mfkiwl/ADC_Test-icd40hx/doc/vm_mini-master/images/UoFq0qp.jpg

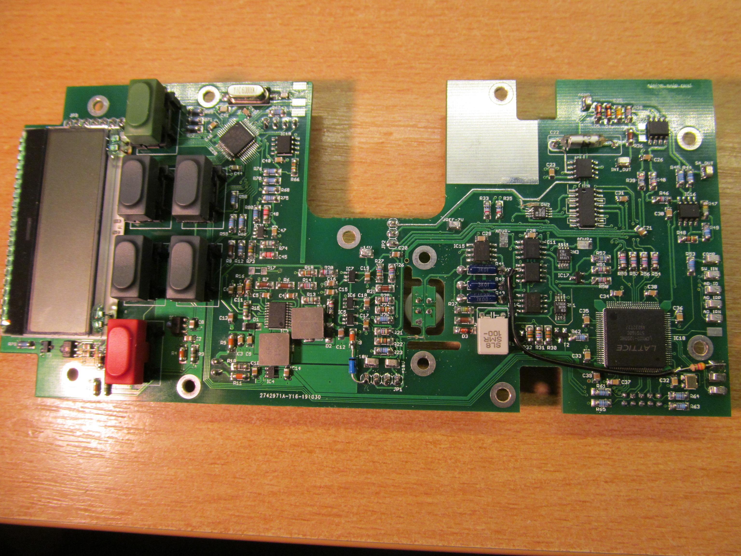
doc/vm_mini-master/images/UoFq0qp.jpg
