mfkiwl/ADC_Test-icd40hx/doc/vm_mini-master/images/A4J0f3j.jpg

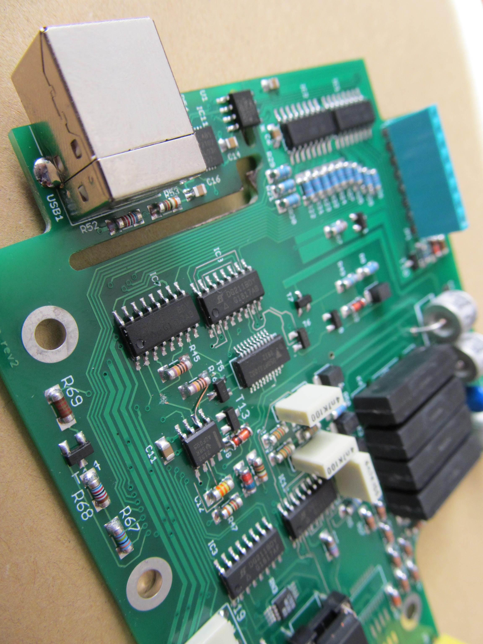
doc/vm_mini-master/images/A4J0f3j.jpg
