mfkiwl/ADC_Test-icd40hx/doc/vm_mini-master/images/3wzWLv2.jpg

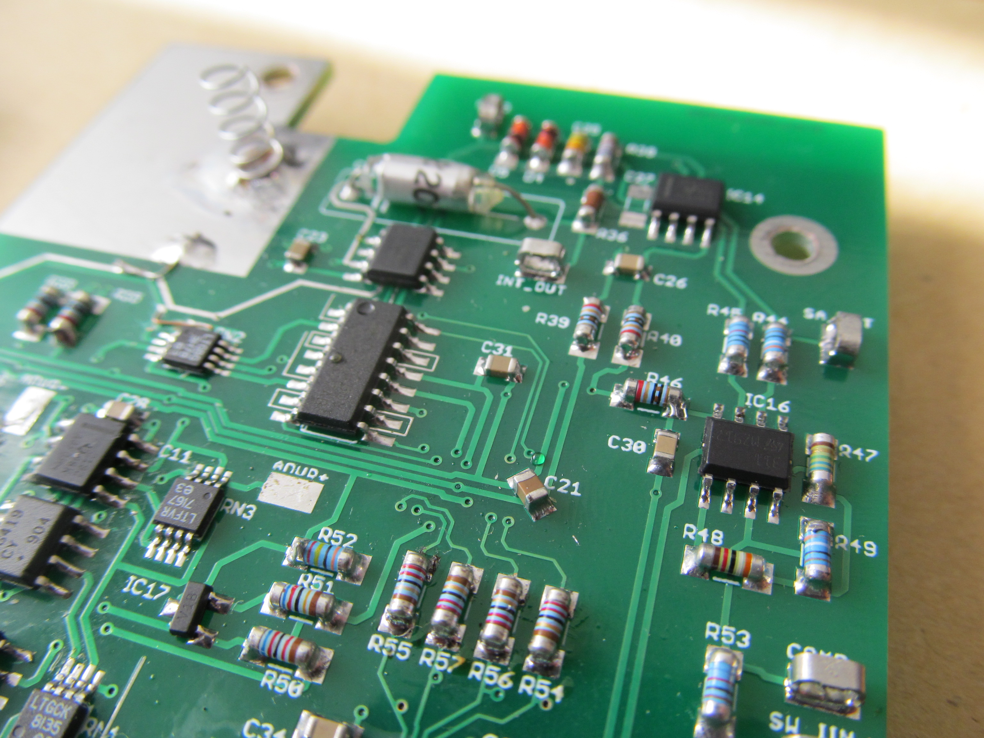
doc/vm_mini-master/images/3wzWLv2.jpg
