mfkiwl/ADC_Test-icd40hx/doc/vm_mini-master/images/9xUZhGH.jpg

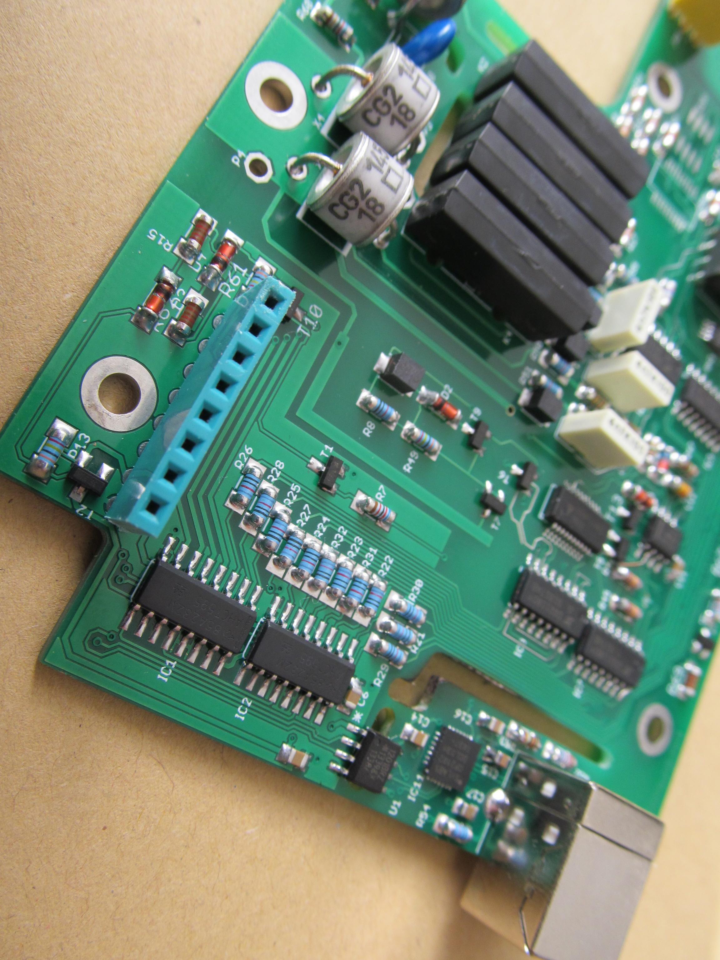
doc/vm_mini-master/images/9xUZhGH.jpg
