mfkiwl/ADC_Test-icd40hx/doc/vm_mini-master/images/bQ4KAHR.jpg

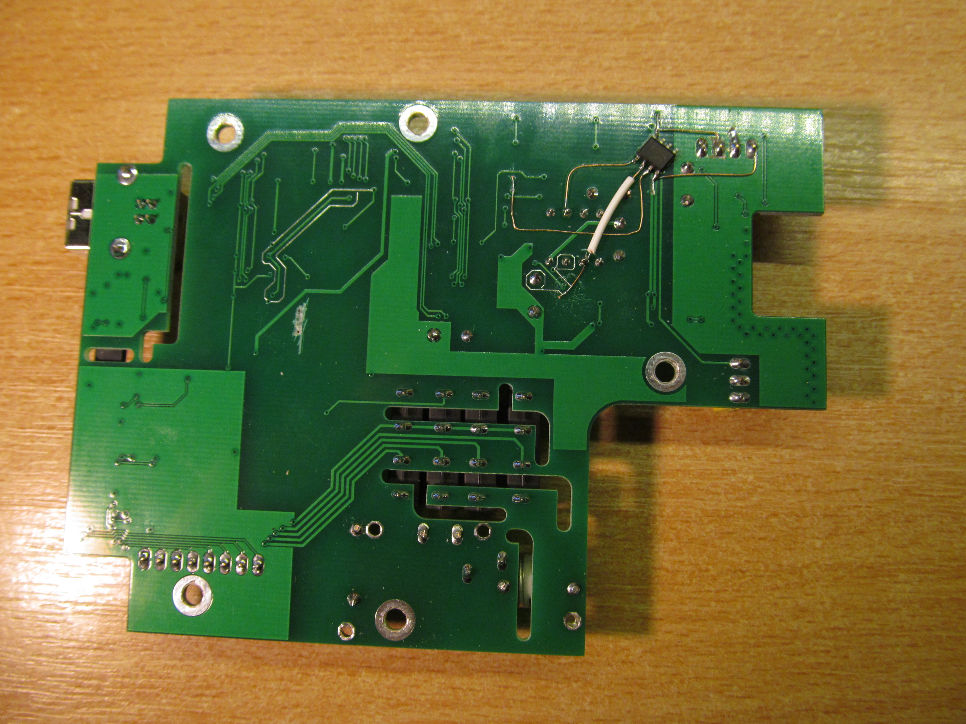
doc/vm_mini-master/images/bQ4KAHR.jpg
