mfkiwl/ADC_Test-icd40hx/doc/vm_mini-master/images/dow7Ubh.jpg

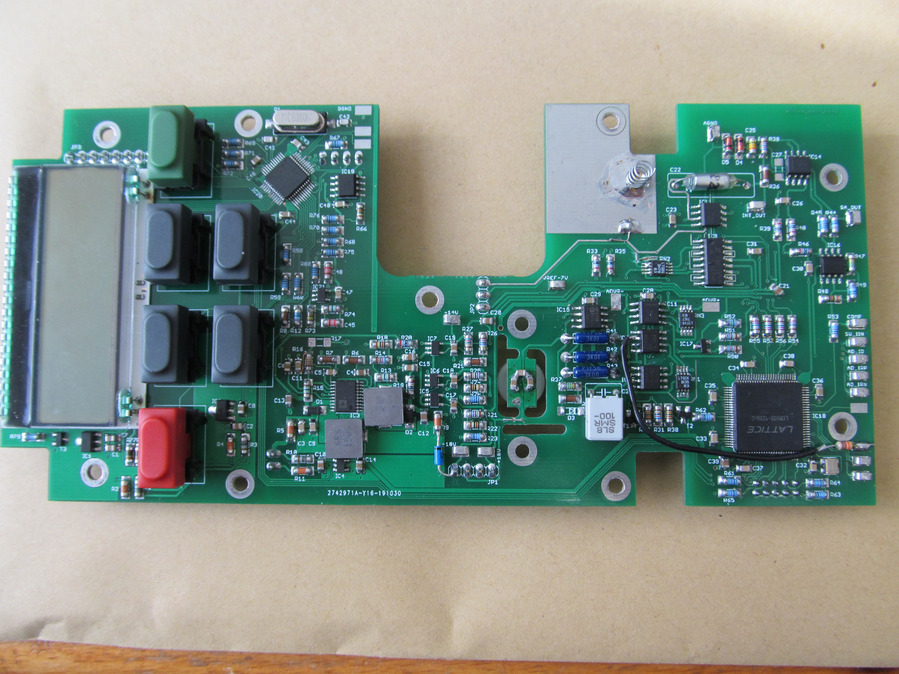
doc/vm_mini-master/images/dow7Ubh.jpg
