mfkiwl/ADC_Test-icd40hx/doc/vm_mini-master/images/f6qNfNS.jpg

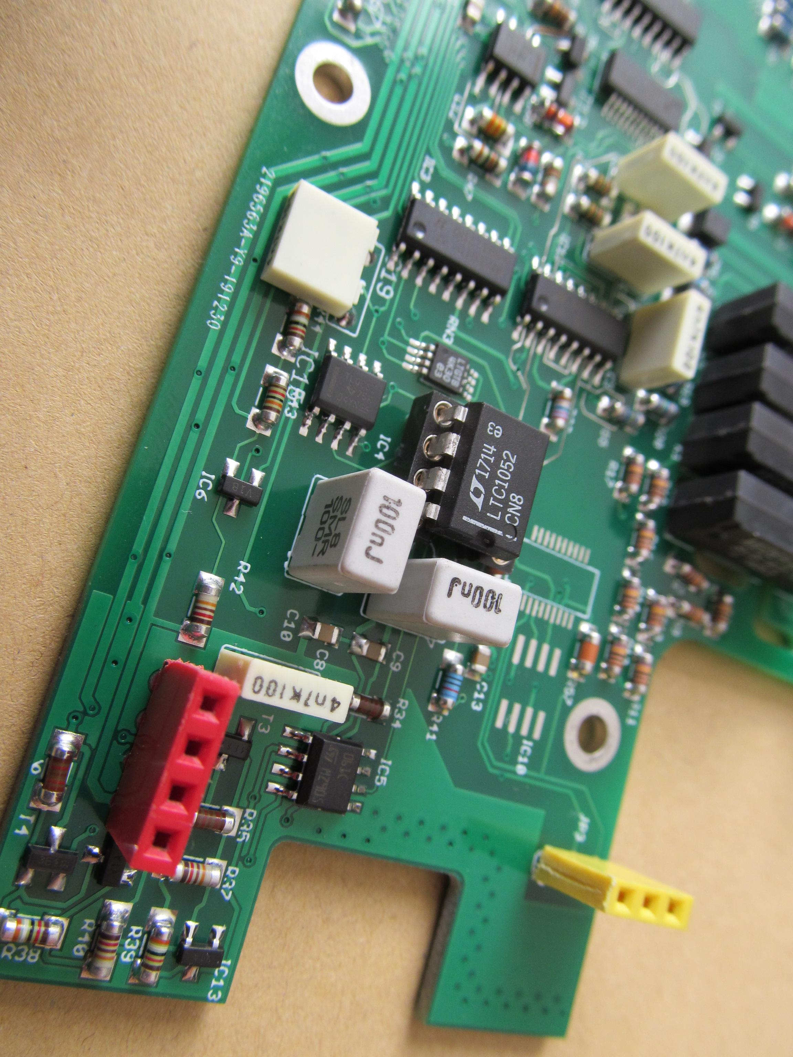
doc/vm_mini-master/images/f6qNfNS.jpg
