mfkiwl/ADC_Test-icd40hx/doc/vm_mini-master/images/KRb7c2h.jpg

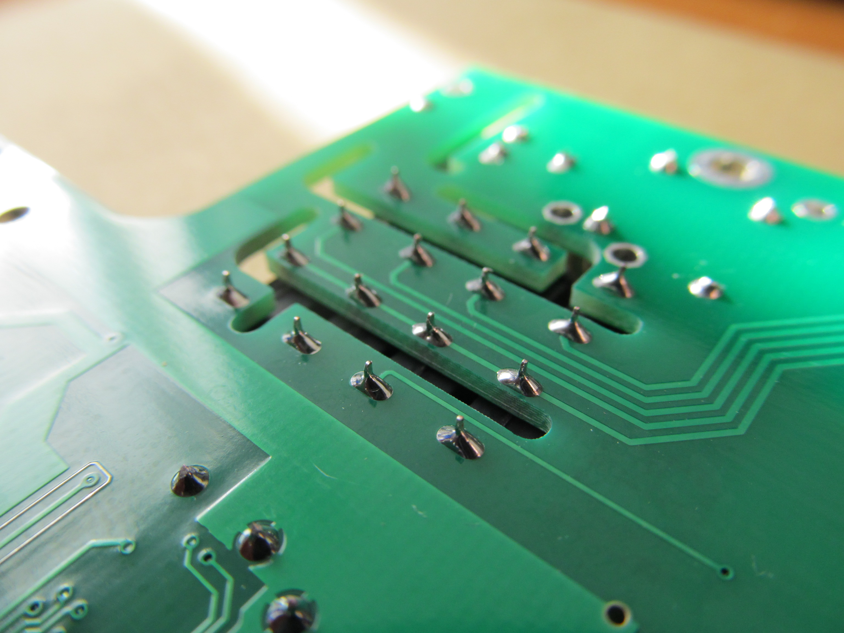
doc/vm_mini-master/images/KRb7c2h.jpg
