mfkiwl/ADC_Test-icd40hx/doc/vm_mini-master/images/mZM4EhI.jpg

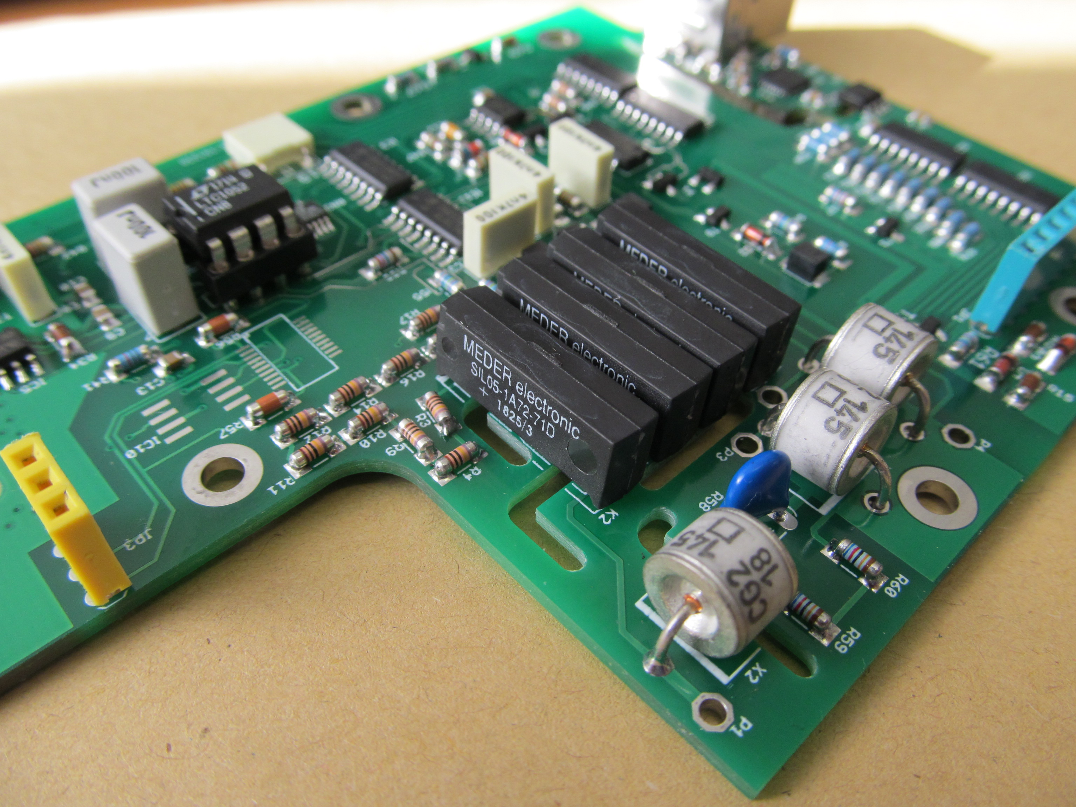
doc/vm_mini-master/images/mZM4EhI.jpg
