mfkiwl/ADC_Test-icd40hx/doc/vm_mini-master/images/Qvy92Fx.jpg

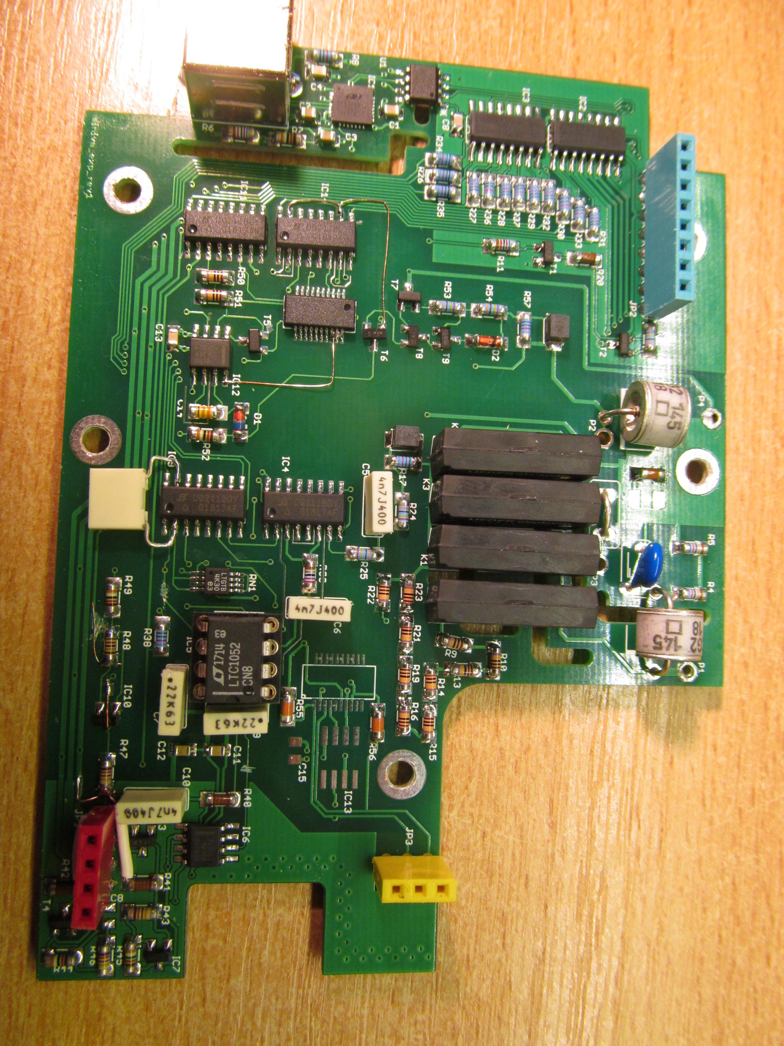
doc/vm_mini-master/images/Qvy92Fx.jpg
