mfkiwl/ADC_Test-icd40hx/doc/vm_mini-master/images/RaeT1ON.jpg

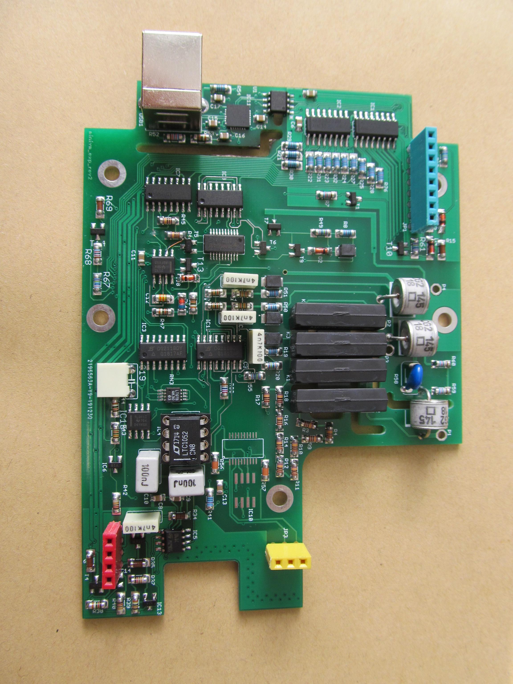
doc/vm_mini-master/images/RaeT1ON.jpg
