mfkiwl/ADC_Test-icd40hx/doc/vm_mini-master/images/WuWtkKE.jpg

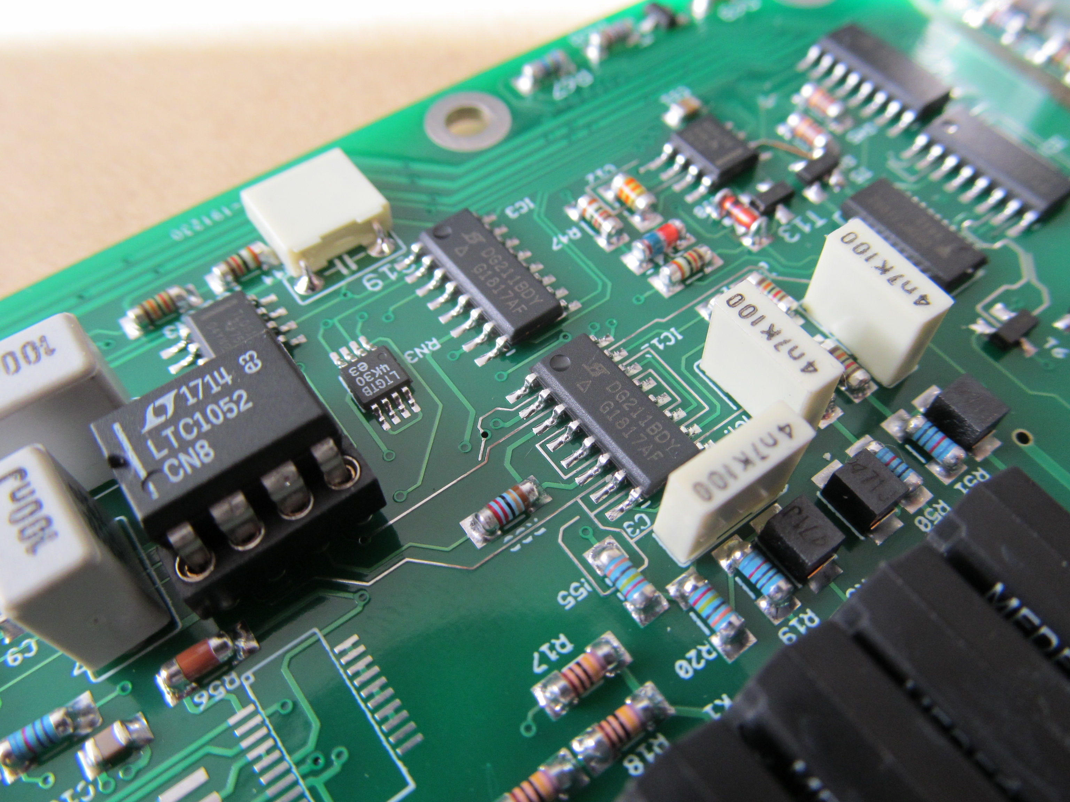
doc/vm_mini-master/images/WuWtkKE.jpg
