mfkiwl/ADC_Test-icd40hx/doc/vm_mini-master/images/ZoOjUOi.jpg

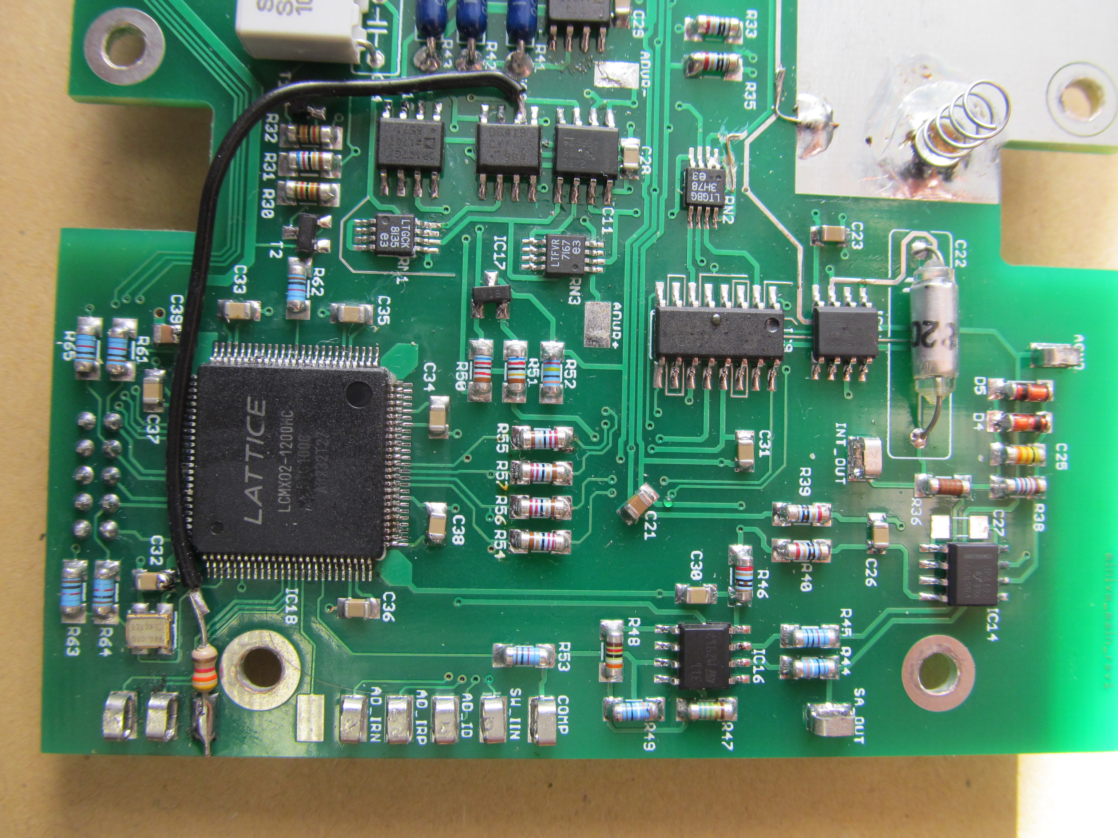
doc/vm_mini-master/images/ZoOjUOi.jpg
