mfkiwl/ADC_Test-icd40hx/doc/vm_mini-master/pcb_eagle/kind_of_BOM/BOM_vm_mini_exp4a.ods

Qty | Value | Package | Parts | dodavatel | link
2 |  | EPCOS_N81 | X1, X2 | TME | https://www.tme.eu/sk/details/cg2-145l/tht-bleskoistky/littelfuse/cg2145l/
1 |  | 1X03 | JP3 | OK
1 |  | 1X04 | JP1 | OK
1 |  | 1X08 | JP2 | OK
1 |  | TE5 | F1 | TME | https://www.tme.eu/sk/details/mf-r050/polymerove-poistky-tht/bourns/
2 | 0R | R_MINIMELF | R55, R56 | E
2 | 100n | C050-025X075 | C7, C9 | TME | https://www.tme.eu/sk/details/smr5104j100j03/polypropylenove-kondenzatory-standardne/kemet/smr5104j100j03l16-5cbulk/
7 | 100n | R0805 | C1, C4, C8, C11, C12, C13, C15 | OK
4 | 12k | R_MINIMELF | R20, R40, R41, R42 | OK
12 | 1M | R_MINIMELF | R9, R10, R13, R14, R15, R16, R19, R21, R22, R23, R50, R51 | E
2 | 1u | R0805 | C2, C3 | OK
5 | 240k | R_MINIMELF | R18, R24, R25, R53, R54 | OK
1 | 330p | R_MINIMELF | C14 | OK
6 | 39k | R_MINIMELF | R7, R44, R45, R48, R49, R52 | OK
3 | 4n7 | C050-025X075 | C5, C6, C10 | TME | https://www.tme.eu/sk/details/mkp2-47n_250-r-5/polypropylenove-kondenzatory-standardne/wima/mkp2f024701c00jssd/
2 | 620K | R_MINIMELF | R4, R5 | OK
17 | 620R | R_MINIMELF | R2, R8, R17, R26, R27, R28, R29, R30, R31, R32, R33, R34, R35, R36, R37, R38, R57 | OK
3 | 62k | R_MINIMELF | R6, R11, R39 | OK
1 | 6v8 | SOD80C | D1 | TME | https://www.tme.eu/sk/details/bzv55-b6v8.115/zenerove-diody-smd/nexperia/
2 | 74AHCT595 | SO16 | IC2, IC3 | MOUS | https://www.mouser.sk/ProductDetail/Texas-Instruments/SN74AHCT595DR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
3 | 93k | R_MINIMELF | R43, R46, R47 | E
1 | AD706 | SO08 | IC12 | MOUS | https://www.mouser.sk/ProductDetail/Texas-Instruments/OPA2192IDR
1 | ADUM1201ARZ | SOIC127P600X175-8N | U1 | OK
1 | BAV103 | SOD-80 | D2 | TME | https://www.tme.eu/sk/details/bav103-gs08/univerzalne-diody-smd/vishay/
2 | BC847 | SOT23 | T1, T3 | OK
2 | BC857 | SOT23 | T2, T4 | OK
2 | BF823 | SOT23 | T8, T9 | TME | https://www.tme.eu/sk/details/bf823.215/tranzistory-pnp-smd/nexperia/
1 | CP2102 | MLP28 | IC1 | MOUS | https://www.mouser.sk/ProductDetail/Silicon-Labs/CP2102N-A02-GQFN28R
4 | DG211 | SO-16 | IC4, IC9, IC11, IC14 | TME | https://www.tme.eu/sk/details/dg211bdy/multiplexory-a-analogove-prepinace/vishay/
4 | HE3621 | HE3621 | K1, K2, K3, K4 | TME | https://www.tme.eu/sk/details/ms05-1a87-75dhr/elektromagneticke-rele-jazyckove/meder/
3 | INDUCTOR_GEN1210 | 1210 | U$2, U$4, U$5 | TME | https://www.tme.eu/sk/details/nlv10jt471/tlmivky-smd-1210/viking/
1 | JFET_N | SOT23 | T7 | TME | https://www.tme.eu/sk/details/mmbfj201/tranzistory-s-kanalom-n-smd/on-semiconductor-fairchild/
1 | LT5400 | MSOP8-EP | RN1 | OK | 9k+1k
1 | LTC1052 | DIL08 | IC5 | OK
1 | MMBFJ110 | SOT23 | T5 | MOUS | https://www.mouser.sk/ProductDetail/ON-Semiconductor-Fairchild/MMBFJ110
1 | MMBFJ175 | SOT23 | T6 | TME | https://www.tme.eu/sk/details/mmbfj175/tranzistory-s-kanalom-p-smd/on-semiconductor-fairchild/
1 | OPA177 | SO08 | IC13 | MOUS | https://www.mouser.sk/ProductDetail/Texas-Instruments/OPA192IDR
2 | OSOP20 | OSOP20 | RN2, RN3 | MOUS | https://www.mouser.sk/ProductDetail/Vishay-Thin-Film/OSOPTA1002AT1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
1 | S05K175 | S05K175 | R3 | TME | https://www.tme.eu/sk/details/siov-s05k95/tht-varistory/epcos/b72205s0950k101/
1 | TL061 | SO08 | IC6 | TME | https://www.tme.eu/sk/details/tl061id/operacne-zosilnovace-smd/texas-instruments/
3 | TLV431 | SOT23 | IC7, IC8, IC10 | TME | https://www.tme.eu/sk/details/tlv431afta/zdroje-napatovej-referencie-obvody/diodes-incorporated/
4 | TPPAD1-17 | P1-17 | P1, P2, P3, P4 | TODO | svorky na 4 vstupy
1 | USB-B-H | USB-B-H | USB1 | OK
