mfkiwl/ADC_Test-icd40hx/doc/vm_mini-master/pcb_eagle/kind_of_BOM/BOM_vm_mini_main3_1.ods

Qty | Value | Package | Parts | dodavatel | link
1 |  | HC49UP | Q1 | OK
2 |  | MINIMELF | D1, D2 | TME | https://www.tme.eu/sk/details/mbr0540t1g/diody-schottky-smd/on-semiconductor/
1 |  | 1X03 | JP2 | OK
1 |  | 1X04 | JP1 | OK
1 |  | 1X04/90 | JP4 | OK
1 |  | 1X08 | JP3 | OK
4 | 0R | R_MINIMELF | R2, R4, R9, R11 | E
1 | 100n | C050-035X075 | C24 | TME | https://www.tme.eu/sk/details/smr5104j100j03/polypropylenove-kondenzatory-standardne/kemet/smr5104j100j03l16-5cbulk/
21 | 100n | R0805 | C3, C9, C11, C23, C26, C28, C29, C30, C31, C32, C33, C34, C35, C36, C37, C38, C40, C43, C44, C46, C47 | OK
7 | 10R | R_MINIMELF | R19, R20, R33, R35, R39, R40, R46 | E
3 | 10u | R0805 | C12, C13, C39 | OK
3 | 120k | R_MINIMELF | R16, R30, R32 | OK
6 | 12k | R_MINIMELF | R6, R7, R12, R29, R34, R36 | OK
4 | 1R8 | R_MINIMELF | R1, R3, R5, R10 | E
2 | 1n8 | R_MINIMELF | C45, C48 | OK
22 | 1u | R0805 | C1, C2, C6, C7, C8, C10, C14, C15, C16, C17, C18, C19, C20, C21, C49, C50, C51, C52, C53, C54, C55, C56 | OK
1 | 22-05-7028-02 | 7395-02 | J1 | OK
1 | 240k | R_MINIMELF | R52 | OK
3 | 2M4 | R_MINIMELF | R13, R15, R74 | E
1 | 2n2 | C150-054X183 | C22 | OK | polystyren
1 | 33p | R_MINIMELF | C25 | OK
2 | 33p | R0805 | C41, C42 | OK
2 | 390R | R_MINIMELF | R77, R79 | OK
5 | 39k | R_MINIMELF | R18, R22, R24, R48, R66 | OK
2 | 3k01 | R_TR191 | R41, R42 | MOUS | https://www.mouser.sk/ProductDetail/Vishay-Dale/PTF563K0100BZBF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
3 | 3k9 | R_MINIMELF | R8, R44, R49 | OK
1 | 47k | R_MINIMELF | R26 | E
1 | 47n | R0805 | C4 | TME | https://www.tme.eu/sk/details/c0805c473j5rac/kondenzatory-mlcc-smd-0805/kemet/c0805c473j5ractu/
2 | 620R | R_MINIMELF | R45, R80 | OK
5 | 620k | R_MINIMELF | R21, R25, R27, R31, R51 | OK
2 | 62R | R_MINIMELF | R37, R47 | E
3 | 62k | R_MINIMELF | R14, R38, R50 | OK
1 | 68n | R0805 | C5 | TME | https://www.tme.eu/sk/details/c0805c683k5rac/kondenzatory-mlcc-smd-0805/kemet/c0805c683k5ractu/
1 | 6M2 | R_MINIMELF | R73 | OK
24 | 6k2 | R_MINIMELF | R23, R28, R53, R54, R55, R56, R57, R58, R59, R60, R61, R62, R63, R64, R65, R67, R68, R69, R70, R71, R72, R75, R76, R78 | OK
1 | 6k95 | R_TR191 | R43 | MOUS | https://www.mouser.sk/ProductDetail/Vishay-Dale/PTF567K0000BYEK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
1 | 93k | R_MINIMELF | R17 | E
1 | ADP5070 | TSSOP20-EP | IC3 | SAM
1 | ADP7142 | SOT23-5L | IC5 | MOUS | https://www.mouser.sk/ProductDetail/Analog-Devices-Linear-Technology/ADP7142AUJZ-R7
2 | ADP7182 | SOT23-5L | IC6, IC7 | SAM
3 | BAV103 | SOD-80 | D3, D4, D5 | TME | https://www.tme.eu/sk/details/bav103-gs08/univerzalne-diody-smd/vishay/
2 | BC847 | SOT23 | T1, T3 | OK
1 | BC857 | SOT23 | T2 | OK
1 | DG211B | SO16 | IC9 | TME | https://www.tme.eu/sk/details/dg211bdy/multiplexory-a-analogove-prepinace/vishay/
1 | DG419DJD | SO08 | IC8 | MOUS | https://www.mouser.sk/ProductDetail/Vishay-Siliconix/DG419LEDY-T1-GE4
1 | DNP | R_MINIMELF | C27 | OK
1 | EADOGM132-5 | EADOGM | LCD1 | TODO
1 | FLASH_SPI | SO-08 | IC19 | TME | https://www.tme.eu/sk/details/at25sf081-sshdt/pamate-flash-seriove/adesto/at25sf081-sshd-t/
1 | IDC_10_2MM | IDC_20_10P | CON1 | TME | https://www.tme.eu/sk/details/ds1014-10sf1b/konektory-idc/connfly/ | https://www.tme.eu/sk/details/ds1017-10ma2/konektory-idc/connfly/
2 | SRP7030 | BOURNS_SRP7030 | L1, L2 | MOUS | https://www.mouser.sk/ProductDetail/Bourns/SRP7030CA-3R3M | https://www.mouser.sk/ProductDetail/Bourns/SRP7030CA-6R8M
1 | LM311D | SO08 | IC16 | TME | https://www.tme.eu/sk/details/lm311d-st/komparatory-smd/stmicroelectronics/lm311d/
1 | LM399H | TO39/4 | IC13 | OK
1 | LT5400-100k-100k | MSOP8-EP | RN2 | OK
1 | LT5400-10k+10k | MSOP8-EP | RN3 | OK
1 | LT5400-5k-1k | MSOP8-EP | RN1 | SAM
1 | MACHXO2-1200 | TQFP100 | IC18 | OK
1 | MCP1703-33 | SOT89 | IC2 | TME | https://www.tme.eu/sk/details/mcp1703t-3302e_mb/stabilizatory-napatia-neregulovane-ldo/microchip-technology/
1 | MCP1703-50\ | SOT89 | IC1 | TME | https://www.tme.eu/sk/details/mcp1703at-5002e_mb/stabilizatory-napatia-neregulovane-ldo/microchip-technology/
1 | MCP6041 | SOT23-5L | IC21 | OK
1 | NJM2866F33 | SOT23-5 | IC4 | MOUS | https://www.mouser.sk/ProductDetail/NJR/NJM2866F33-TE1
1 | OP184 | SO08 | IC14 | MOUS | https://www.mouser.sk/ProductDetail/Texas-Instruments/OPA192IDR
1 | OP284 | SO08 | IC11 | MOUS | https://www.mouser.sk/ProductDetail/Texas-Instruments/OPA2192IDR
1 | OPA140 | SO08 | IC12 | MOUS | https://www.mouser.sk/ProductDetail/Texas-Instruments/OPA140AIDR
2 | OPA177 | SO08 | IC10, IC15 | OK
1 | OSC3225 | OSC_3225 | OSC1 | MOUS | https://www.mouser.sk/ProductDetail/Kyocera-Electronic-Components/KC3225A400000C30E00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
1 | STM32L152XC_LQFP48 | LQFP48 | IC20 | TME | https://www.tme.eu/sk/details/stm32l151cbt6a/mikroprocesory-st/stmicroelectronics/
6 | SWITCH_MINI6450 | SWITCH_6450 | K1, K2, K3, K4, K5, K6 | OK
21 | TEST_PADSMD_35X2 | TP_SMD_35X2 | TP1, TP2, TP3, TP4, TP5, TP6, TP7, TP8, TP9, TP10, TP11, TP12, TP13, TP14, TP15, TP16, TP17, TP18, TP19, TP20, TP21 | MOUS | https://www.mouser.sk/ProductDetail/Harwin/S1751-46R?qs=sGAEpiMZZMsGzNf1qgY4ZDEfKDfH1s5L
1 | TL431_SOT23 | SOT23 | IC17 | TME | https://www.tme.eu/sk/details/tlv431afta/zdroje-napatovej-referencie-obvody/diodes-incorporated/
 |  |  |  | TME | 1mm IDC kabel
 |  |  |  | .
