mfkiwl/ADC_Test-icd40hx/doc/vm_mini-master/mech/LM399_cover_part2.stl

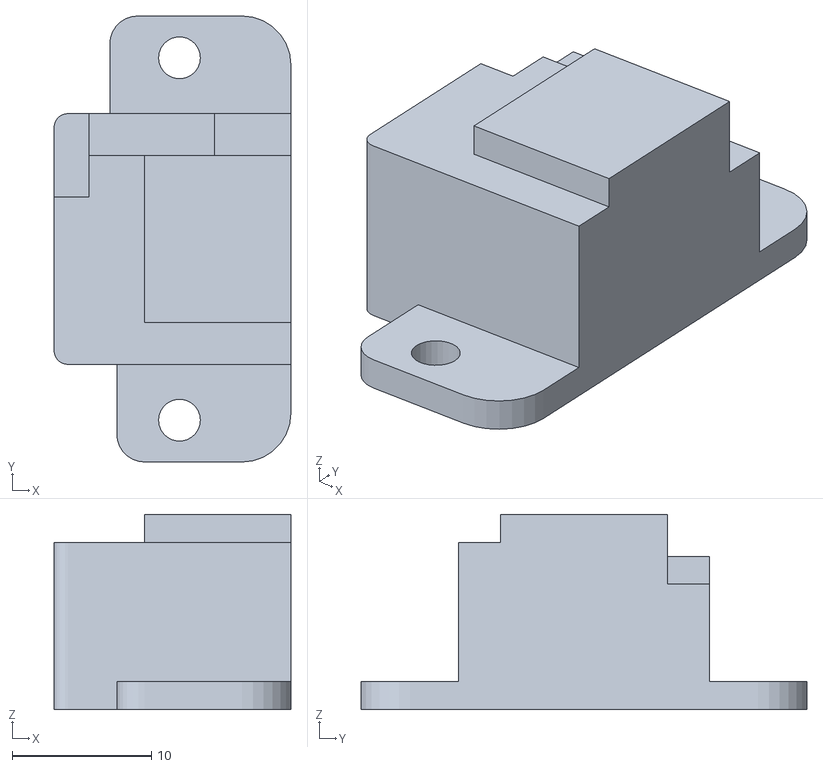
[picture p14: CAD file, 2020-10-08]
doc/vm_mini-master/mech/LM399_cover_part2.stl
17.0 x 32.0 x 14.0
