mfkiwl/ADC_Test-icd40hx/doc/vm_mini-master/mech/LM399_cover_part1.stl

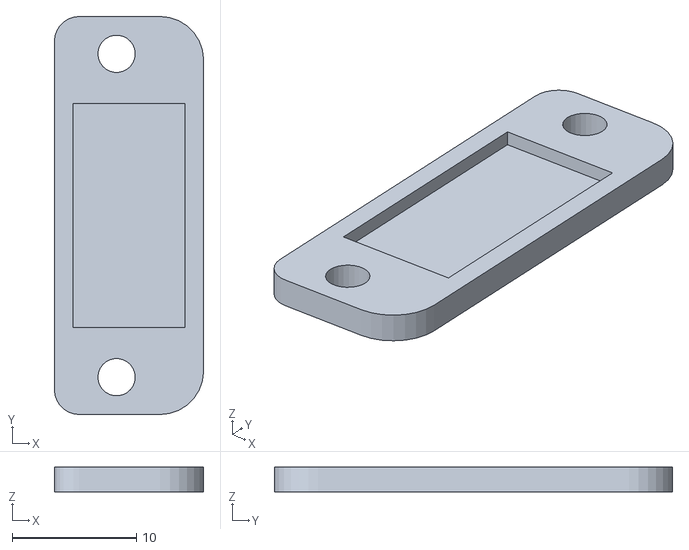
[picture p15: CAD file, 2020-10-08]
doc/vm_mini-master/mech/LM399_cover_part1.stl
12.0 x 32.0 x 2.00
