mfkiwl/ADC_Test-icd40hx/hardware/project/ADC_Test/ADC_Test_Add.ods

R_0603_1608Metric_Pad1.05x0.95mm_HandSolder | 1 | 3k01/.1%
SOIC-8_3.9x4.9mm_P1.27mm | 1 | LT1021-7
SOT-23 | 2 | MMBTA55
D_SOD-523 | 5 | BZT585B15TQ-13
R_0603_1608Metric_Pad1.05x0.95mm_HandSolder | 4 | 4k7/.1%
R_0603_1608Metric_Pad1.05x0.95mm_HandSolder | 10 | 0
 | 1 | 9012
D_SOD-123 | 1 | 1N4148W
 |  | 10p
R_0603_1608Metric_Pad1.05x0.95mm_HandSolder |  | 10k
SOT-23 |  | BC847
 | 20 | 5050462-8
