mfkiwl/ADC_Test-icd40hx/doc/schem_pdf_rev11.pdf

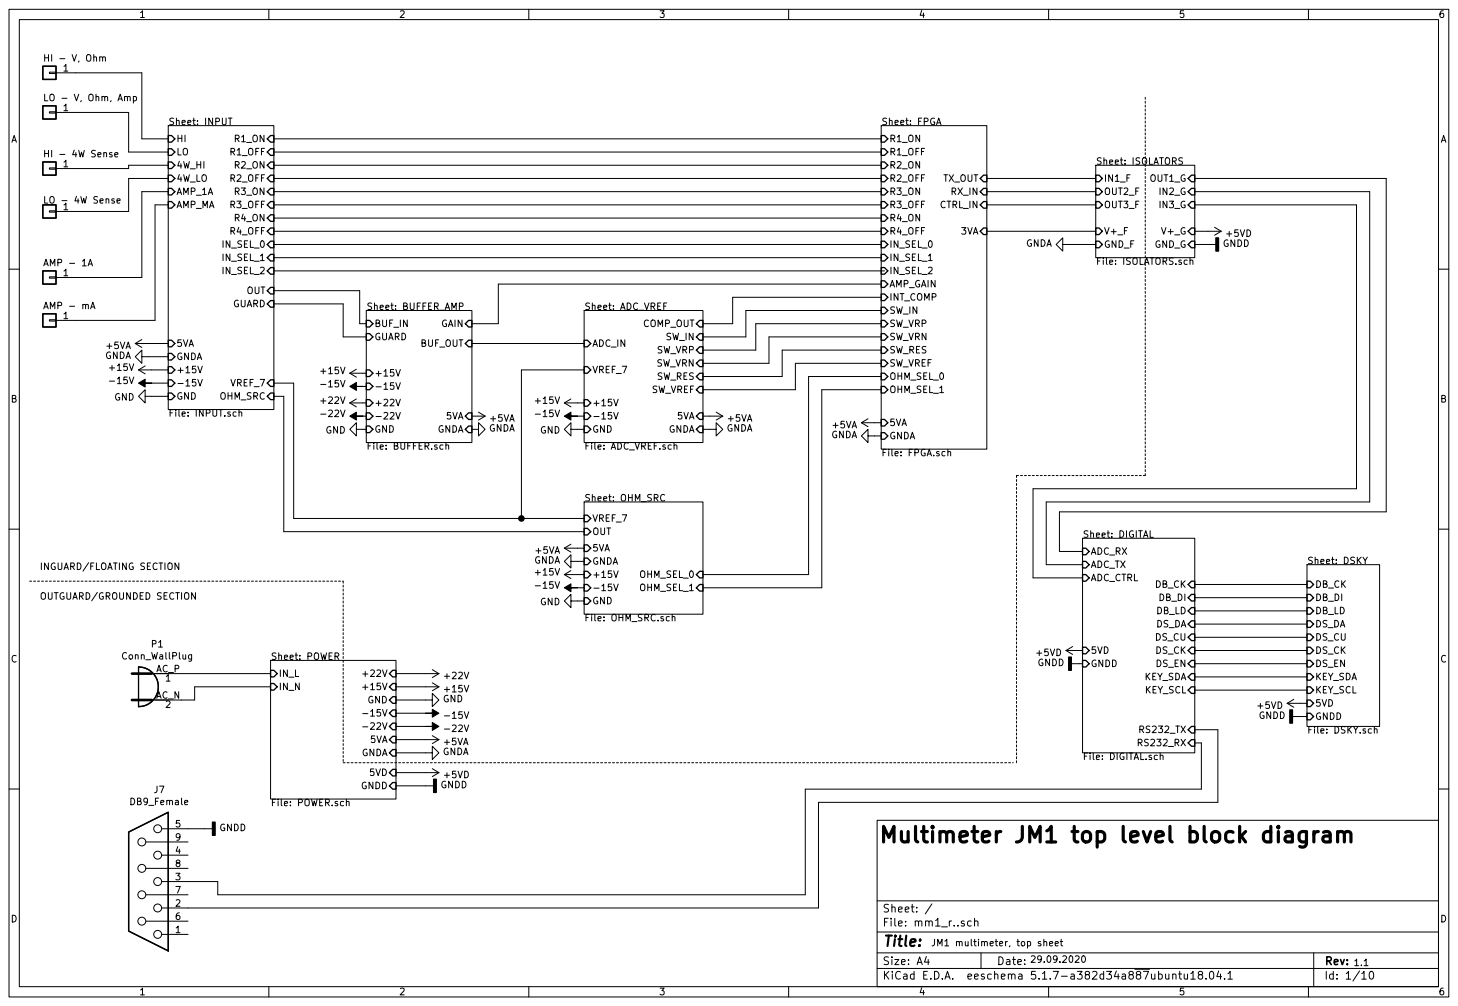
[picture p16: page 1]

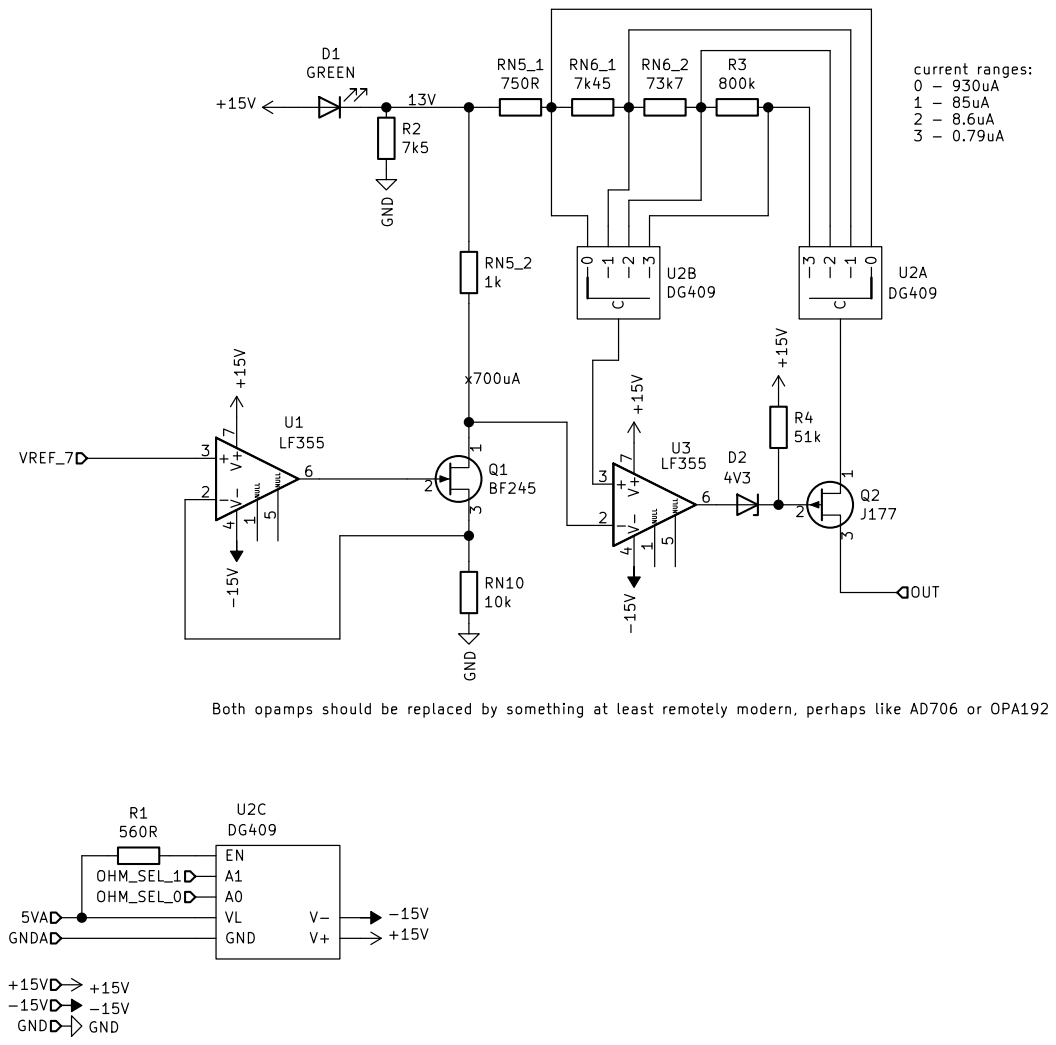
[picture p17: page 2]

Both opamps should be replaced by something at least remotely modern, perhaps like AD706 or OPA192

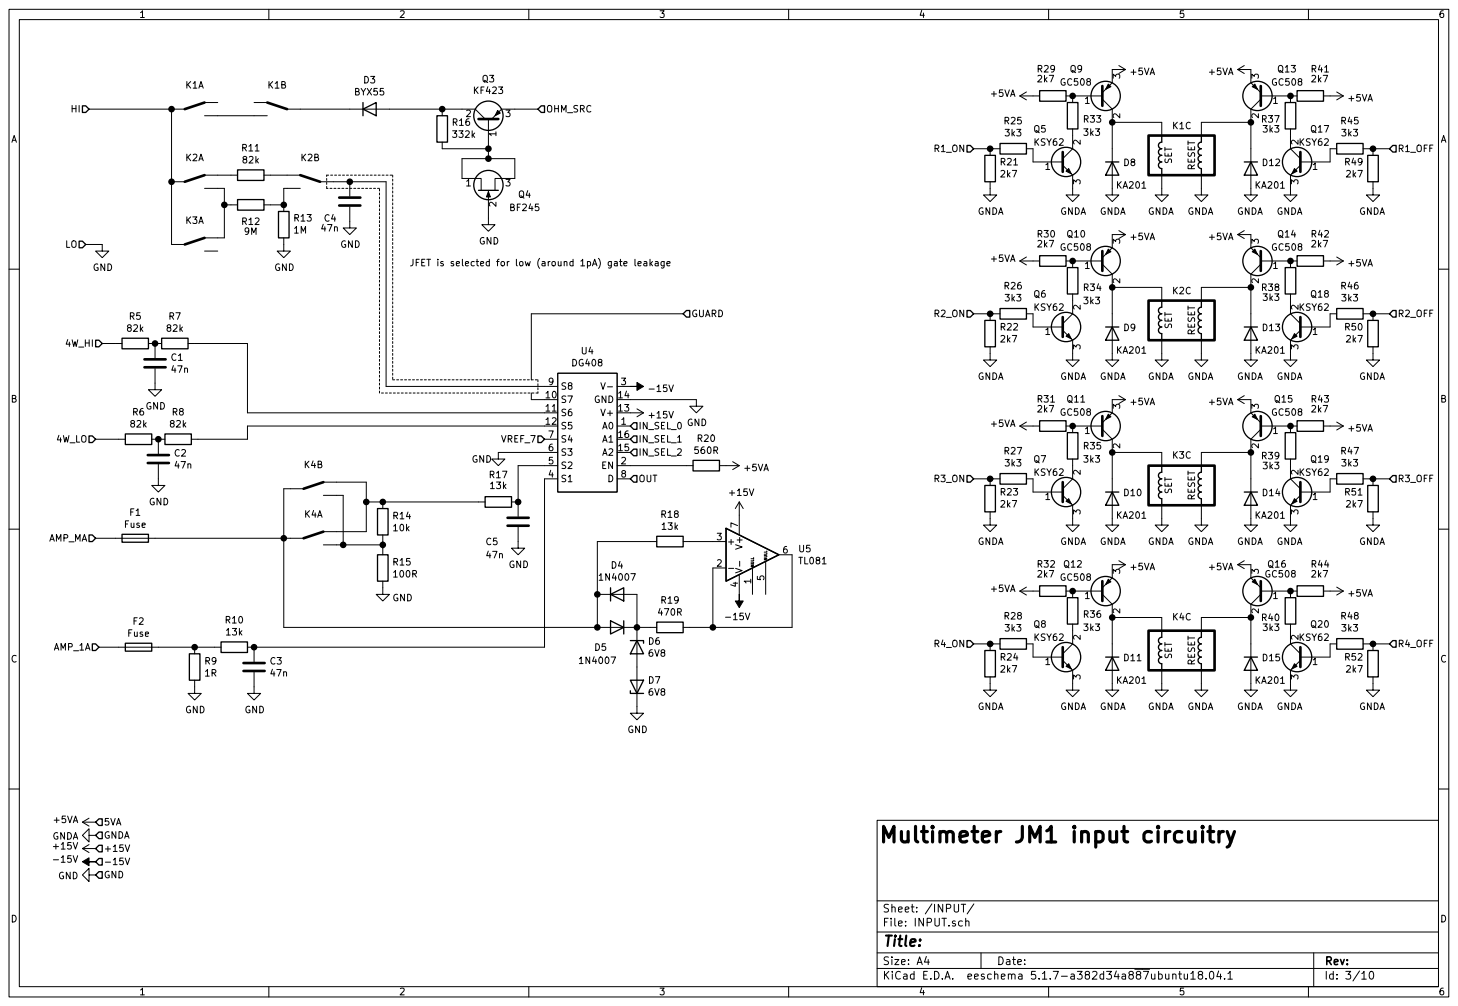
[picture p18: page 3]

2k7 RESET SET K1C RESET SET K2C

Id: 3/10 Title: File: INPUT.sch Sheet: /INPUT/

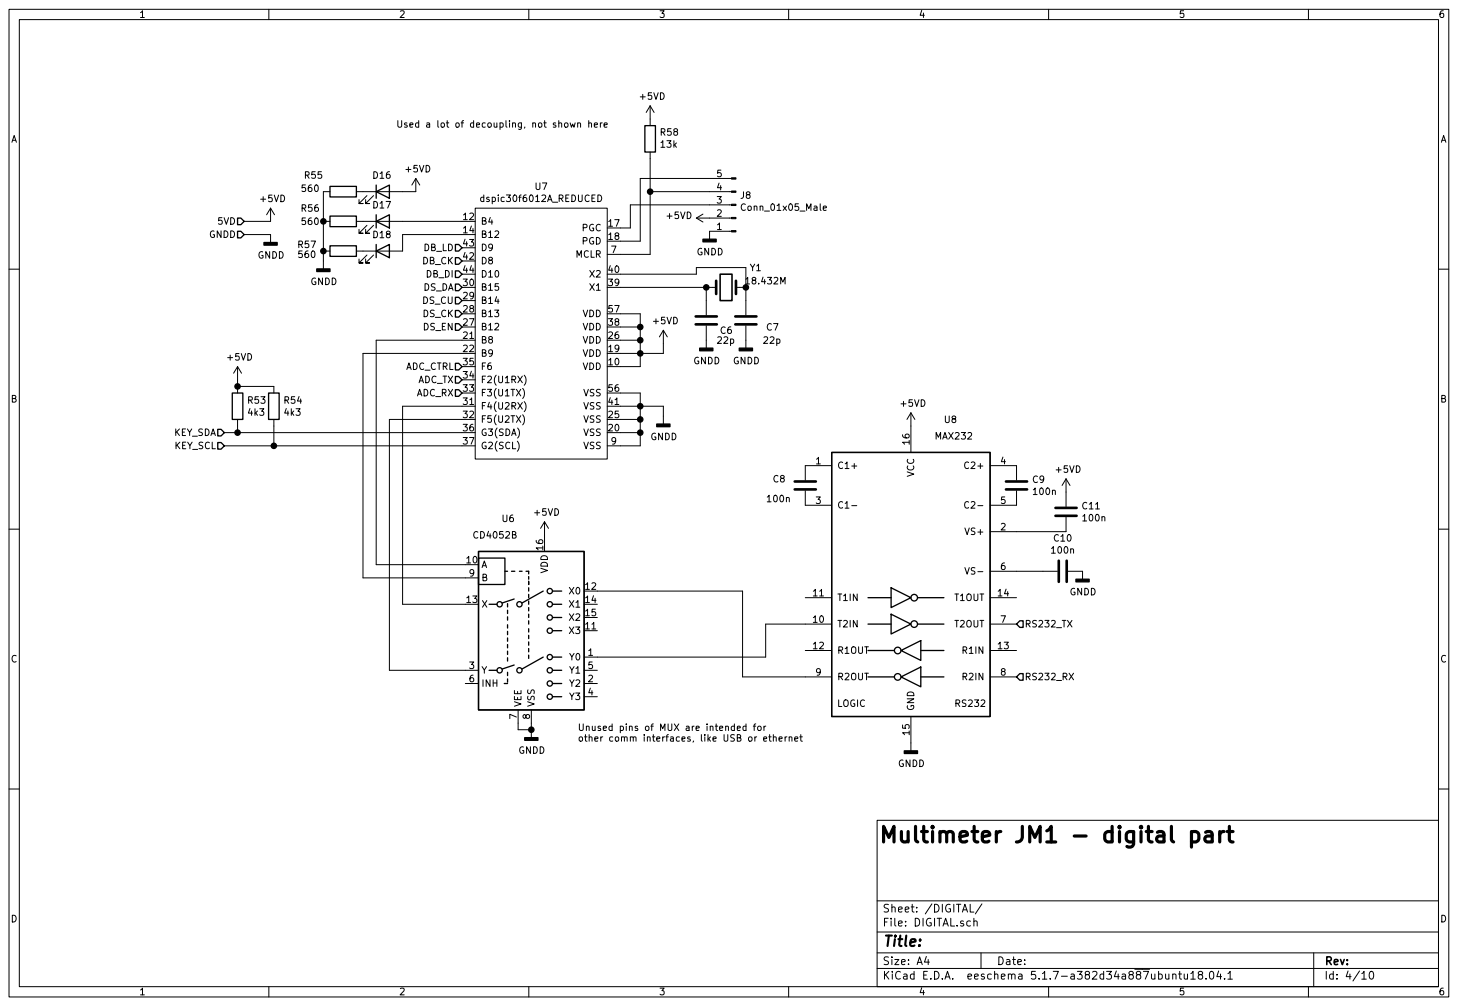
[picture p19: page 4]

Used a lot of decoupling, not shown here

Id: 4/10 Title: File: DIGITAL.sch Sheet: /DIGITAL/

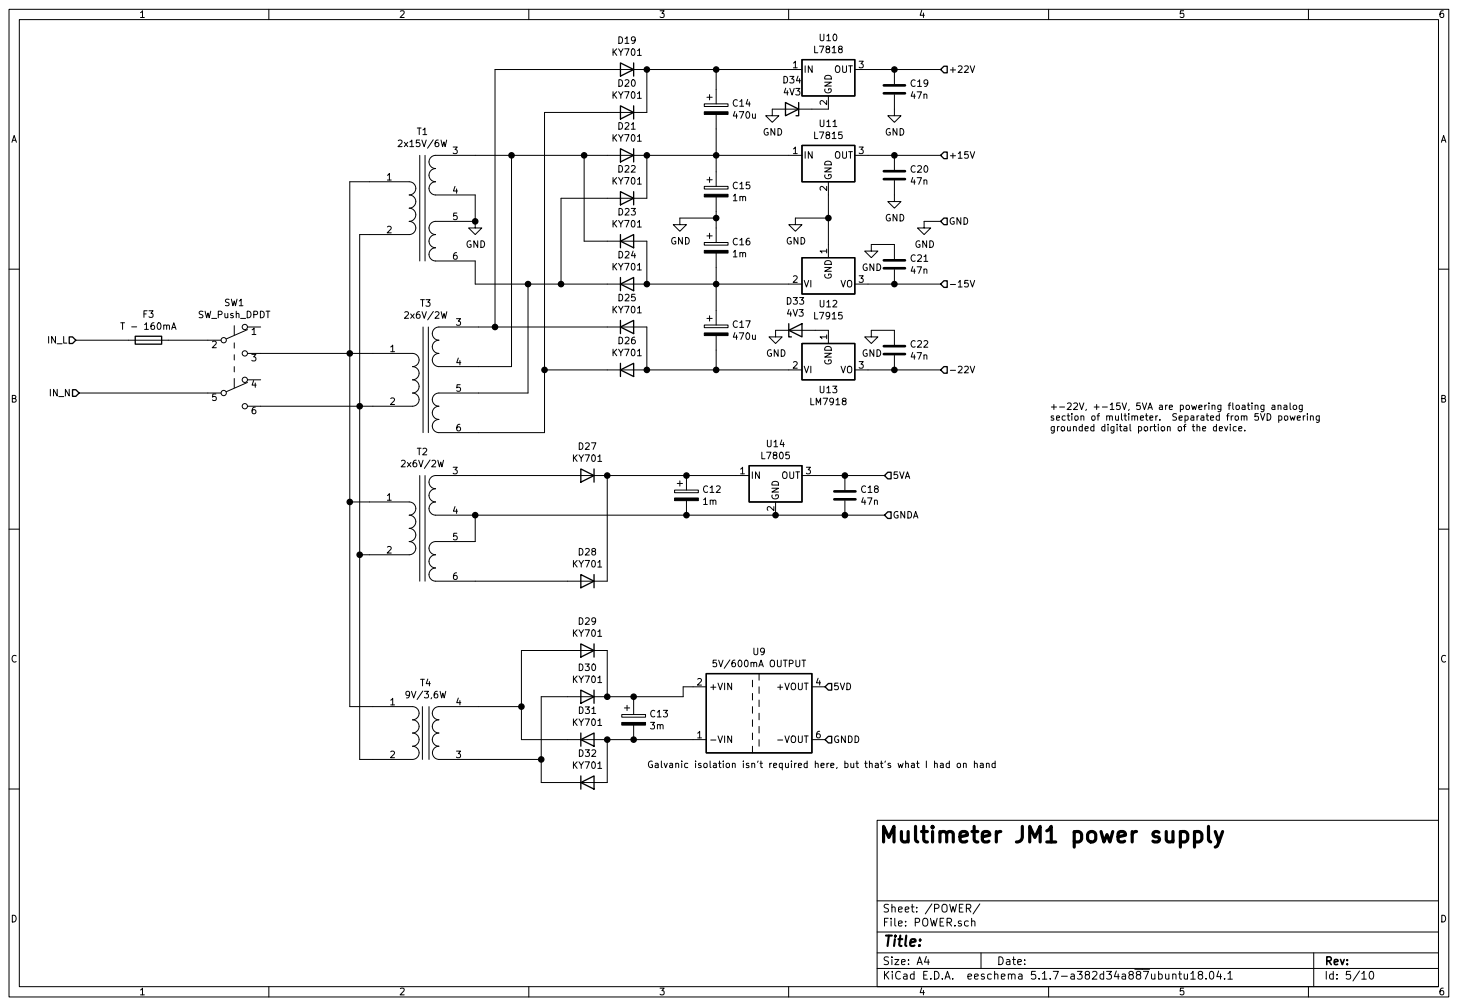
[picture p20: page 5]

+-22V, +-15V, 5VA are powering floating analog
section of multimeter. Separated from 5VD powering
grounded digital portion of the device.

Id: 5/10 Title: File: POWER.sch Sheet: /POWER/

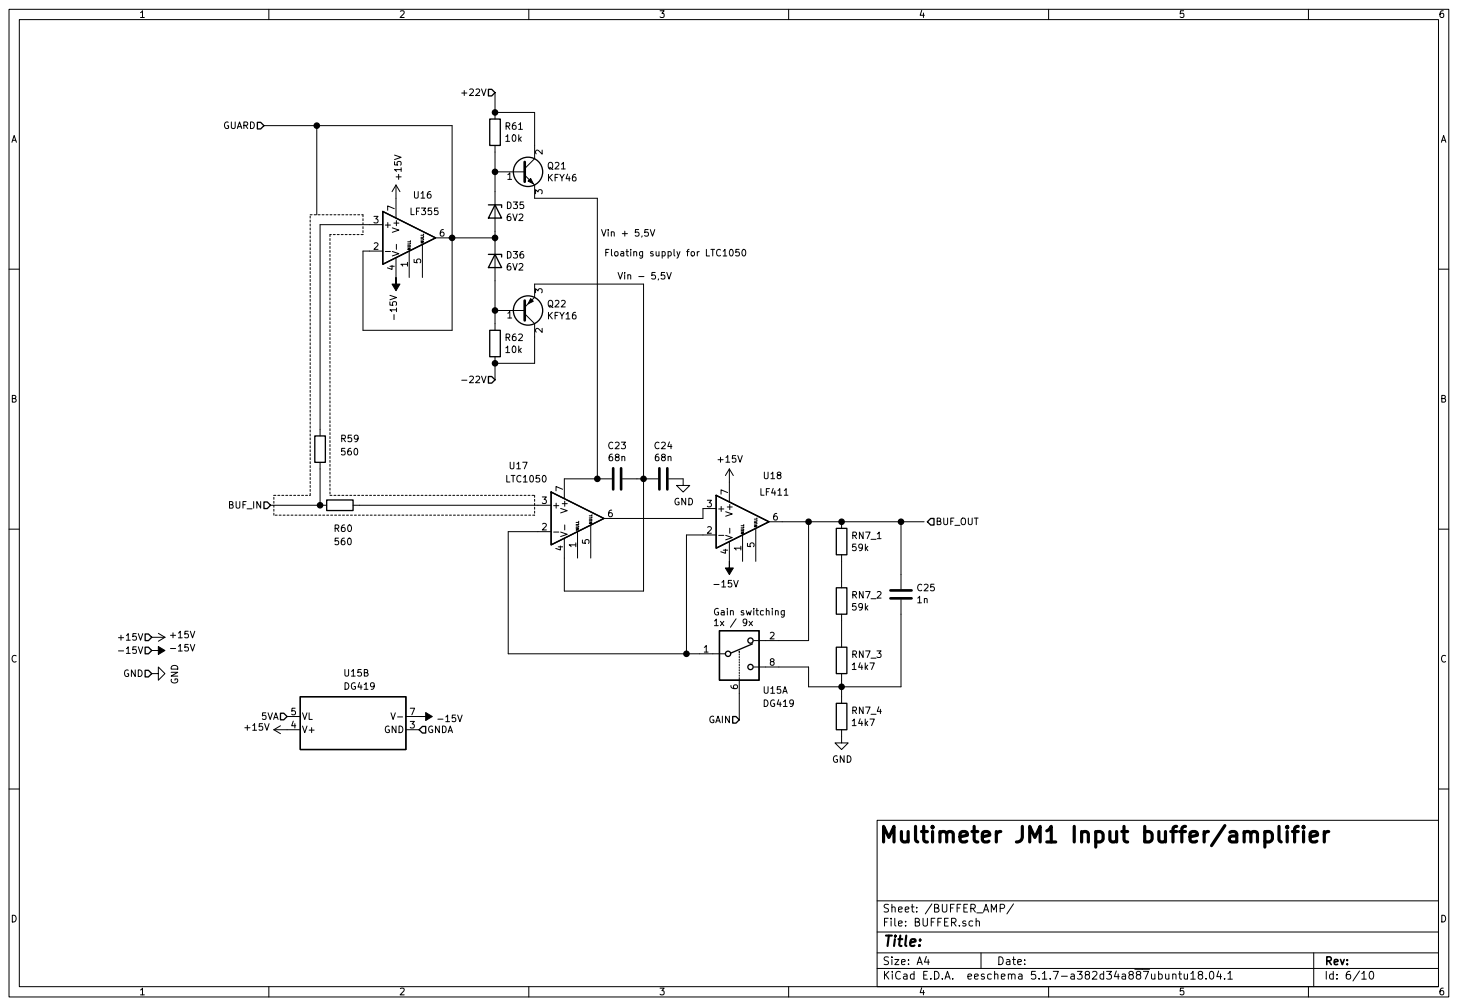
[picture p21: page 6]

Id: 6/10 Title: File: BUFFER.sch Sheet: /BUFFER_AMP/ 1

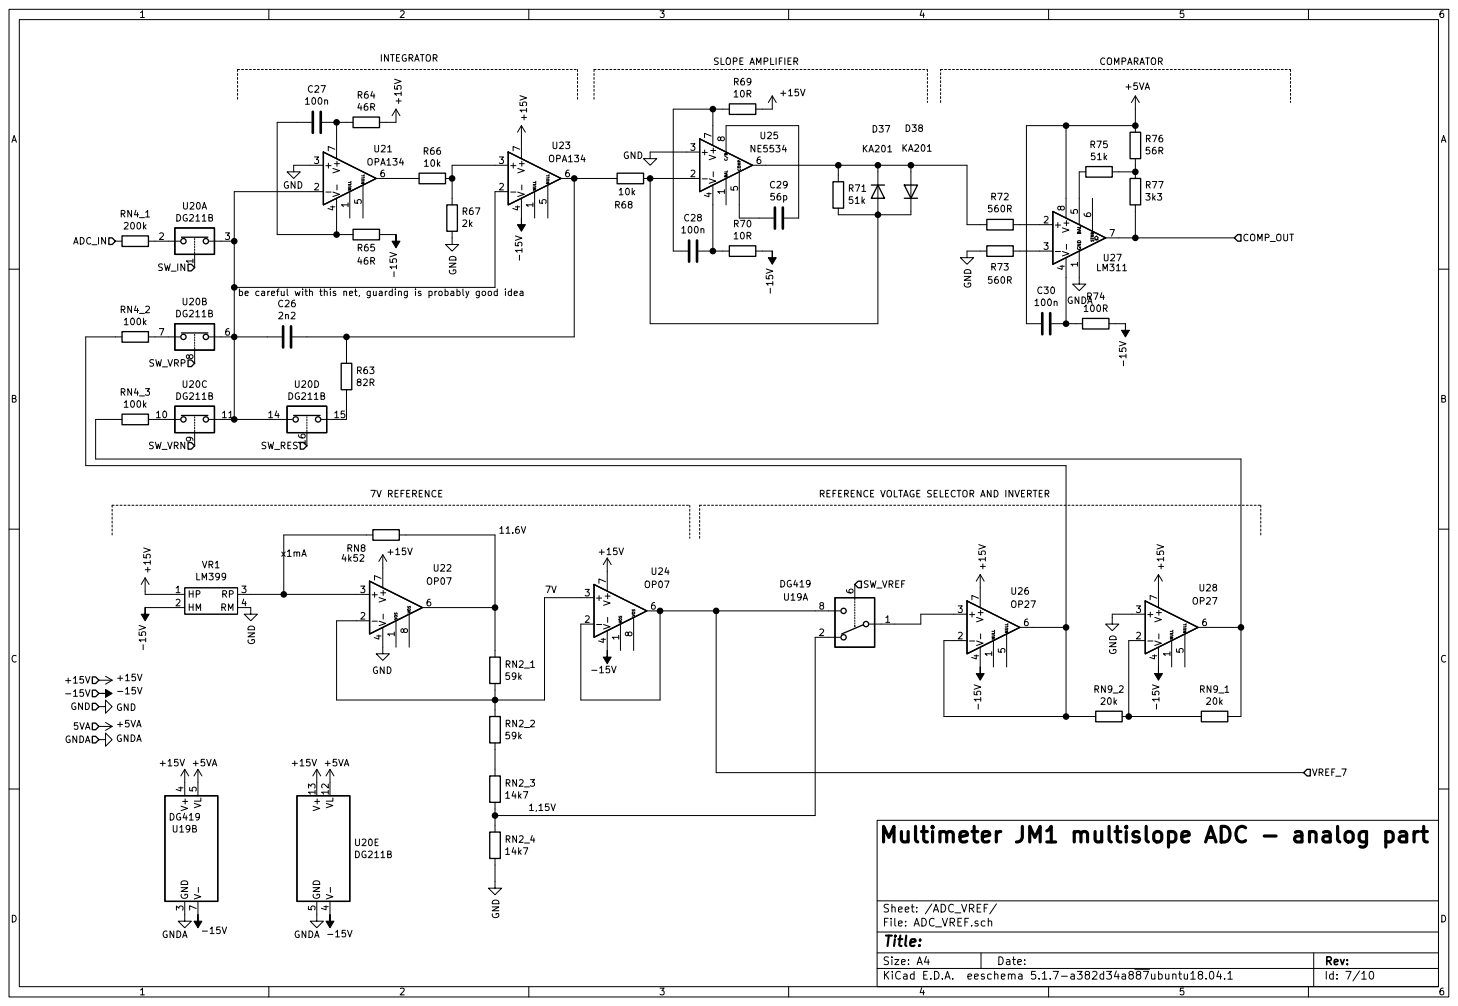
[picture p22: page 7]

be careful with this net, guarding is probably good idea

REFERENCE VOLTAGE SELECTOR AND INVERTER

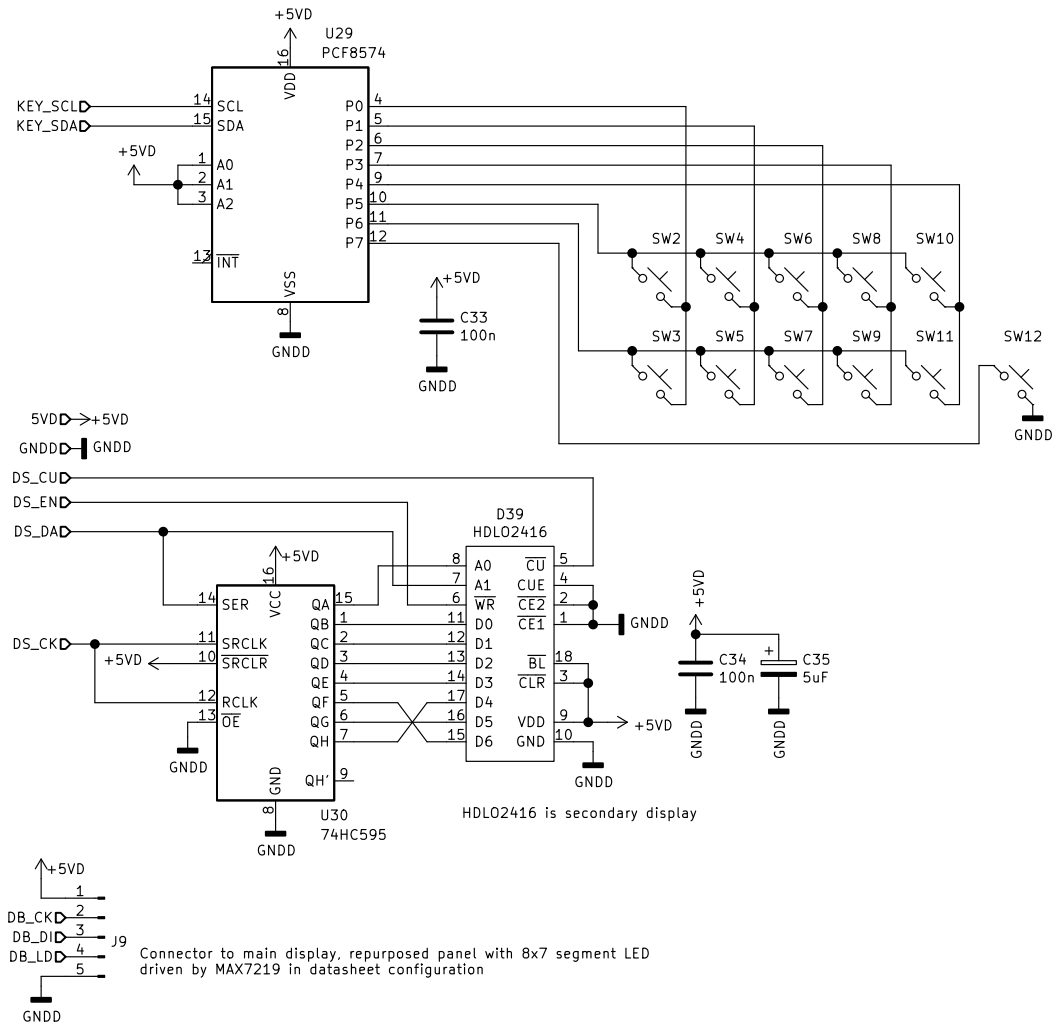
[picture p23: page 8]

Id: 8/10 Title: File: DSKY.sch Sheet: /DSKY/ GNDD

Connector to main display, repurposed panel with 8x7 segment LED
driven by MAX7219 in datasheet configuration

Multimeter JM1 - display and keyboard

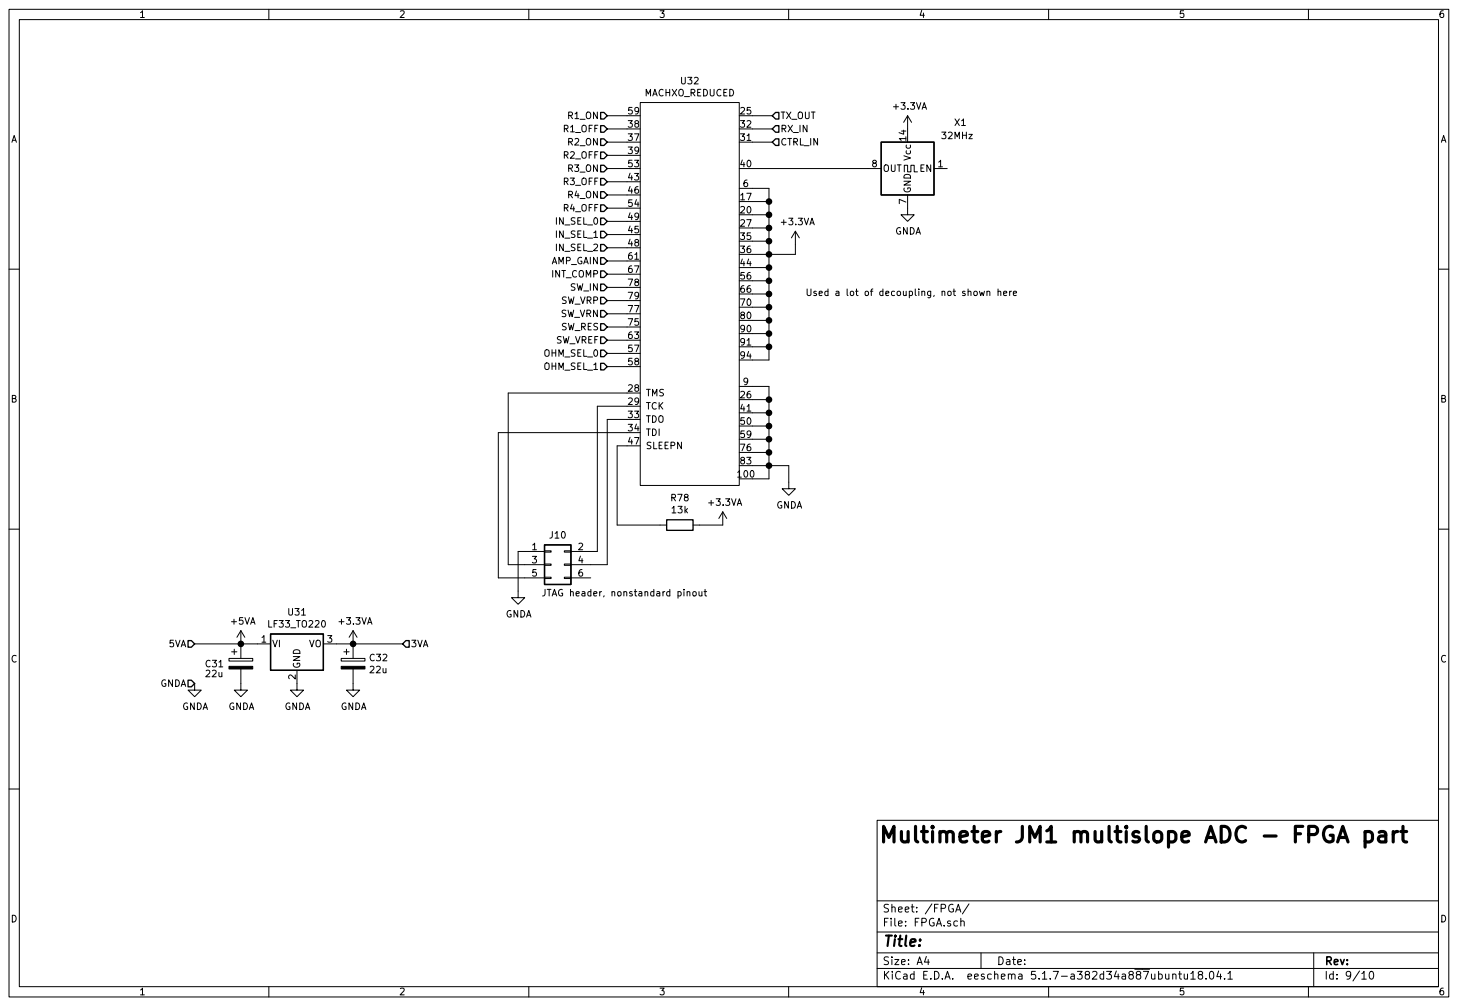
[picture p24: page 9]

Used a lot of decoupling, not shown here

JTAG header, nonstandard pinout

Multimeter JM1 multislope ADC - FPGA part

Id: 9/10 Title: File: FPGA.sch Sheet: /FPGA/

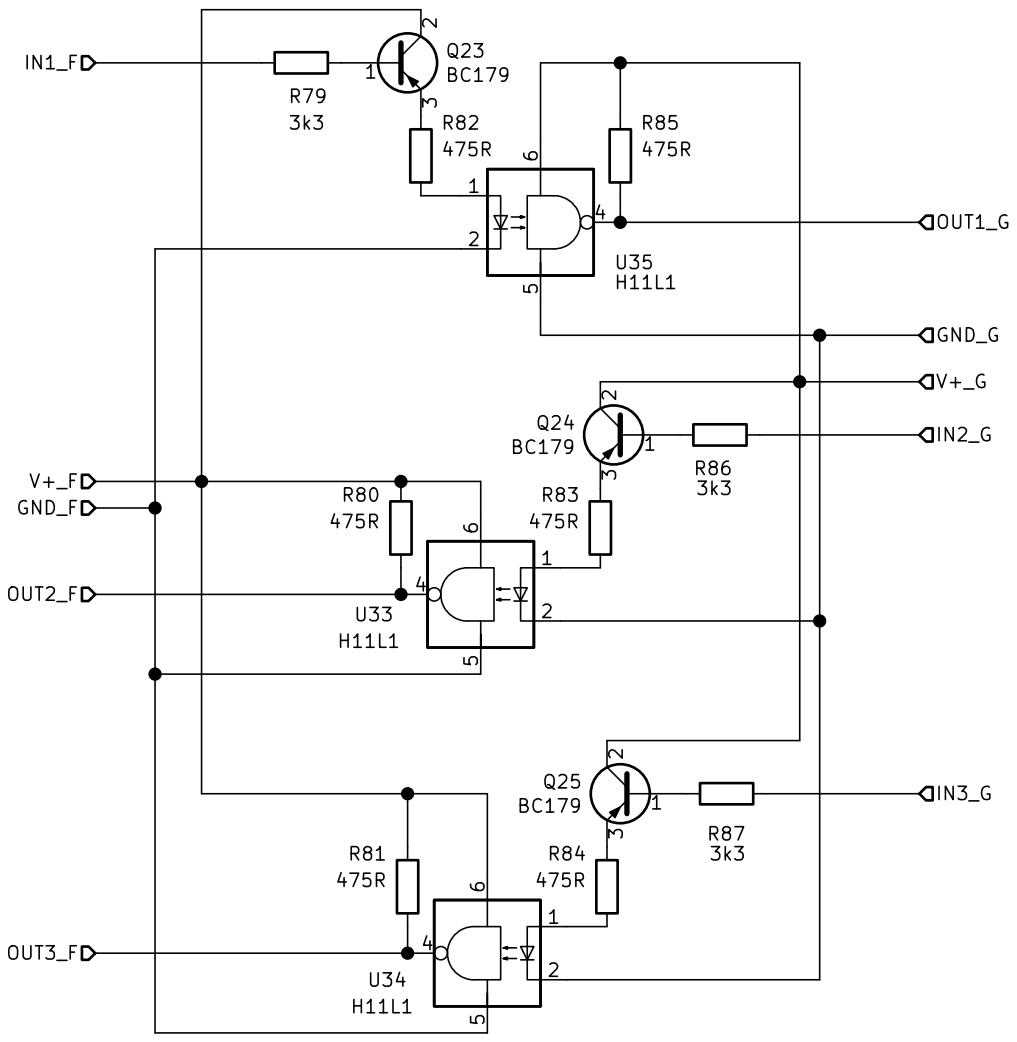
[picture p25: page 10]

Id: 10/10 Title: File: ISOLATORS.sch Sheet: /ISOLATORS/
