mfkiwl/ADC_Test-icd40hx/hardware/project/ADC_Test/ADC_Test.kicad_pcb

## KiCad design hardware/project/ADC_Test/ADC_Test.kicad_pcb (2020-11-08)

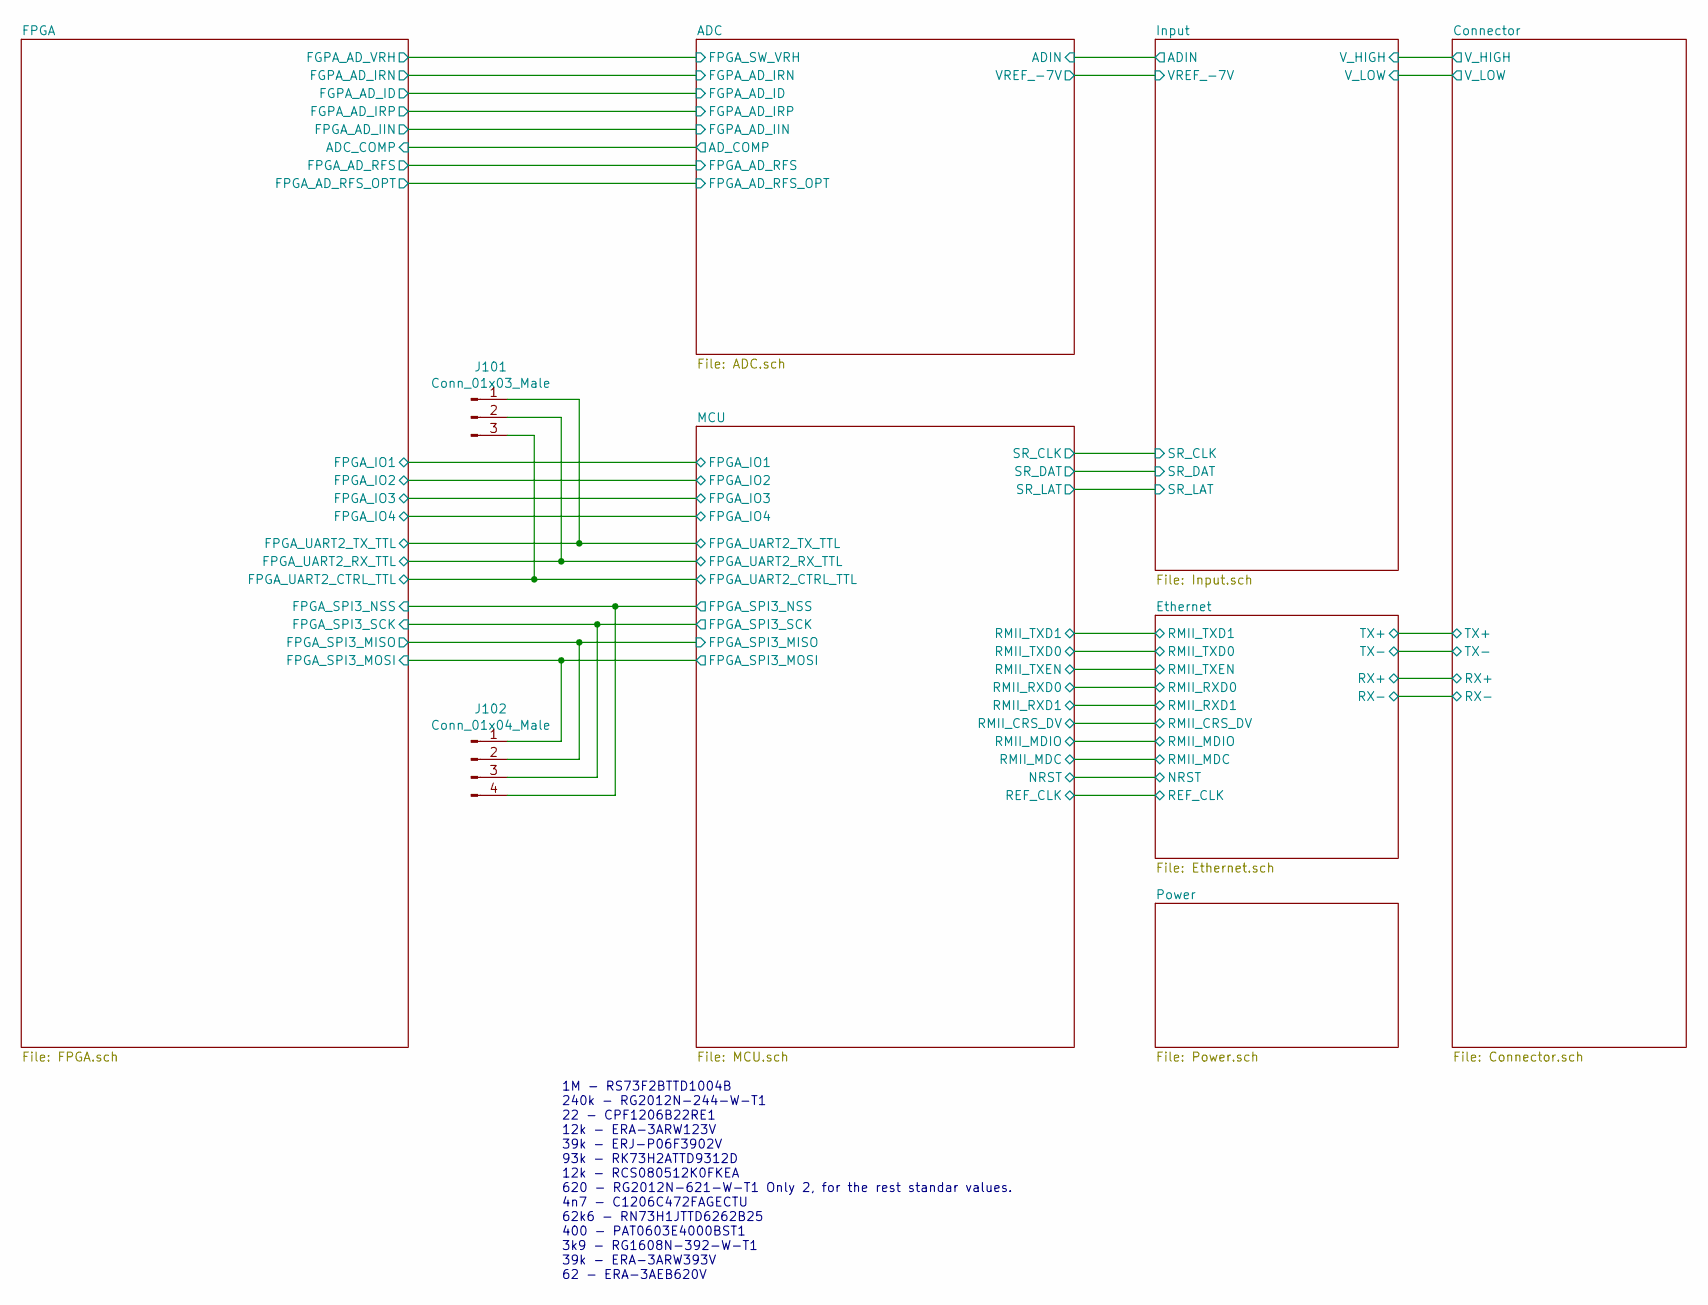
[picture p26: schematic ADC_Test.sch]

Parts:
J101: Conn_01x03_Male; PinHeader_1x03_P2.54mm_Vertical
J102: Conn_01x04_Male; PinHeader_1x04_P2.54mm_Vertical

Connections:
/FPGA/FPGA_SPI3_MISO: J102.2; also elsewhere on the board
/FPGA/FPGA_SPI3_MOSI: J102.1; also elsewhere on the board
/FPGA/FPGA_SPI3_NSS: J102.4; also elsewhere on the board
/FPGA/FPGA_SPI3_SCK: J102.3; also elsewhere on the board
/FPGA/FPGA_UART2_CTRL_TTL: J101.3; also elsewhere on the board
/FPGA/FPGA_UART2_RX_TTL: J101.2; also elsewhere on the board
/FPGA/FPGA_UART2_TX_TTL: J101.1; also elsewhere on the board

Notes on the sheet:
1M - RS73F2BTTD1004B 240k - RG2012N-244-W-T1 22 - CPF1206B22RE1 12k - ERA-3ARW123V 39k - ERJ-P06F3902V 93k - RK73H2ATTD9312D 12k - RCS080512K0FKEA 620 - RG2012N-621-W-T1 Only 2, for the rest standar values. 4n7 - C1206C472FAGECTU 62k6 - RN73H1JTTD6262B25 400 - PAT0603E4000BST1 3k9 - RG1608N-392-W-T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

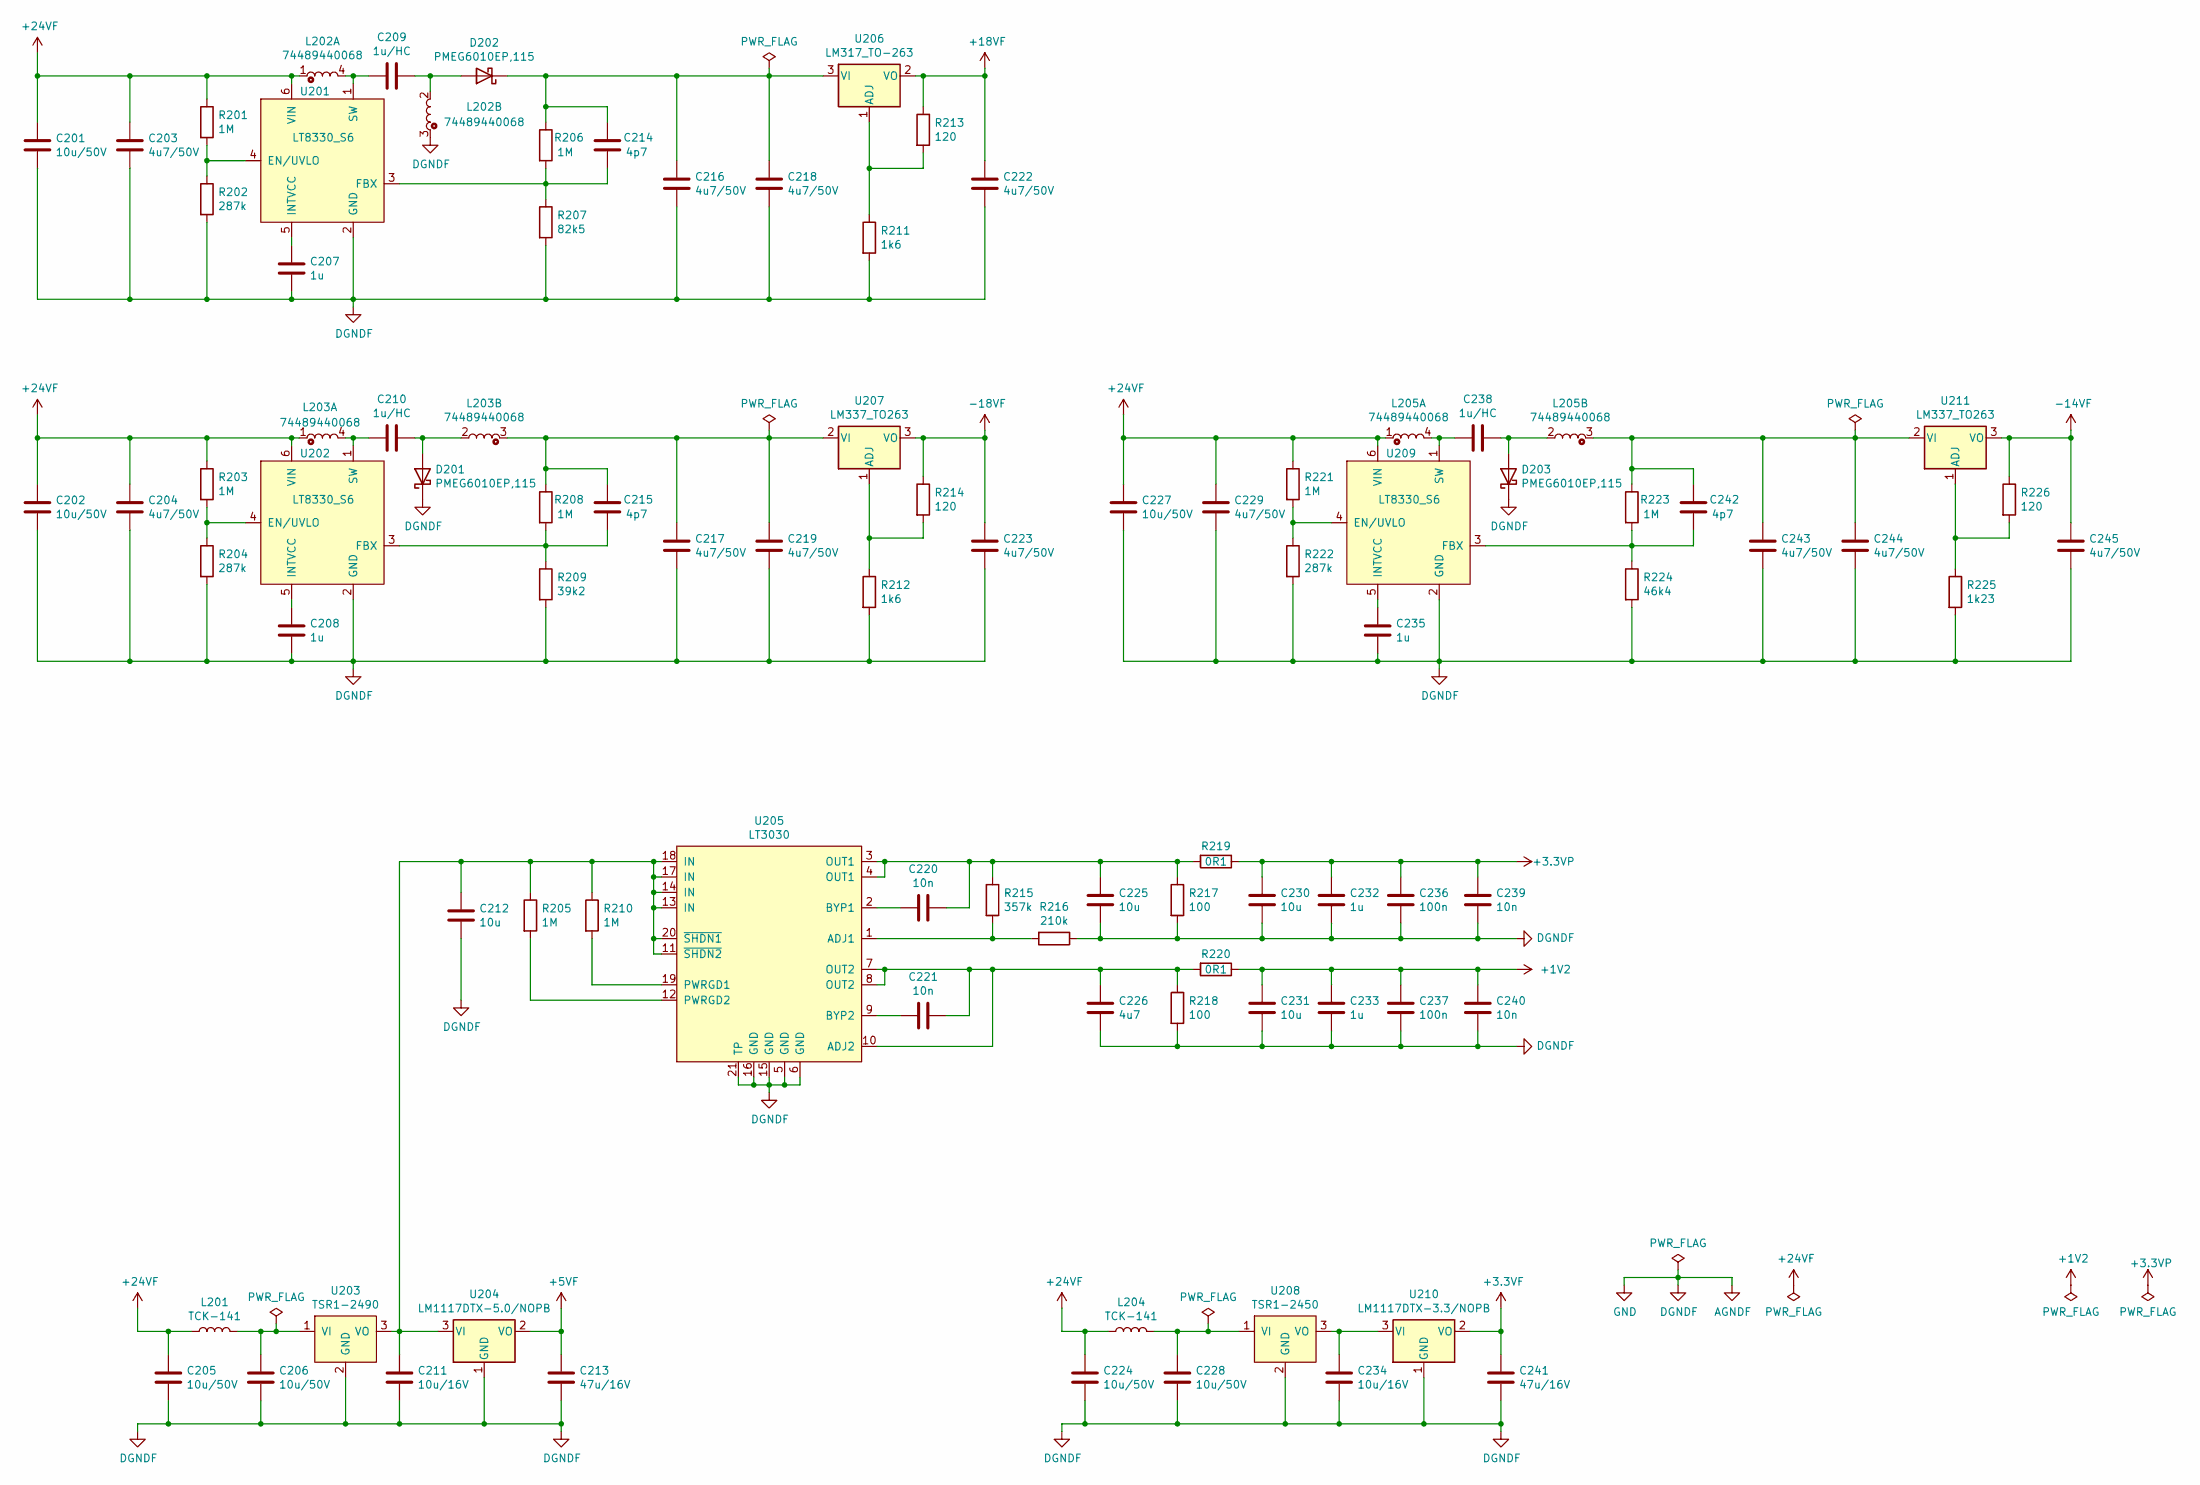
[picture p27: schematic Power.sch, Power float]

Parts:
C201, C202, C205, C206, C224, C227, C228: 10u/50V; C_1206_3216Metric_Pad1.42x1.75mm_HandSolder
C203, C204, C216, C217, C218, C219, C222, C223, C229, C243, C244, C245: 4u7/50V; C_1206_3216Metric_Pad1.42x1.75mm_HandSolder
C207, C208, C232, C233, C235: 1u; C_0603_1608Metric_Pad1.05x0.95mm_HandSolder
C209, C210, C238: 1u/HC; C_1206_3216Metric_Pad1.42x1.75mm_HandSolder
C211, C234: 10u/16V; C_1206_3216Metric_Pad1.42x1.75mm_HandSolder
C212, C225, C230, C231: 10u; C_0805_2012Metric_Pad1.15x1.40mm_HandSolder
C213, C241: 47u/16V; C_1206_3216Metric_Pad1.42x1.75mm_HandSolder
C214, C215, C242: 4p7; C_0603_1608Metric_Pad1.05x0.95mm_HandSolder
C220, C221, C239, C240: 10n; C_0603_1608Metric_Pad1.05x0.95mm_HandSolder
C226: 4u7; C_0805_2012Metric_Pad1.15x1.40mm_HandSolder
C236, C237: 100n; C_0603_1608Metric_Pad1.05x0.95mm_HandSolder
D201, D202, D203: PMEG6010EP,115; D_SOD-128
L201, L204: TCK-141
L202, L203, L205: 74489440068
R201, R203, R205, R206, R208, R210, R221, R223: 1M; R_0603_1608Metric_Pad1.05x0.95mm_HandSolder
R202, R204, R222: 287k; R_0603_1608Metric_Pad1.05x0.95mm_HandSolder
R207: 82k5; R_0603_1608Metric_Pad1.05x0.95mm_HandSolder
R209: 39k2; R_0603_1608Metric_Pad1.05x0.95mm_HandSolder
R211, R212: 1k6; R_0603_1608Metric_Pad1.05x0.95mm_HandSolder
R213, R214, R226: 120; R_0603_1608Metric_Pad1.05x0.95mm_HandSolder
R215: 357k; R_0603_1608Metric_Pad1.05x0.95mm_HandSolder
R216: 210k; R_0603_1608Metric_Pad1.05x0.95mm_HandSolder
R217, R218: 100; R_0603_1608Metric_Pad1.05x0.95mm_HandSolder
R219, R220: 0R1; R_0805_2012Metric_Pad1.15x1.40mm_HandSolder
R224: 46k4; R_0603_1608Metric_Pad1.05x0.95mm_HandSolder
R225: 1k23; R_0603_1608Metric_Pad1.05x0.95mm_HandSolder
U201, U202, U209: LT8330_S6; TSOT-23-6_HandSoldering
U203: TSR1-2490; TSR1
U204: LM1117DTX-5.0/NOPB; TO-252-2
U205: LT3030; ETSSOP-20-1EP_4.4x6.5mm_P0.65mm_EP3x4.2mm
U206: LM317_TO-263; TO-263-2
U207, U211: LM337_TO263; TO-263-2
U208: TSR1-2450; TSR1
U210: LM1117DTX-3.3/NOPB; TO-252-2

Connections:
+1V2: C231.1, C233.1, C237.1, C240.1, R220.1; also elsewhere on the board
+3.3VF: C241.1, U210.2 (VO); also elsewhere on the board
+3.3VP: C230.1, C232.1, C236.1, C239.1, R219.1; also elsewhere on the board
+5VF: C213.1, U204.2 (VO); also elsewhere on the board
+18VF: C222.1, R213.1, U206.2 (VO); also elsewhere on the board
+24VF: C201.1, C202.1, C203.1, C204.1, C205.1, C224.1, C227.1, C229.1, L201.1, L202.1, L203.1, L204.1, L205.1, R201.1, R203.1, R221.1, U201.6 (VIN), U202.6 (VIN), U209.6 (VIN); also elsewhere on the board
-14VF: C245.1, R226.1, U211.3 (VO); also elsewhere on the board
-18VF: C223.1, R214.1, U207.3 (VO); also elsewhere on the board
AGNDF: C201.2, C202.2, C203.2, C204.2, C205.2, C206.2, C207.2, C208.2, C211.2, C212.2, C213.2, C216.2, C217.2, C218.2, C219.2, C222.2, C223.2, C224.2, C225.2, C226.2, C227.2, C228.2, C229.2, C230.2, C231.2, C232.2, C233.2, C234.2, C235.2, C236.2, C237.2, C239.2, C240.2, C241.2, C243.2, C244.2, C245.2, D201.1 (K), D203.1 (K), L202.3, R202.2, R204.2, R207.2, R209.2, R211.2, R212.2, R216.1, R217.2, R218.2, R222.2, R224.2, R225.2, U201.2 (GND), U202.2 (GND), U203.2 (GND), U204.1 (GND), U205.5 (GND), U205.6 (GND), U205.15 (GND), U205.16 (GND), U205.21 (TP), U208.2 (GND), U209.2 (GND), U210.1 (GND); also elsewhere on the board
unnamed: C206.1, L201.2, U203.1 (VI)
unnamed: C207.1, U201.5 (INTVCC)
unnamed: C208.1, U202.5 (INTVCC)
unnamed: C209.1, D202.2 (A), L202.2
unnamed: C209.2, L202.4, U201.1 (SW)
unnamed: C210.1, D201.2 (A), L203.2
unnamed: C210.2, L203.4, U202.1 (SW)
unnamed: C211.1, C212.1, R205.1, R210.1, U203.3 (VO), U204.3 (VI), U205.11 (~SHDN2), U205.13 (IN), U205.14 (IN), U205.17 (IN), U205.18 (IN), U205.20 (~SHDN1)
unnamed: C214.1, C216.1, C218.1, D202.1 (K), R206.1, U206.3 (VI)
unnamed: C214.2, R206.2, R207.1, U201.3 (FBX)
unnamed: C215.1, C217.1, C219.1, L203.3, R208.1, U207.2 (VI)
unnamed: C215.2, R208.2, R209.1, U202.3 (FBX)
unnamed: C220.1, C225.1, R215.1, R217.1, R219.2, U205.3 (OUT1), U205.4 (OUT1)
unnamed: C220.2, U205.2 (BYP1)
unnamed: C221.1, C226.1, R218.1, R220.2, U205.7 (OUT2), U205.8 (OUT2), U205.10 (ADJ2)
unnamed: C221.2, U205.9 (BYP2)
unnamed: C228.1, L204.2, U208.1 (VI)
unnamed: C234.1, U208.3 (VO), U210.3 (VI)
unnamed: C235.1, U209.5 (INTVCC)
unnamed: C238.1, D203.2 (A), L205.2
unnamed: C238.2, L205.4, U209.1 (SW)
unnamed: C242.1, C243.1, C244.1, L205.3, R223.1, U211.2 (VI)
unnamed: C242.2, R223.2, R224.1, U209.3 (FBX)
unnamed: R201.2, R202.1, U201.4 (EN/UVLO)
unnamed: R203.2, R204.1, U202.4 (EN/UVLO)
unnamed: R205.2, U205.12 (PWRGD2)
unnamed: R210.2, U205.19 (PWRGD1)
unnamed: R211.1, R213.2, U206.1 (ADJ)
unnamed: R212.1, R214.2, U207.1 (ADJ)
unnamed: R215.2, R216.2, U205.1 (ADJ1)
unnamed: R221.2, R222.1, U209.4 (EN/UVLO)
unnamed: R225.1, R226.2, U211.1 (ADJ)

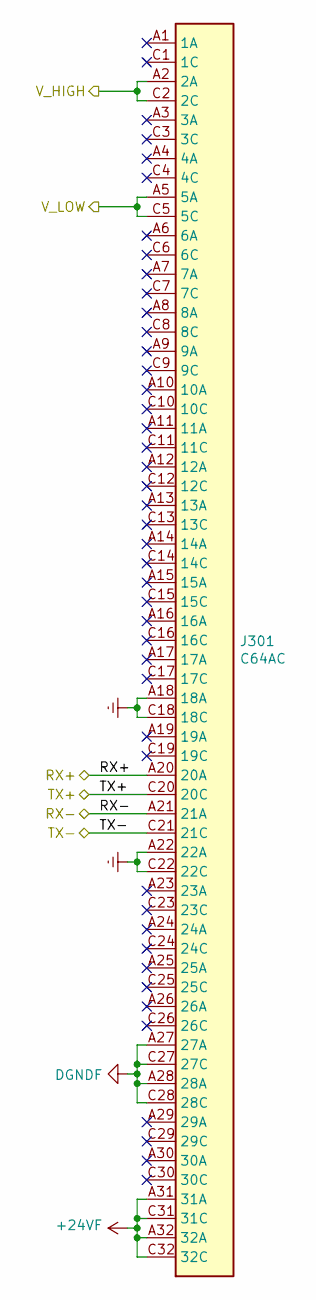
[picture p28: schematic Connector.sch]

Parts:
J301: C64AC; Socket_DIN41612-CaseC1-AC-Male-64Pin-2rows

Connections:
+24VF: J301.A31 (31A), J301.A32 (32A), J301.C31 (31C), J301.C32 (32C); also elsewhere on the board
/Connector/RX+: J301.A20 (20A); also elsewhere on the board
/Connector/RX-: J301.A21 (21A); also elsewhere on the board
/Connector/TX+: J301.C20 (20C); also elsewhere on the board
/Connector/TX-: J301.C21 (21C); also elsewhere on the board
/Connector/V_HIGH: J301.A2 (2A), J301.C2 (2C); also elsewhere on the board
AGNDF: J301.A5 (5A), J301.A27 (27A), J301.A28 (28A), J301.C5 (5C), J301.C27 (27C), J301.C28 (28C); also elsewhere on the board
Earth: J301.A18 (18A), J301.A22 (22A), J301.C18 (18C), J301.C22 (22C); also elsewhere on the board

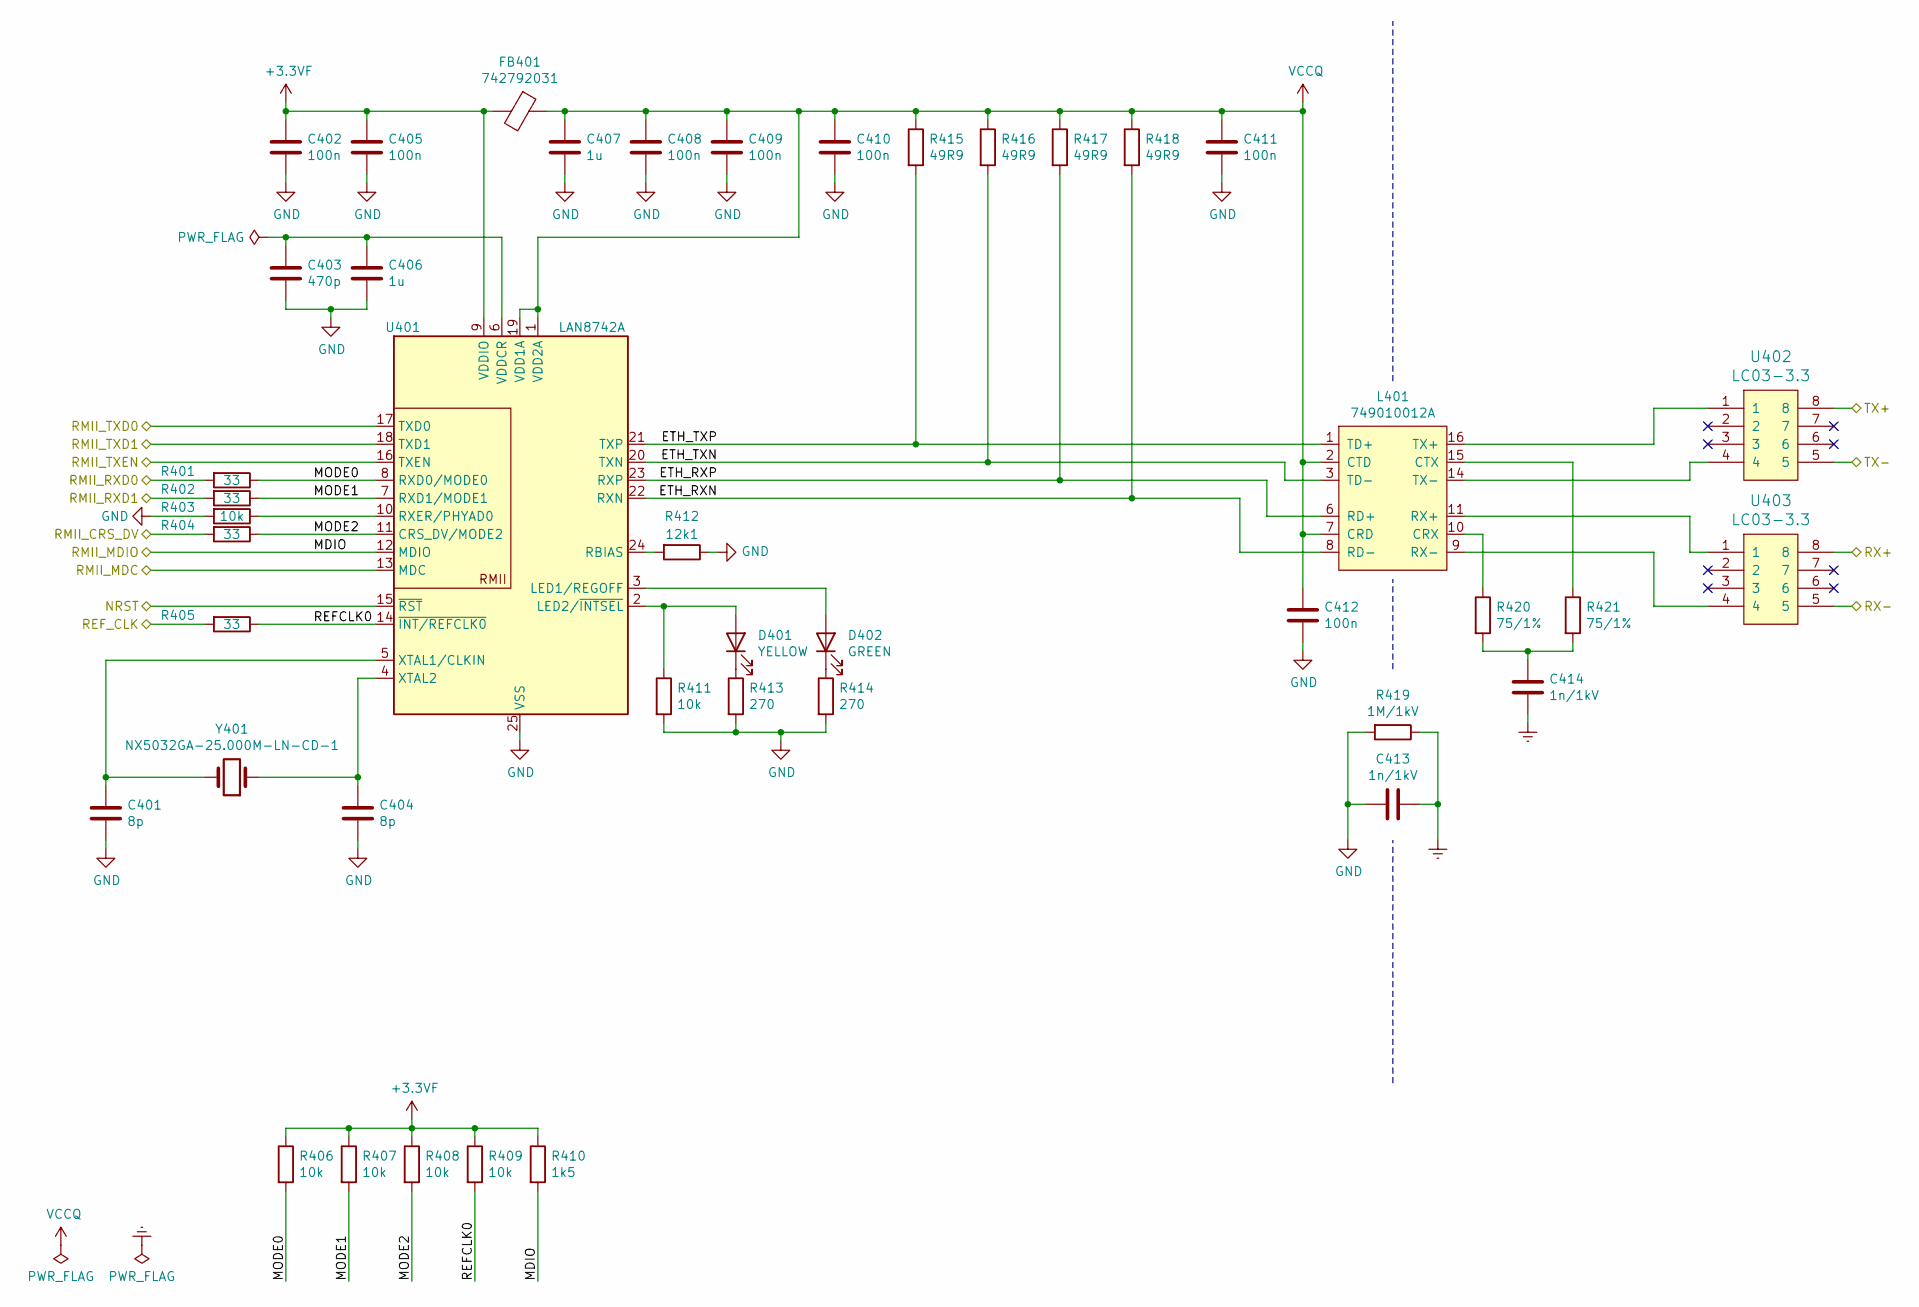
[picture p29: schematic Ethernet.sch]

Parts:
C401, C404: 8p; C_0603_1608Metric_Pad1.05x0.95mm_HandSolder
C402, C405, C408, C409, C410, C411, C412: 100n; C_0603_1608Metric_Pad1.05x0.95mm_HandSolder
C403: 470p; C_0603_1608Metric_Pad1.05x0.95mm_HandSolder
C406, C407: 1u; C_0603_1608Metric_Pad1.05x0.95mm_HandSolder
C413, C414: 1n/1kV; C_1206_3216Metric_Pad1.42x1.75mm_HandSolder
D401: YELLOW; LED_0603_1608Metric_Pad1.05x0.95mm_HandSolder
D402: GREEN; LED_0603_1608Metric_Pad1.05x0.95mm_HandSolder
FB401: 742792031; L_0805_2012Metric_Pad1.15x1.40mm_HandSolder
L401: 749010012A
R401, R402, R404, R405: 33; R_0603_1608Metric_Pad1.05x0.95mm_HandSolder
R403, R406, R407, R408, R409, R411: 10k; R_0603_1608Metric_Pad1.05x0.95mm_HandSolder
R410: 1k5; R_0603_1608Metric_Pad1.05x0.95mm_HandSolder
R412: 12k1; R_0603_1608Metric_Pad1.05x0.95mm_HandSolder
R413, R414: 270; R_0603_1608Metric_Pad1.05x0.95mm_HandSolder
R415, R416, R417, R418: 49R9; R_0603_1608Metric_Pad1.05x0.95mm_HandSolder
R419: 1M/1kV; R_1206_3216Metric_Pad1.42x1.75mm_HandSolder
R420, R421: 75/1%; R_0603_1608Metric_Pad1.05x0.95mm_HandSolder
U401: LAN8742A; QFN-24-1EP_4x4mm_P0.5mm_EP2.6x2.6mm_ThermalVias
U402, U403: LC03-3.3; SO8E
Y401: NX5032GA-25.000M-LN-CD-1; NX5032GA

Connections:
+3.3VF: C402.1, C405.1, FB401.2, R406.1, R407.1, R408.1, R409.1, R410.1, U401.9 (VDDIO); also elsewhere on the board
/Connector/RX+: U403.8; also elsewhere on the board
/Connector/RX-: U403.5; also elsewhere on the board
/Connector/TX+: U402.8; also elsewhere on the board
/Connector/TX-: U402.5; also elsewhere on the board
/Ethernet/ETH_RXN: L401.8 (RD-), R418.2, U401.22 (RXN)
/Ethernet/ETH_RXP: L401.6 (RD+), R417.2, U401.23 (RXP)
/Ethernet/ETH_TXN: L401.3 (TD-), R416.2, U401.20 (TXN)
/Ethernet/ETH_TXP: L401.1 (TD+), R415.2, U401.21 (TXP)
/Ethernet/MODE0: R401.1, R406.2, U401.8 (RXD0/MODE0)
/Ethernet/MODE1: R402.1, R407.2, U401.7 (RXD1/MODE1)
/Ethernet/MODE2: R404.1, R408.2, U401.11 (CRS_DV/MODE2)
/Ethernet/NRST: U401.15 (~RST); also elsewhere on the board
/Ethernet/REFCLK0: R405.1, R409.2, U401.14 (~INT/REFCLK0)
/Ethernet/REF_CLK: R405.2; also elsewhere on the board
/Ethernet/RMII_CRS_DV: R404.2; also elsewhere on the board
/Ethernet/RMII_MDC: U401.13 (MDC); also elsewhere on the board
/Ethernet/RMII_MDIO: R410.2, U401.12 (MDIO); also elsewhere on the board
/Ethernet/RMII_RXD0: R401.2; also elsewhere on the board
/Ethernet/RMII_RXD1: R402.2; also elsewhere on the board
/Ethernet/RMII_TXD0: U401.17 (TXD0); also elsewhere on the board
/Ethernet/RMII_TXD1: U401.18 (TXD1); also elsewhere on the board
/Ethernet/RMII_TXEN: U401.16 (TXEN); also elsewhere on the board
AGNDF: C401.2, C402.2, C403.2, C404.2, C405.2, C406.2, C407.2, C408.2, C409.2, C410.2, C411.2, C412.2, C413.2, R403.2, R411.2, R412.1, R413.2, R414.2, R419.2, U401.25 (VSS); also elsewhere on the board
Earth: C413.1, C414.2, R419.1; also elsewhere on the board
unnamed: C401.1, U401.5 (XTAL1/CLKIN), Y401.2
unnamed: C403.1, C406.1, U401.6 (VDDCR)
unnamed: C404.1, U401.4 (XTAL2), Y401.1
unnamed: C414.1, R420.2, R421.2
unnamed: D401.1 (K), R413.1
unnamed: D401.2 (A), R411.1, U401.2 (LED2/~INTSEL)
unnamed: D402.1 (K), R414.1
unnamed: D402.2 (A), U401.3 (LED1/REGOFF)
unnamed: L401.9 (RX-), U403.4
unnamed: L401.10 (CRX), R420.1
unnamed: L401.11 (RX+), U403.1
unnamed: L401.14 (TX-), U402.4
unnamed: L401.15 (CTX), R421.1
unnamed: L401.16 (TX+), U402.1
unnamed: R403.1, U401.10 (RXER/PHYAD0)
unnamed: R412.2, U401.24 (RBIAS)
VCCQ: C407.1, C408.1, C409.1, C410.1, C411.1, C412.1, FB401.1, L401.2 (CTD), L401.7 (CRD), R415.1, R416.1, R417.1, R418.1, U401.1 (VDD2A), U401.19 (VDD1A)

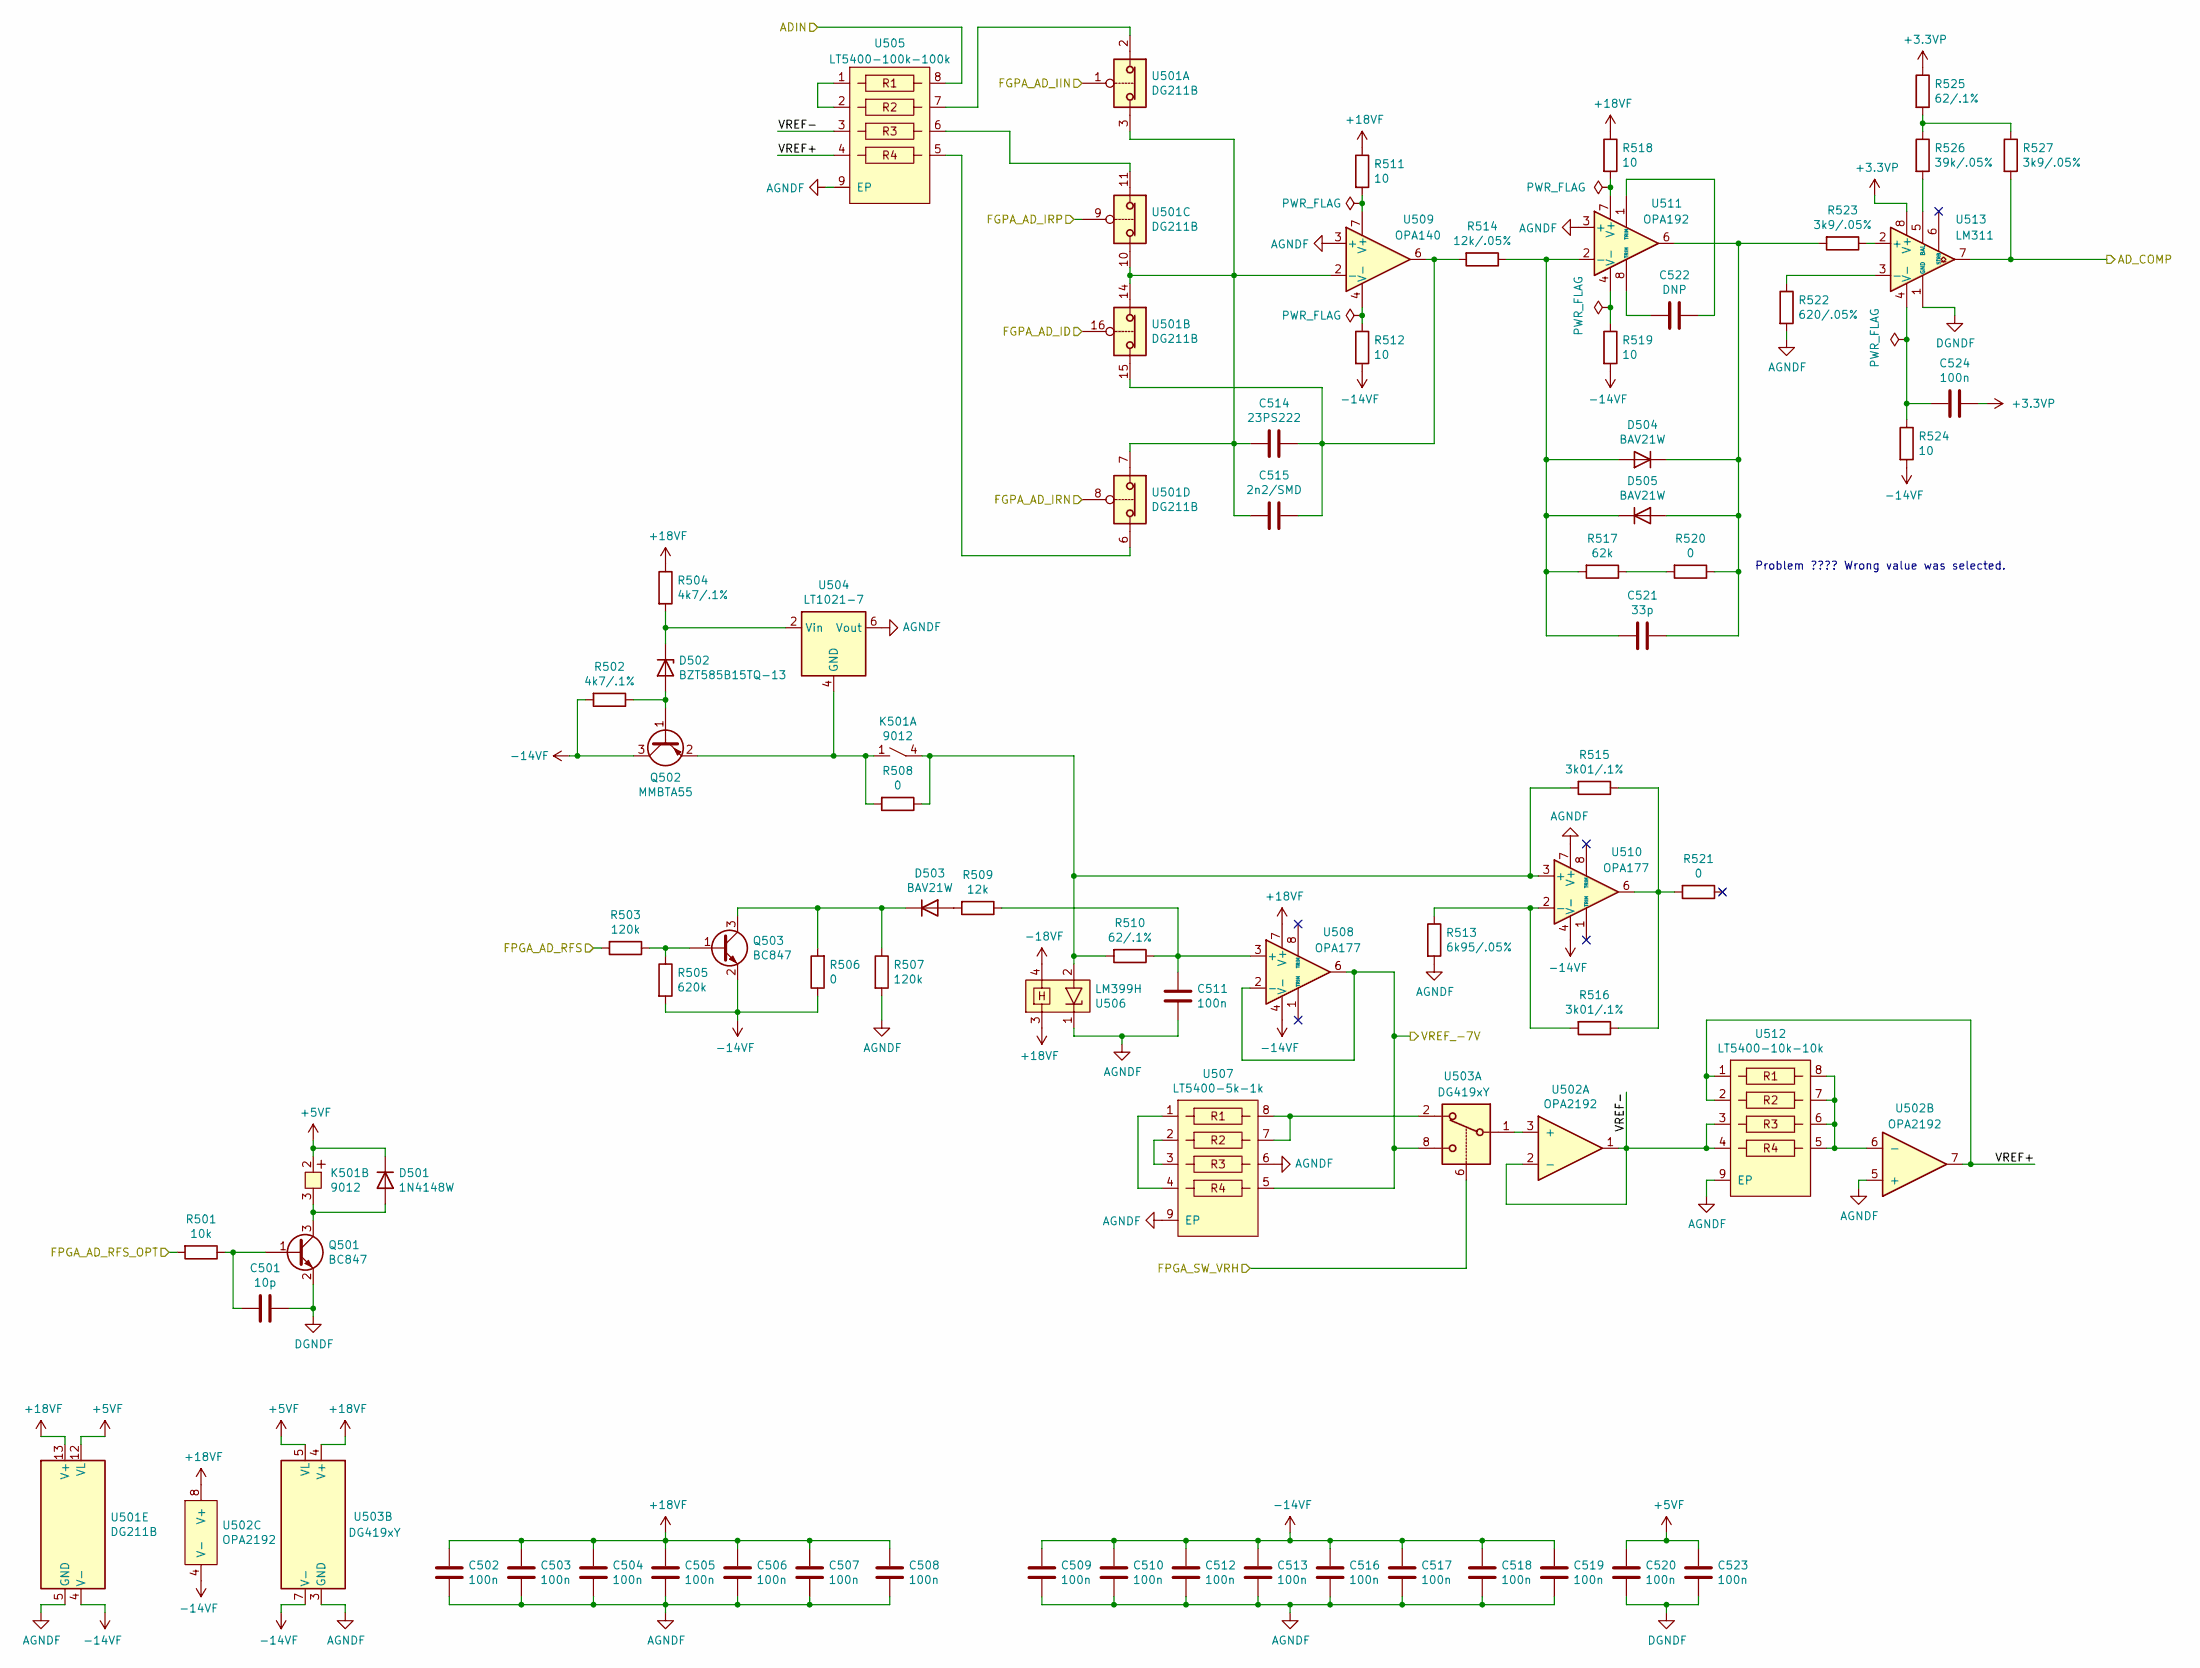
[picture p30: schematic ADC.sch]

Parts:
C501: 10p; C_0603_1608Metric_Pad1.05x0.95mm_HandSolder
C502, C503, C504, C505, C506, C507, C508, C509, C510, C511, C512, C513, C516, C517, C518, C519, C520, C523, C524: 100n; C_0603_1608Metric_Pad1.05x0.95mm_HandSolder
C514: 23PS222; C_Axial_L12.0mm_D6.5mm_P15.00mm_Horizontal
C515: 2n2/SMD; C_0603_1608Metric_Pad1.05x0.95mm_HandSolder
C521: 33p; C_0603_1608Metric_Pad1.05x0.95mm_HandSolder
C522: DNP; C_0603_1608Metric_Pad1.05x0.95mm_HandSolder
D501: 1N4148W; D_SOD-123
D502: BZT585B15TQ-13; D_SOD-523
D503, D504, D505: BAV21W; D_SOD-123
K501: 9012
Q501, Q503: BC847; SOT-23
Q502: MMBTA55; SOT-23
R501: 10k; R_0603_1608Metric_Pad1.05x0.95mm_HandSolder
R502, R504: 4k7/.1%; R_0603_1608Metric_Pad1.05x0.95mm_HandSolder
R503, R507: 120k; R_0603_1608Metric_Pad1.05x0.95mm_HandSolder
R505: 620k; R_0603_1608Metric_Pad1.05x0.95mm_HandSolder
R506, R508, R520, R521: 0; R_0603_1608Metric_Pad1.05x0.95mm_HandSolder
R509: 12k; R_0603_1608Metric_Pad1.05x0.95mm_HandSolder
R510, R525: 62/.1%; R_0603_1608Metric_Pad1.05x0.95mm_HandSolder
R511, R512, R518, R519, R524: 10; R_0603_1608Metric_Pad1.05x0.95mm_HandSolder
R513: 6k95/.05%; R_1206_3216Metric_Pad1.42x1.75mm_HandSolder
R514: 12k/.05%; R_0603_1608Metric_Pad1.05x0.95mm_HandSolder
R515, R516: 3k01/.1%; R_0603_1608Metric_Pad1.05x0.95mm_HandSolder
R517: 62k; R_0603_1608Metric_Pad1.05x0.95mm_HandSolder
R522: 620/.05%; R_0603_1608Metric_Pad1.05x0.95mm_HandSolder
R523, R527: 3k9/.05%; R_0603_1608Metric_Pad1.05x0.95mm_HandSolder
R526: 39k/.05%; R_0603_1608Metric_Pad1.05x0.95mm_HandSolder
U501: DG211B; SOIC-16_3.9x9.9mm_P1.27mm
U502: OPA2192; SOIC-8_3.9x4.9mm_P1.27mm
U503: DG419xY; SOIC-8_3.9x4.9mm_P1.27mm
U504: LT1021-7; SOIC-8_3.9x4.9mm_P1.27mm
U505: LT5400-100k-100k; MSOP-8-1EP_3x3mm_P0.65mm_EP1.73x1.85mm_ThermalVias
U506: LM399H; LMx99
U507: LT5400-5k-1k; MSOP-8-1EP_3x3mm_P0.65mm_EP1.73x1.85mm_ThermalVias
U508, U510: OPA177; SOIC-8_3.9x4.9mm_P1.27mm
U509: OPA140; SOIC-8_3.9x4.9mm_P1.27mm
U511: OPA192; SOIC-8_3.9x4.9mm_P1.27mm
U512: LT5400-10k-10k; MSOP-8-1EP_3x3mm_P0.65mm_EP1.73x1.85mm_ThermalVias
U513: LM311; SOIC-8_3.9x4.9mm_P1.27mm

Connections:
+3.3VP: C524.1, R525.1, U513.8 (V+); also elsewhere on the board
+5VF: C520.1, C523.1, D501.1 (K), K501.2, U501.12 (VL), U503.5 (VL); also elsewhere on the board
+18VF: C502.1, C503.1, C504.1, C505.1, C506.1, C507.1, C508.1, R504.1, R511.1, R518.1, U501.13 (V+), U502.8 (V+), U503.4 (V+), U506.3, U508.7 (V+); also elsewhere on the board
-14VF: C509.1, C510.1, C512.1, C513.1, C516.1, C517.1, C518.1, C519.1, Q502.3 (C), Q503.2 (E), R502.2, R505.2, R506.1, R512.2, R519.2, R524.2, U501.4 (V-), U502.4 (V-), U503.7 (V-), U508.4 (V-), U510.4 (V-); also elsewhere on the board
-18VF: U506.4; also elsewhere on the board
/ADC/ADIN: U505.8; also elsewhere on the board
/ADC/FGPA_AD_ID: U501.16; also elsewhere on the board
/ADC/FGPA_AD_IIN: U501.1; also elsewhere on the board
/ADC/FGPA_AD_IRN: U501.8; also elsewhere on the board
/ADC/FGPA_AD_IRP: U501.9; also elsewhere on the board
/ADC/FPGA_AD_RFS: R503.2; also elsewhere on the board
/ADC/FPGA_AD_RFS_OPT: R501.2; also elsewhere on the board
/ADC/VREF+: U502.7, U505.4, U512.1, U512.2
/ADC/VREF-: U502.1, U502.2 (-), U505.3, U512.3, U512.4
/ADC/VREF_-7V: U503.8, U507.5, U508.2 (-), U508.6; also elsewhere on the board
/FPGA/ADC_COMP: R527.2, U513.7; also elsewhere on the board
/FPGA/FGPA_AD_VRH: U503.6; also elsewhere on the board
AGNDF: C501.1, C502.2, C503.2, C504.2, C505.2, C506.2, C507.2, C508.2, C509.2, C510.2, C511.2, C512.2, C513.2, C516.2, C517.2, C518.2, C519.2, C520.2, C523.2, Q501.2 (E), R507.2, R513.2, R522.2, U501.5 (GND), U502.5 (+), U503.3 (GND), U504.6 (Vout), U505.9 (EP), U506.1, U507.6, U507.9 (EP), U509.3 (+), U510.7 (V+), U511.3 (+), U512.9 (EP), U513.1 (GND); also elsewhere on the board
unnamed: C501.2, Q501.1 (B), R501.1
unnamed: C511.1, R509.1, R510.1, U508.3 (+)
unnamed: C514.1, C515.1, R514.2, U501.15, U509.6
unnamed: C514.2, C515.2, U501.3, U501.7, U501.10, U501.14, U509.2 (-)
unnamed: C521.1, D504.1 (K), D505.2 (A), R520.1, R523.2, U511.6
unnamed: C521.2, D504.2 (A), D505.1 (K), R514.1, R517.2, U511.2 (-)
unnamed: C522.1, U511.1 (TRIM)
unnamed: C522.2, U511.8 (TRIM)
unnamed: C524.2, R524.1, U513.4 (V-)
unnamed: D501.2 (A), K501.3, Q501.3 (C)
unnamed: D502.1 (K), R504.2, U504.2 (Vin)
unnamed: D502.2 (A), Q502.1 (B), R502.1
unnamed: D503.1 (K), Q503.3 (C), R506.2, R507.1
unnamed: D503.2 (A), R509.2
unnamed: K501.1, Q502.2 (E), R508.2, U504.4 (GND)
unnamed: K501.4, R508.1, R510.2, R515.2, U506.2, U510.3 (+)
unnamed: Q503.1 (B), R503.1, R505.1
unnamed: R511.2, U509.7 (V+)
unnamed: R512.1, U509.4 (V-)
unnamed: R513.1, R516.2, U510.2 (-)
unnamed: R515.1, R516.1, R521.2, U510.6
unnamed: R517.1, R520.2
unnamed: R518.2, U511.7 (V+)
unnamed: R519.1, U511.4 (V-)
unnamed: R522.1, U513.3 (-)
unnamed: R523.1, U513.2 (+)
unnamed: R525.2, R526.1, R527.1
unnamed: R526.2, U513.5 (BAL)
unnamed: U501.2, U505.7
unnamed: U501.6, U505.5
unnamed: U501.11, U505.6
unnamed: U502.3 (+), U503.1
unnamed: U502.6 (-), U512.5, U512.6, U512.7, U512.8
unnamed: U503.2, U507.7, U507.8
unnamed: U505.1, U505.2
unnamed: U507.1, U507.4
unnamed: U507.2, U507.3

Notes on the sheet:
Problem ???? Wrong value was selected.
