mfkiwl/ADC_Test-icd40hx/hardware/project/ADC_Test/ADC_Test.kicad_pcb

## KiCad design hardware/project/ADC_Test/ADC_Test.kicad_pcb (continued)

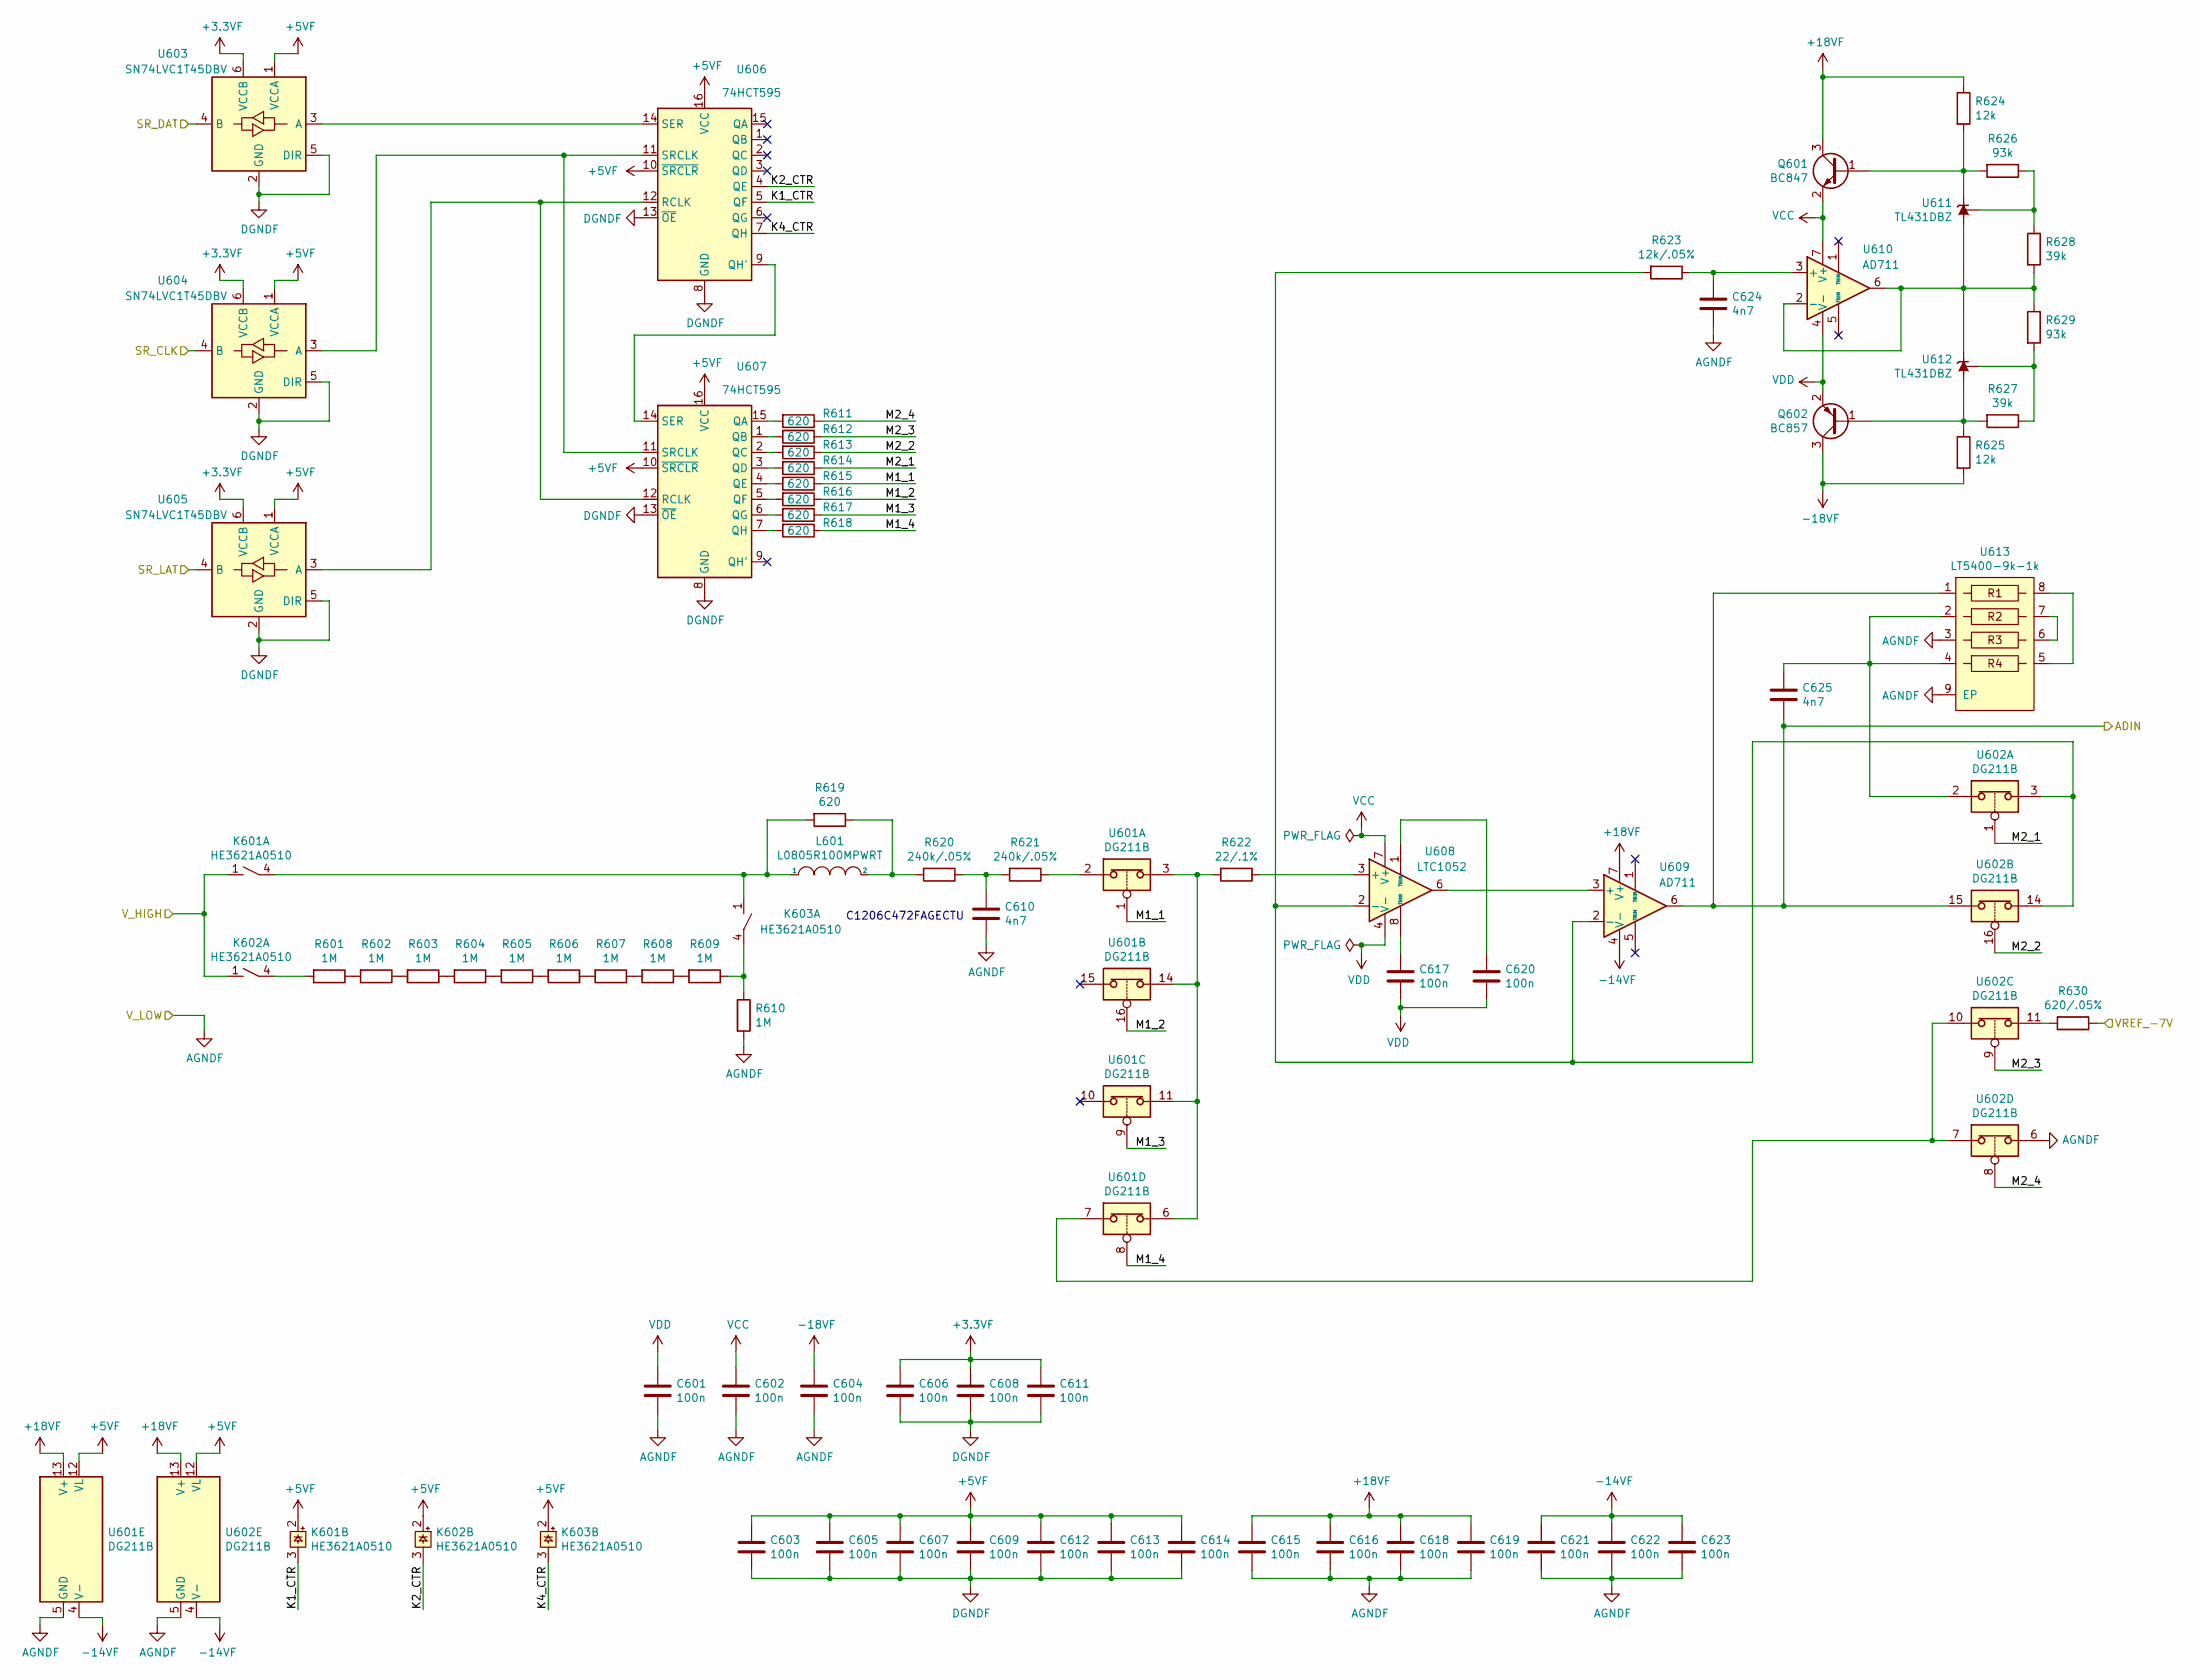
[picture p31: schematic Input.sch]

Parts:
C601, C602, C603, C604, C605, C606, C607, C608, C609, C611, C612, C613, C614, C615, C616, C617, C618, C619, C620, C621, C622, C623: 100n; C_0603_1608Metric_Pad1.05x0.95mm_HandSolder
C610: 4n7; C_1206_3216Metric_Pad1.42x1.75mm_HandSolder
C624, C625: 4n7; C_0603_1608Metric_Pad1.05x0.95mm_HandSolder
K601, K602, K603: HE3621A0510; HE360_x-5050462-8
L601: L0805R100MPWRT; R_0805_2012Metric_Pad1.15x1.40mm_HandSolder
Q601: BC847; SOT-23
Q602: BC857; SOT-23
R601, R602, R603, R604, R605, R606, R607, R608, R609, R610: 1M; R_0805_2012Metric_Pad1.15x1.40mm_HandSolder
R611, R612, R613, R614, R615, R616, R617, R618: 620; R_0603_1608Metric_Pad1.05x0.95mm_HandSolder
R619: 620; R_0805_2012Metric_Pad1.15x1.40mm_HandSolder
R620, R621: 240k/.05%; R_0805_2012Metric_Pad1.15x1.40mm_HandSolder
R622: 22/.1%; R_1206_3216Metric_Pad1.42x1.75mm_HandSolder
R623: 12k/.05%; R_0603_1608Metric_Pad1.05x0.95mm_HandSolder
R624, R625: 12k; R_0805_2012Metric_Pad1.15x1.40mm_HandSolder
R626, R629: 93k; R_0805_2012Metric_Pad1.15x1.40mm_HandSolder
R627, R628: 39k; R_0805_2012Metric_Pad1.15x1.40mm_HandSolder
R630: 620/.05%; R_0603_1608Metric_Pad1.05x0.95mm_HandSolder
U601, U602: DG211B; SOIC-16_3.9x9.9mm_P1.27mm
U603, U604, U605: SN74LVC1T45DBV; SOT-23-6
U606, U607: 74HCT595; TSSOP-16_4.4x5mm_P0.65mm
U608: LTC1052; DIP-8_W7.62mm_Socket
U609, U610: AD711; SOIC-8_3.9x4.9mm_P1.27mm
U611, U612: TL431DBZ; SOT-23
U613: LT5400-9k-1k; MSOP-8-1EP_3x3mm_P0.65mm_EP1.73x1.85mm_ThermalVias

Connections:
+3.3VF: C606.1, C608.1, C611.1, U603.6 (VCCB), U604.6 (VCCB), U605.6 (VCCB); also elsewhere on the board
+5VF: C603.1, C605.1, C607.1, C609.1, C612.1, C613.1, C614.1, K601.2, K602.2, K603.2, U601.12 (VL), U602.12 (VL), U603.1 (VCCA), U604.1 (VCCA), U605.1 (VCCA), U606.10 (~SRCLR), U606.16 (VCC), U607.10 (~SRCLR), U607.16 (VCC); also elsewhere on the board
+18VF: C615.1, C616.1, C618.1, C619.1, Q601.3 (C), R624.1, U601.13 (V+), U602.13 (V+), U609.7 (V+); also elsewhere on the board
-14VF: C621.1, C622.1, C623.1, U601.4 (V-), U602.4 (V-), U609.4 (V-); also elsewhere on the board
-18VF: C604.1, Q602.3 (C), R625.2; also elsewhere on the board
/ADC/ADIN: C625.2, U602.15, U609.6, U613.1; also elsewhere on the board
/ADC/VREF_-7V: R630.1; also elsewhere on the board
/Connector/V_HIGH: K601.1, K602.1; also elsewhere on the board
/Input/K1_CTR: K601.3, U606.5 (QF)
/Input/K2_CTR: K602.3, U606.4 (QE)
/Input/K4_CTR: K603.3, U606.7 (QH)
/Input/M1_1: R615.1, U601.1
/Input/M1_2: R616.1, U601.16
/Input/M1_3: R617.1, U601.9
/Input/M1_4: R618.1, U601.8
/Input/M2_1: R614.1, U602.1
/Input/M2_2: R613.1, U602.16
/Input/M2_3: R612.1, U602.9
/Input/M2_4: R611.1, U602.8
/Input/SR_CLK: U604.4 (B); also elsewhere on the board
/Input/SR_DAT: U603.4 (B); also elsewhere on the board
/Input/SR_LAT: U605.4 (B); also elsewhere on the board
AGNDF: C601.2, C602.2, C603.2, C604.2, C605.2, C606.2, C607.2, C608.2, C609.2, C610.1, C611.2, C612.2, C613.2, C614.2, C615.2, C616.2, C618.2, C619.2, C621.2, C622.2, C623.2, C624.2, R610.2, U601.5 (GND), U602.5 (GND), U602.6, U603.2 (GND), U603.5 (DIR), U604.2 (GND), U604.5 (DIR), U605.2 (GND), U605.5 (DIR), U606.8 (GND), U606.13 (~OE), U607.8 (GND), U607.13 (~OE), U613.3, U613.9 (EP); also elsewhere on the board
unnamed: C610.2, R620.1, R621.2
unnamed: C617.1, U608.8 (TRIM)
unnamed: C620.1, U608.1 (TRIM)
unnamed: C624.1, R623.1, U610.3 (+)
unnamed: C625.1, U602.2, U613.2, U613.4
unnamed: K601.4, K603.1, L601.1, R619.2
unnamed: K602.4, R601.2
unnamed: K603.4, R609.1, R610.1
unnamed: L601.2, R619.1, R620.2
unnamed: Q601.1 (B), R624.2, R626.2, U611.1 (K)
unnamed: Q602.1 (B), R625.1, R627.2, U612.3 (A)
unnamed: R601.1, R602.2
unnamed: R602.1, R603.2
unnamed: R603.1, R604.2
unnamed: R604.1, R605.2
unnamed: R605.1, R606.2
unnamed: R606.1, R607.2
unnamed: R607.1, R608.2
unnamed: R608.1, R609.2
unnamed: R611.2, U607.15 (QA)
unnamed: R612.2, U607.1 (QB)
unnamed: R613.2, U607.2 (QC)
unnamed: R614.2, U607.3 (QD)
unnamed: R615.2, U607.4 (QE)
unnamed: R616.2, U607.5 (QF)
unnamed: R617.2, U607.6 (QG)
unnamed: R618.2, U607.7 (QH)
unnamed: R621.1, U601.2
unnamed: R622.1, U608.3 (+)
unnamed: R622.2, U601.3, U601.6, U601.11, U601.14
unnamed: R623.2, U602.3, U602.14, U608.2 (-), U609.2 (-)
unnamed: R626.1, R628.1, U611.2 (REF)
unnamed: R627.1, R629.2, U612.2 (REF)
unnamed: R628.2, R629.1, U610.2 (-), U610.6, U611.3 (A), U612.1 (K)
unnamed: R630.2, U602.11
unnamed: U601.7, U602.7, U602.10
unnamed: U603.3 (A), U606.14 (SER)
unnamed: U604.3 (A), U606.11 (SRCLK), U607.11 (SRCLK)
unnamed: U605.3 (A), U606.12 (RCLK), U607.12 (RCLK)
unnamed: U606.9 (QH'), U607.14 (SER)
unnamed: U608.6, U609.3 (+)
unnamed: U613.5, U613.8
unnamed: U613.6, U613.7
VCC: C602.1, Q601.2 (E), U608.7 (V+), U610.7 (V+)
VDD: C601.1, C617.2, C620.2, Q602.2 (E), U608.4 (V-), U610.4 (V-)

Notes on the sheet:
C1206C472FAGECTU

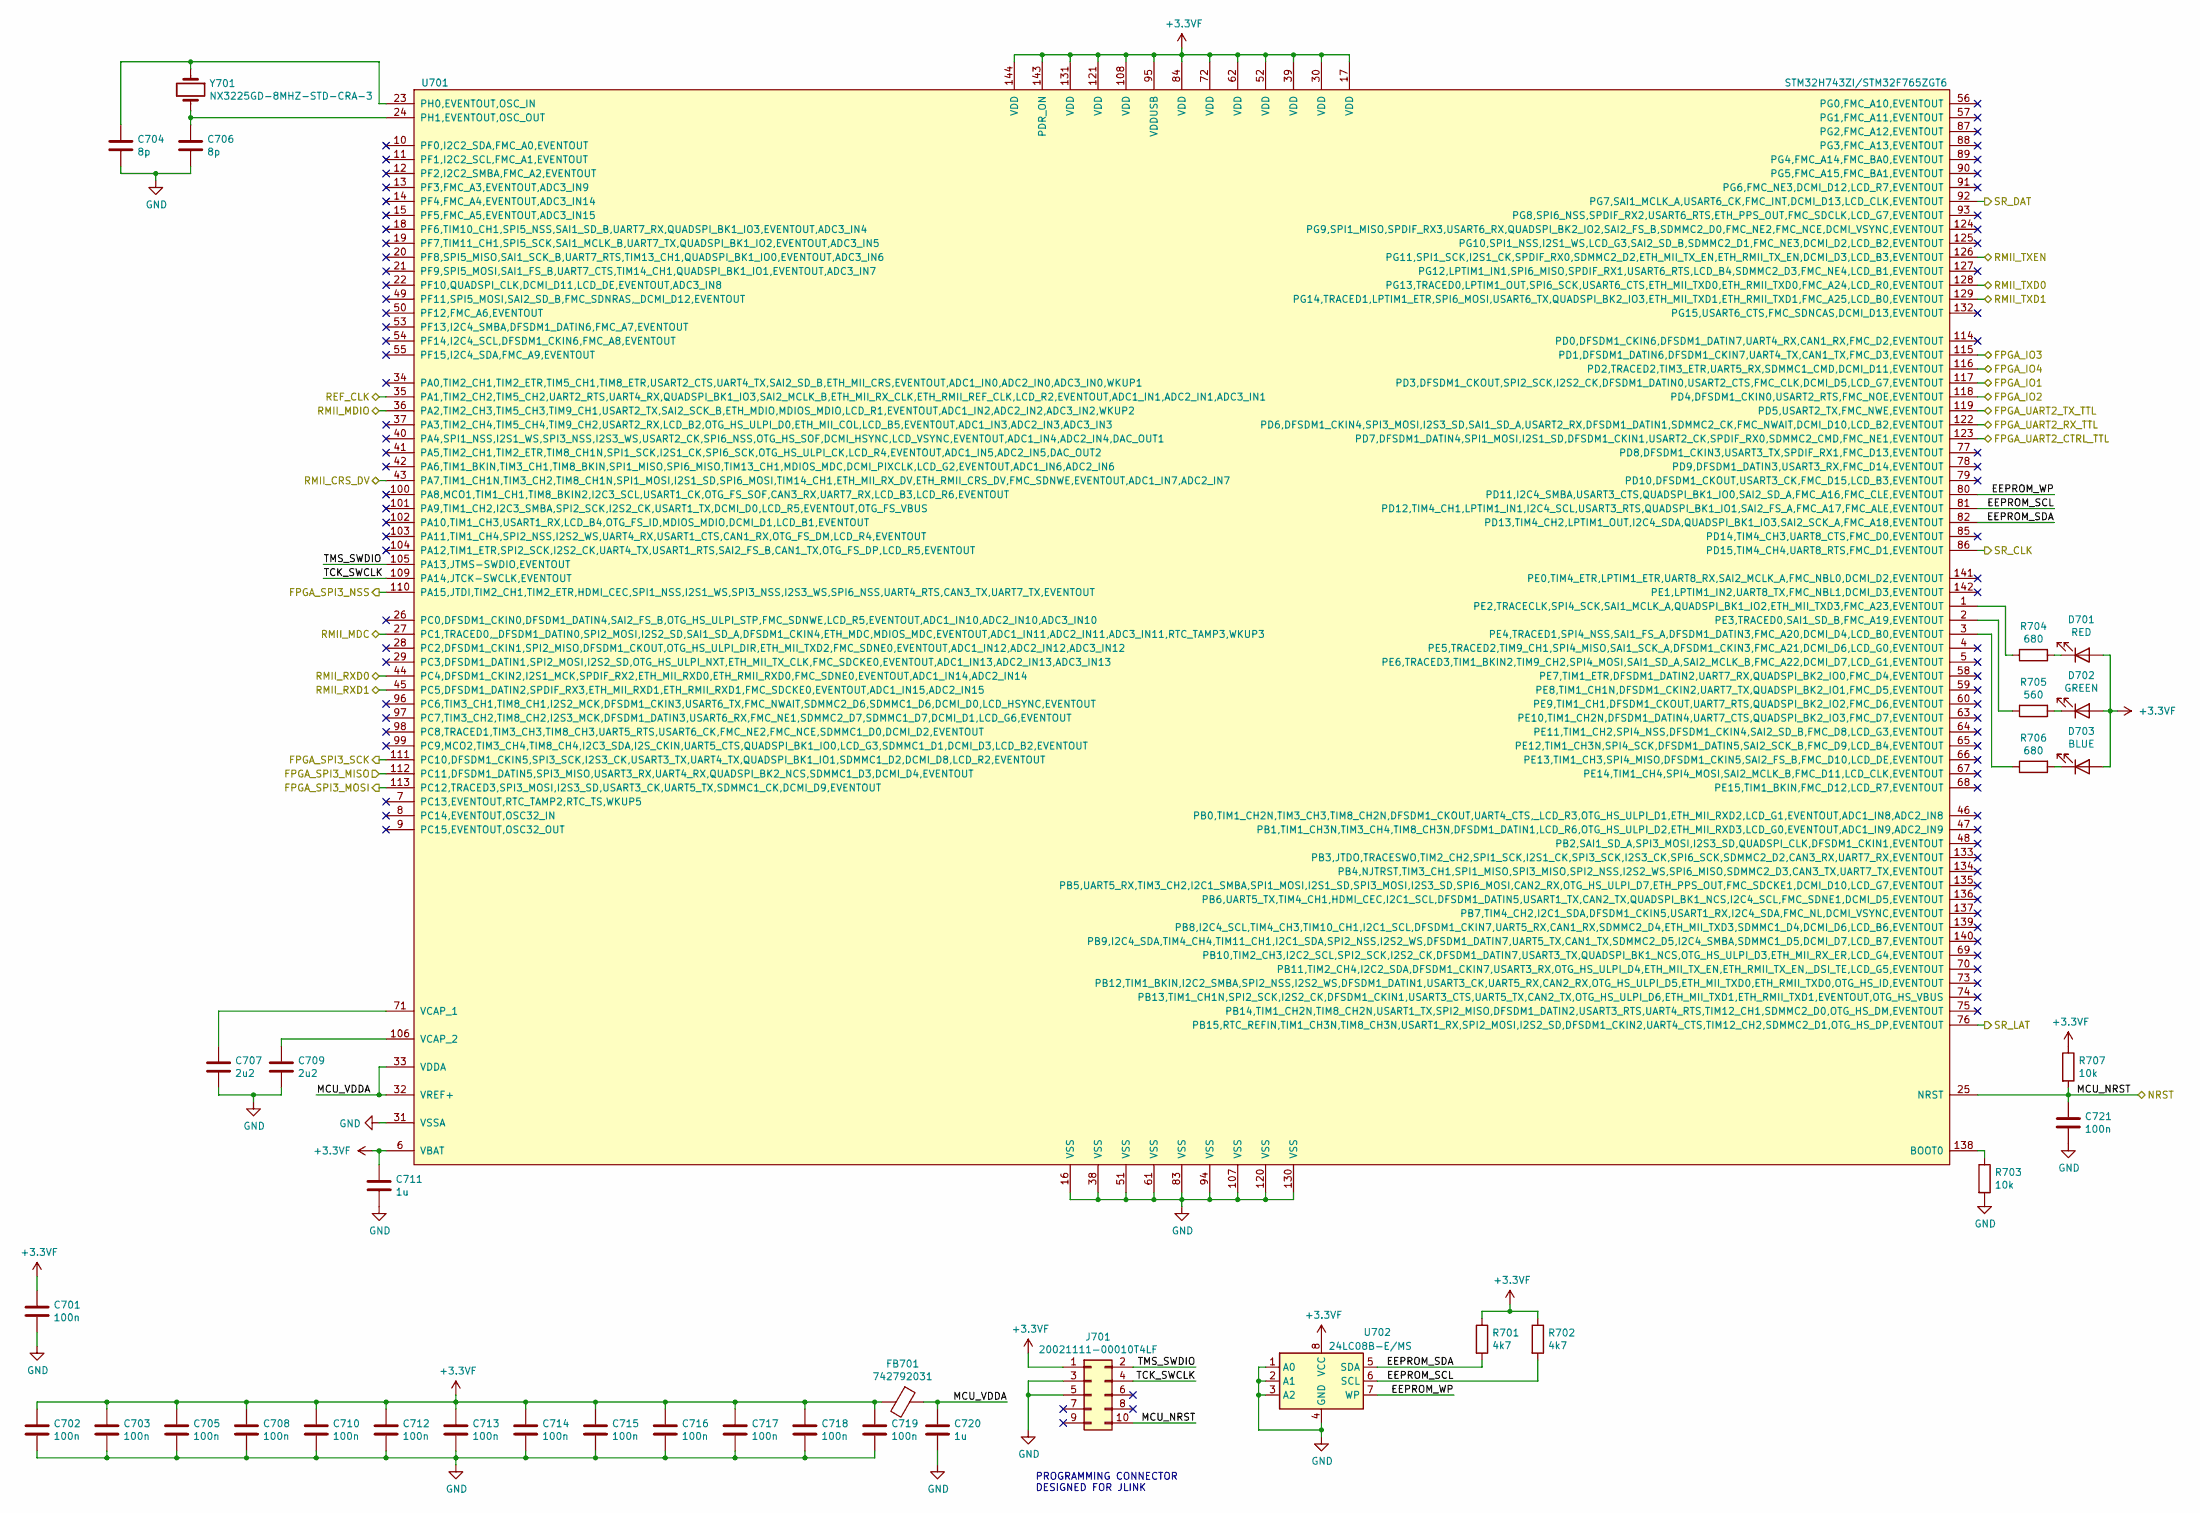
[picture p32: schematic MCU.sch]

Parts:
C701, C702, C703, C705, C708, C710, C712, C713, C714, C715, C716, C717, C718, C719, C721: 100n; C_0603_1608Metric_Pad1.05x0.95mm_HandSolder
C704, C706: 8p; C_0603_1608Metric_Pad1.05x0.95mm_HandSolder
C707, C709: 2u2; C_0805_2012Metric_Pad1.15x1.40mm_HandSolder
C711, C720: 1u; C_0603_1608Metric_Pad1.05x0.95mm_HandSolder
D701: RED; LED_0603_1608Metric_Pad1.05x0.95mm_HandSolder
D702: GREEN; LED_0603_1608Metric_Pad1.05x0.95mm_HandSolder
D703: BLUE; LED_0603_1608Metric_Pad1.05x0.95mm_HandSolder
FB701: 742792031; L_0805_2012Metric_Pad1.15x1.40mm_HandSolder
J701: 20021111-00010T4LF; PinHeader_2x05_P1.27mm_Vertical
R701, R702: 4k7; R_0603_1608Metric_Pad1.05x0.95mm_HandSolder
R703, R707: 10k; R_0603_1608Metric_Pad1.05x0.95mm_HandSolder
R704, R706: 680; R_0603_1608Metric_Pad1.05x0.95mm_HandSolder
R705: 560; R_0603_1608Metric_Pad1.05x0.95mm_HandSolder
U701: STM32H743ZI/STM32F765ZGT6; TQFP-144_20x20mm_P0.5mm
U702: 24LC08B-E/MS; MSOP-8_3x3mm_P0.65mm
Y701: NX3225GD-8MHZ-STD-CRA-3; NX3225GD

Connections:
+3.3VF: C701.1, C702.1, C703.1, C705.1, C708.1, C710.1, C711.1, C712.1, C713.1, C714.1, C715.1, C716.1, C717.1, C718.1, C719.1, D701.2 (A), D702.2 (A), D703.2 (A), FB701.2, J701.1, R701.1, R702.1, R707.1, U701.6 (VBAT), U701.17 (VDD), U701.30 (VDD), U701.39 (VDD), U701.52 (VDD), U701.62 (VDD), U701.72 (VDD), U701.84 (VDD), U701.95 (VDDUSB), U701.108 (VDD), U701.121 (VDD), U701.131 (VDD), U701.143 (PDR_ON), U701.144 (VDD), U702.8 (VCC); also elsewhere on the board
/Ethernet/NRST: C721.1, J701.10, R707.2, U701.25 (NRST); also elsewhere on the board
/Ethernet/REF_CLK: U701.35 (PA1,TIM2_CH2,TIM5_CH2,UART2_RTS,UART4_R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); also elsewhere on the board
/Ethernet/RMII_CRS_DV: U701.43 (PA7,TIM1_CH1N,TIM3_CH2,TIM8_CH1N,SPI1_M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); also elsewhere on the board
/Ethernet/RMII_MDC: U701.27 (PC1,TRACED0,_DFSDM1_DATIN0,SPI2_MOSI,I2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); also elsewhere on the board
/Ethernet/RMII_MDIO: U701.36 (PA2,TIM2_CH3,TIM5_CH3,TIM9_CH1,USART2_T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); also elsewhere on the board
/Ethernet/RMII_RXD0: U701.44 (PC4,DFSDM1_CKIN2,I2S1_MCK,SPDIF_RX2,ETH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); also elsewhere on the board
/Ethernet/RMII_RXD1: U701.45 (PC5,DFSDM1_DATIN2,SPDIF_RX3,ETH_MII_RXD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); also elsewhere on the board
/Ethernet/RMII_TXD0: U701.128 (PG13,TRACED0,LPTIM1_OUT,SPI6_SCK,USART6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); also elsewhere on the board
/Ethernet/RMII_TXD1: U701.129 (PG14,TRACED1,LPTIM1_ETR,SPI6_MOSI,USART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); also elsewhere on the board
/Ethernet/RMII_TXEN: U701.126 (PG11,SPI1_SCK,I2S1_CK,SPDIF_RX0,SDMMC2_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); also elsewhere on the board
/FPGA/FPGA_IO1: U701.117 (PD3,DFSDM1_CKOUT,SPI2_SCK,I2S2_CK,DFSDM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); also elsewhere on the board
/FPGA/FPGA_IO2: U701.118 (PD4,DFSDM1_CKIN0,USART2_RTS,FMC_NOE,EVE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); also elsewhere on the board
/FPGA/FPGA_IO3: U701.115 (PD1,DFSDM1_DATIN6,DFSDM1_CKIN7,UART4_TX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); also elsewhere on the board
/FPGA/FPGA_IO4: U701.116 (PD2,TRACED2,TIM3_ETR,UART5_RX,SDMMC1_CM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); also elsewhere on the board
/FPGA/FPGA_SPI3_MISO: U701.112 (PC11,DFSDM1_DATIN5,SPI3_MISO,USART3_RX,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); also elsewhere on the board
/FPGA/FPGA_SPI3_MOSI: U701.113 (PC12,TRACED3,SPI3_MOSI,I2S3_SD,USART3_C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); also elsewhere on the board
/FPGA/FPGA_SPI3_NSS: U701.110 (PA15,JTDI,TIM2_CH1,TIM2_ETR,HDMI_CEC,SP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); also elsewhere on the board
/FPGA/FPGA_SPI3_SCK: U701.111 (PC10,DFSDM1_CKIN5,SPI3_SCK,I2S3_CK,USAR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); also elsewhere on the board
/FPGA/FPGA_UART2_CTRL_TTL: U701.123 (PD7,DFSDM1_DATIN4,SPI1_MOSI,I2S1_SD,DFS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); also elsewhere on the board
/FPGA/FPGA_UART2_RX_TTL: U701.122 (PD6,DFSDM1_CKIN4,SPI3_MOSI,I2S3_SD,SAI1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); also elsewhere on the board
/FPGA/FPGA_UART2_TX_TTL: U701.119 (PD5,USART2_TX,FMC_NWE,EVENTOUT); also elsewhere on the board
/Input/SR_CLK: U701.86 (PD15,TIM4_CH4,UART8_RTS,FMC_D1,EVENTOUT); also elsewhere on the board
/Input/SR_DAT: U701.92 (PG7,SAI1_MCLK_A,USART6_CK,FMC_INT,DCMI_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); also elsewhere on the board
/Input/SR_LAT: U701.76 (PB15,RTC_REFIN,TIM1_CH3N,TIM8_CH3N,USAR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); also elsewhere on the board
/MCU/EEPROM_SCL: R702.2, U701.81 (PD12,TIM4_CH1,LPTIM1_IN1,I2C4_SCL,USART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), U702.6 (SCL)
/MCU/EEPROM_SDA: R701.2, U701.82 (PD13,TIM4_CH2,LPTIM1_OUT,I2C4_SDA,QUADS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), U702.5 (SDA)
/MCU/EEPROM_WP: U701.80 (PD11,I2C4_SMBA,USART3_CTS,QUADSPI_BK1_I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), U702.7 (WP)
/MCU/MCU_VDDA: C720.1, FB701.1, U701.32 (VREF+), U701.33 (VDDA)
/MCU/TCK_SWCLK: J701.4, U701.109 (PA14,JTCK-SWCLK,EVENTOUT)
/MCU/TMS_SWDIO: J701.2, U701.105 (PA13,JTMS-SWDIO,EVENTOUT)
AGNDF: C701.2, C702.2, C703.2, C704.2, C705.2, C706.2, C707.2, C708.2, C709.2, C710.2, C711.2, C712.2, C713.2, C714.2, C715.2, C716.2, C717.2, C718.2, C719.2, C720.2, C721.2, J701.3, J701.5, R703.2, U701.16 (VSS), U701.31 (VSSA), U701.38 (VSS), U701.51 (VSS), U701.61 (VSS), U701.83 (VSS), U701.94 (VSS), U701.107 (VSS), U701.120 (VSS), U701.130 (VSS), U702.1 (A0), U702.2 (A1), U702.3 (A2), U702.4 (GND); also elsewhere on the board
unnamed: C704.1, U701.23 (PH0,EVENTOUT,OSC_IN), Y701.1
unnamed: C706.1, U701.24 (PH1,EVENTOUT,OSC_OUT), Y701.2
unnamed: C707.1, U701.71 (VCAP_1)
unnamed: C709.1, U701.106 (VCAP_2)
unnamed: D701.1 (K), R704.2
unnamed: D702.1 (K), R705.2
unnamed: D703.1 (K), R706.2
unnamed: R703.1, U701.138 (BOOT0)
unnamed: R704.1, U701.1 (PE2,TRACECLK,SPI4_SCK,SAI1_MCLK_A,QUADS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)
unnamed: R705.1, U701.2 (PE3,TRACED0,SAI1_SD_B,FMC_A19,EVENTOUT)
unnamed: R706.1, U701.3 (PE4,TRACED1,SPI4_NSS,SAI1_FS_A,DFSDM1_D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)

Notes on the sheet:
PROGRAMMING CONNECTOR DESIGNED FOR JLINK

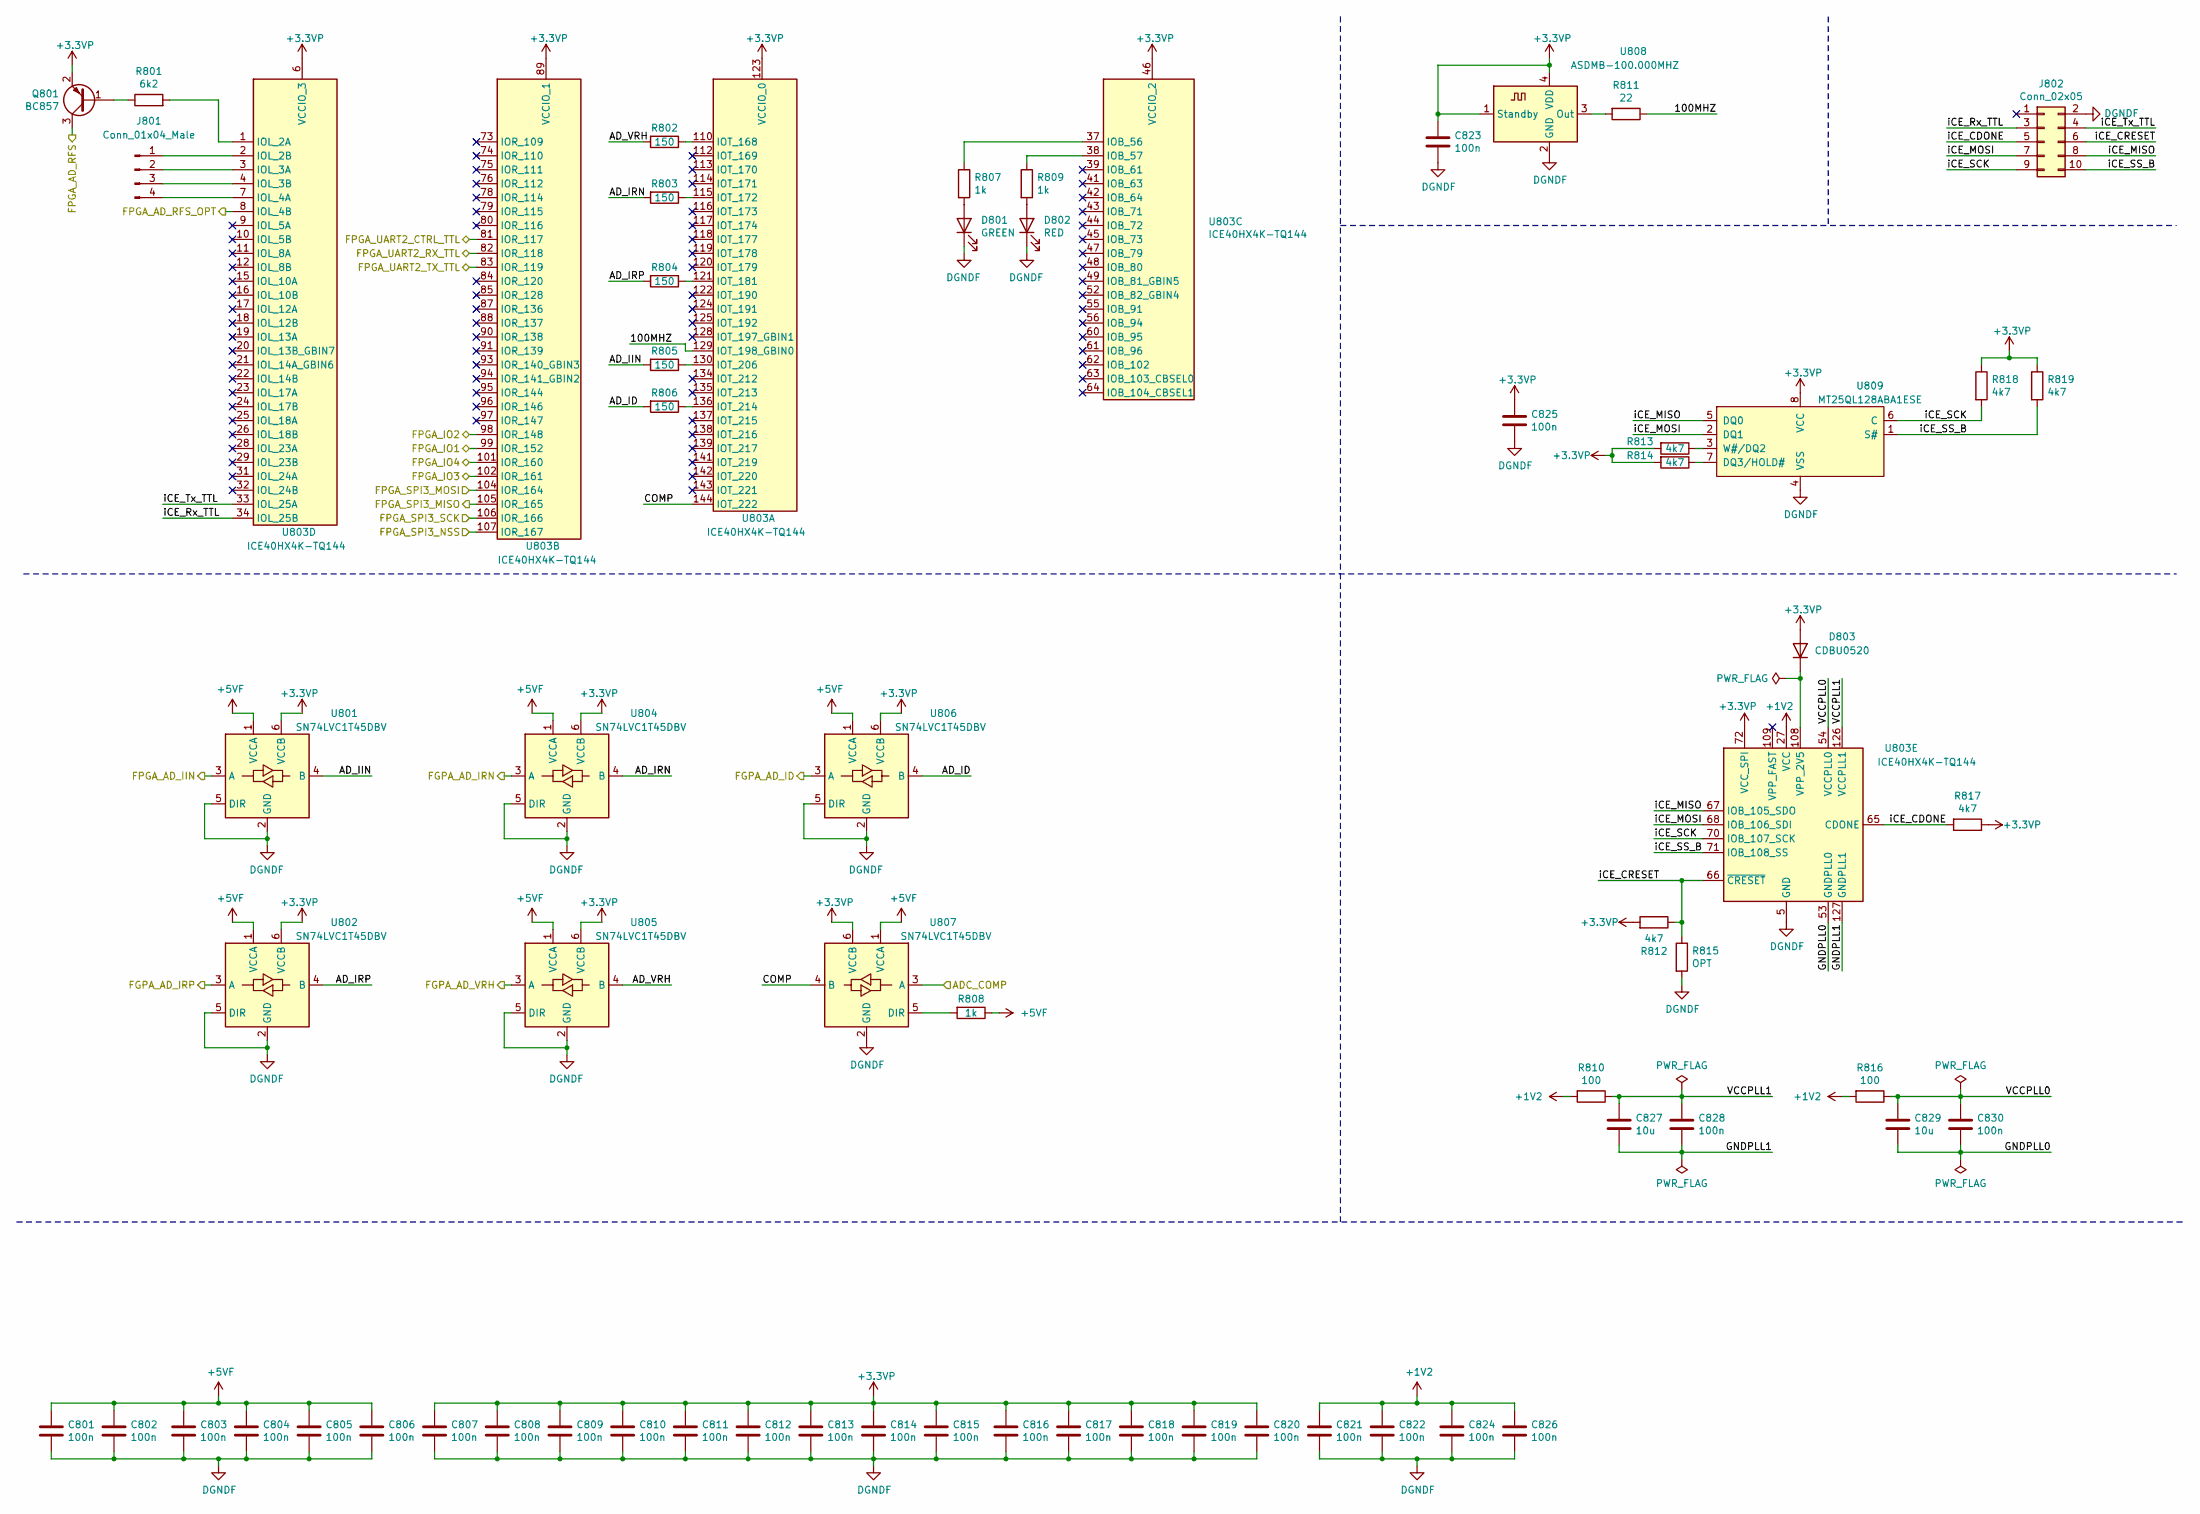
[picture p33: schematic FPGA.sch]

Parts:
C801, C802, C803, C804, C805, C806, C807, C808, C809, C810, C811, C812, C813, C814, C815, C816, C817, C818, C819, C820, C821, C822, C823, C824, C825, C826, C828, C830: 100n; C_0603_1608Metric_Pad1.05x0.95mm_HandSolder
C827, C829: 10u; C_0805_2012Metric_Pad1.15x1.40mm_HandSolder
D801: GREEN; LED_0603_1608Metric_Pad1.05x0.95mm_HandSolder
D802: RED; LED_0603_1608Metric_Pad1.05x0.95mm_HandSolder
D803: CDBU0520; D_SOD-523
J801: Conn_01x04_Male; PinHeader_1x04_P2.54mm_Vertical
J802: Conn_02x05; PinHeader_2x05_P2.54mm_Vertical
Q801: BC857; SOT-23
R801: 6k2; R_0603_1608Metric_Pad1.05x0.95mm_HandSolder
R802, R803, R804, R805, R806: 150; R_0603_1608Metric_Pad1.05x0.95mm_HandSolder
R807, R808, R809: 1k; R_0603_1608Metric_Pad1.05x0.95mm_HandSolder
R810, R816: 100; R_0603_1608Metric_Pad1.05x0.95mm_HandSolder
R811: 22; R_0603_1608Metric_Pad1.05x0.95mm_HandSolder
R812, R813, R814, R817, R818, R819: 4k7; R_0603_1608Metric_Pad1.05x0.95mm_HandSolder
R815: OPT; R_0603_1608Metric_Pad1.05x0.95mm_HandSolder
U801, U802, U804, U805, U806, U807: SN74LVC1T45DBV; SOT-23-6
U803: ICE40HX4K-TQ144; TQFP-144_20x20mm_P0.5mm
U808: ASDMB-100.000MHZ; Oscillator_SMD_Abracon_ASDMB-4Pin_2.5x2.0mm
U809: MT25QL128ABA1ESE; SOIC-8_5.23x5.23mm_P1.27mm

Connections:
+1V2: C821.1, C822.1, C824.1, C826.1, R810.2, R816.2, U803.27 (VCC), U803.40 (VCC), U803.92 (VCC), U803.111 (VCC); also elsewhere on the board
+3.3VP: C807.1, C808.1, C809.1, C810.1, C811.1, C812.1, C813.1, C814.1, C815.1, C816.1, C817.1, C818.1, C819.1, C820.1, C823.1, C825.1, D803.2 (A), Q801.2 (E), R812.2, R813.2, R814.2, R817.1, R818.1, R819.1, U801.6 (VCCB), U802.6 (VCCB), U803.6 (VCCIO_3), U803.30 (VCCIO_3), U803.46 (VCCIO_2), U803.57 (VCCIO_2), U803.72 (VCC_SPI), U803.89 (VCCIO_1), U803.100 (VCCIO_1), U803.123 (VCCIO_0), U803.131 (VCCIO_0), U804.6 (VCCB), U805.6 (VCCB), U806.6 (VCCB), U807.6 (VCCB), U808.1 (Standby), U808.4 (VDD), U809.8 (VCC); also elsewhere on the board
+5VF: C801.1, C802.1, C803.1, C804.1, C805.1, C806.1, R808.1, U801.1 (VCCA), U802.1 (VCCA), U804.1 (VCCA), U805.1 (VCCA), U806.1 (VCCA), U807.1 (VCCA); also elsewhere on the board
/ADC/FGPA_AD_ID: U806.3 (A); also elsewhere on the board
/ADC/FGPA_AD_IIN: U801.3 (A); also elsewhere on the board
/ADC/FGPA_AD_IRN: U804.3 (A); also elsewhere on the board
/ADC/FGPA_AD_IRP: U802.3 (A); also elsewhere on the board
/ADC/FPGA_AD_RFS: Q801.3 (C); also elsewhere on the board
/ADC/FPGA_AD_RFS_OPT: U803.8 (IOL_4B); also elsewhere on the board
/FPGA/100MHZ: R811.1, U803.129 (IOT_198_GBIN0)
/FPGA/ADC_COMP: U807.3 (A); also elsewhere on the board
/FPGA/AD_ID: R806.2, U806.4 (B)
/FPGA/AD_IIN: R805.2, U801.4 (B)
/FPGA/AD_IRN: R803.2, U804.4 (B)
/FPGA/AD_IRP: R804.2, U802.4 (B)
/FPGA/AD_VRH: R802.2, U805.4 (B)
/FPGA/COMP: U803.144 (IOT_222), U807.4 (B)
/FPGA/FGPA_AD_VRH: U805.3 (A); also elsewhere on the board
/FPGA/FPGA_IO1: U803.99 (IOR_152); also elsewhere on the board
/FPGA/FPGA_IO2: U803.98 (IOR_148); also elsewhere on the board
/FPGA/FPGA_IO3: U803.102 (IOR_161); also elsewhere on the board
/FPGA/FPGA_IO4: U803.101 (IOR_160); also elsewhere on the board
/FPGA/FPGA_SPI3_MISO: U803.105 (IOR_165); also elsewhere on the board
/FPGA/FPGA_SPI3_MOSI: U803.104 (IOR_164); also elsewhere on the board
/FPGA/FPGA_SPI3_NSS: U803.107 (IOR_167); also elsewhere on the board
/FPGA/FPGA_SPI3_SCK: U803.106 (IOR_166); also elsewhere on the board
/FPGA/FPGA_UART2_CTRL_TTL: U803.81 (IOR_117); also elsewhere on the board
/FPGA/FPGA_UART2_RX_TTL: U803.82 (IOR_118); also elsewhere on the board
/FPGA/FPGA_UART2_TX_TTL: U803.83 (IOR_119); also elsewhere on the board
/FPGA/GNDPLL0: C829.2, C830.2, U803.53 (GNDPLL0)
/FPGA/GNDPLL1: C827.2, C828.2, U803.127 (GNDPLL1)
/FPGA/VCCPLL0: C829.1, C830.1, R816.1, U803.54 (VCCPLL0)
/FPGA/VCCPLL1: C827.1, C828.1, R810.1, U803.126 (VCCPLL1)
/FPGA/iCE_CDONE: J802.5, R817.2, U803.65 (CDONE)
/FPGA/iCE_CRESET: J802.6, R812.1, R815.1, U803.66 (~CRESET)
/FPGA/iCE_MISO: J802.8, U803.67 (IOB_105_SDO), U809.5 (DQ0)
/FPGA/iCE_MOSI: J802.7, U803.68 (IOB_106_SDI), U809.2 (DQ1)
/FPGA/iCE_Rx_TTL: J802.3, U803.34 (IOL_25B)
/FPGA/iCE_SCK: J802.9, R818.2, U803.70 (IOB_107_SCK), U809.6 (C)
/FPGA/iCE_SS_B: J802.10, R819.2, U803.71 (IOB_108_SS), U809.1 (S#)
/FPGA/iCE_Tx_TTL: J802.4, U803.33 (IOL_25A)
AGNDF: C801.2, C802.2, C803.2, C804.2, C805.2, C806.2, C807.2, C808.2, C809.2, C810.2, C811.2, C812.2, C813.2, C814.2, C815.2, C816.2, C817.2, C818.2, C819.2, C820.2, C821.2, C822.2, C823.2, C824.2, C825.2, C826.2, D801.1 (K), D802.1 (K), J802.2, R815.2, U801.2 (GND), U801.5 (DIR), U802.2 (GND), U802.5 (DIR), U803.5 (GND), U803.13 (GND), U803.14 (GND), U803.59 (GND), U803.69 (GND), U803.86 (GND), U803.103 (GND), U803.132 (GND), U803.140 (GND), U804.2 (GND), U804.5 (DIR), U805.2 (GND), U805.5 (DIR), U806.2 (GND), U806.5 (DIR), U807.2 (GND), U808.2 (GND), U809.4 (VSS); also elsewhere on the board
unnamed: D801.2 (A), R807.2
unnamed: D802.2 (A), R809.2
unnamed: D803.1 (K), U803.108 (VPP_2V5)
unnamed: J801.1, U803.2 (IOL_2B)
unnamed: J801.2, U803.3 (IOL_3A)
unnamed: J801.3, U803.4 (IOL_3B)
unnamed: J801.4, U803.7 (IOL_4A)
unnamed: Q801.1 (B), R801.1
unnamed: R801.2, U803.1 (IOL_2A)
unnamed: R802.1, U803.110 (IOT_168)
unnamed: R803.1, U803.115 (IOT_172)
unnamed: R804.1, U803.121 (IOT_181)
unnamed: R805.1, U803.130 (IOT_206)
unnamed: R806.1, U803.136 (IOT_214)
unnamed: R807.1, U803.37 (IOB_56)
unnamed: R808.2, U807.5 (DIR)
unnamed: R809.1, U803.38 (IOB_57)
unnamed: R811.2, U808.3 (Out)
unnamed: R813.1, U809.3 (W#/DQ2)
unnamed: R814.1, U809.7 (DQ3/HOLD#)

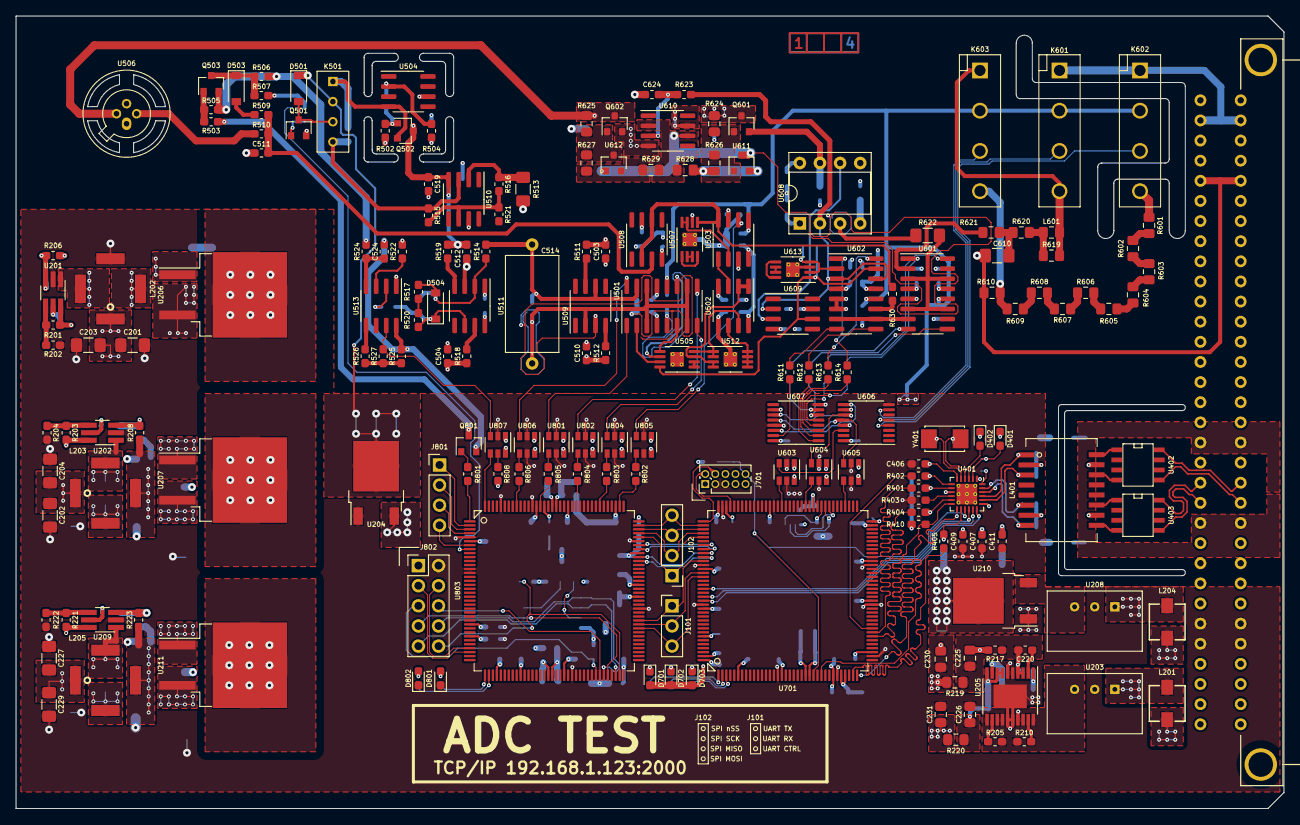
[picture p34: board ADC_Test.kicad_pcb from above]

Board: 4 copper layers, 160.0 x 100.0 mm, 383 parts (0 on the bottom side), 257 nets.
