mfkiwl/ADC_Test-icd40hx/doc/vm_mini-master/pcb_eagle/vm_mini_exp5.brd

## EAGLE design doc/vm_mini-master/pcb_eagle/vm_mini_exp5.brd (2020-10-08)

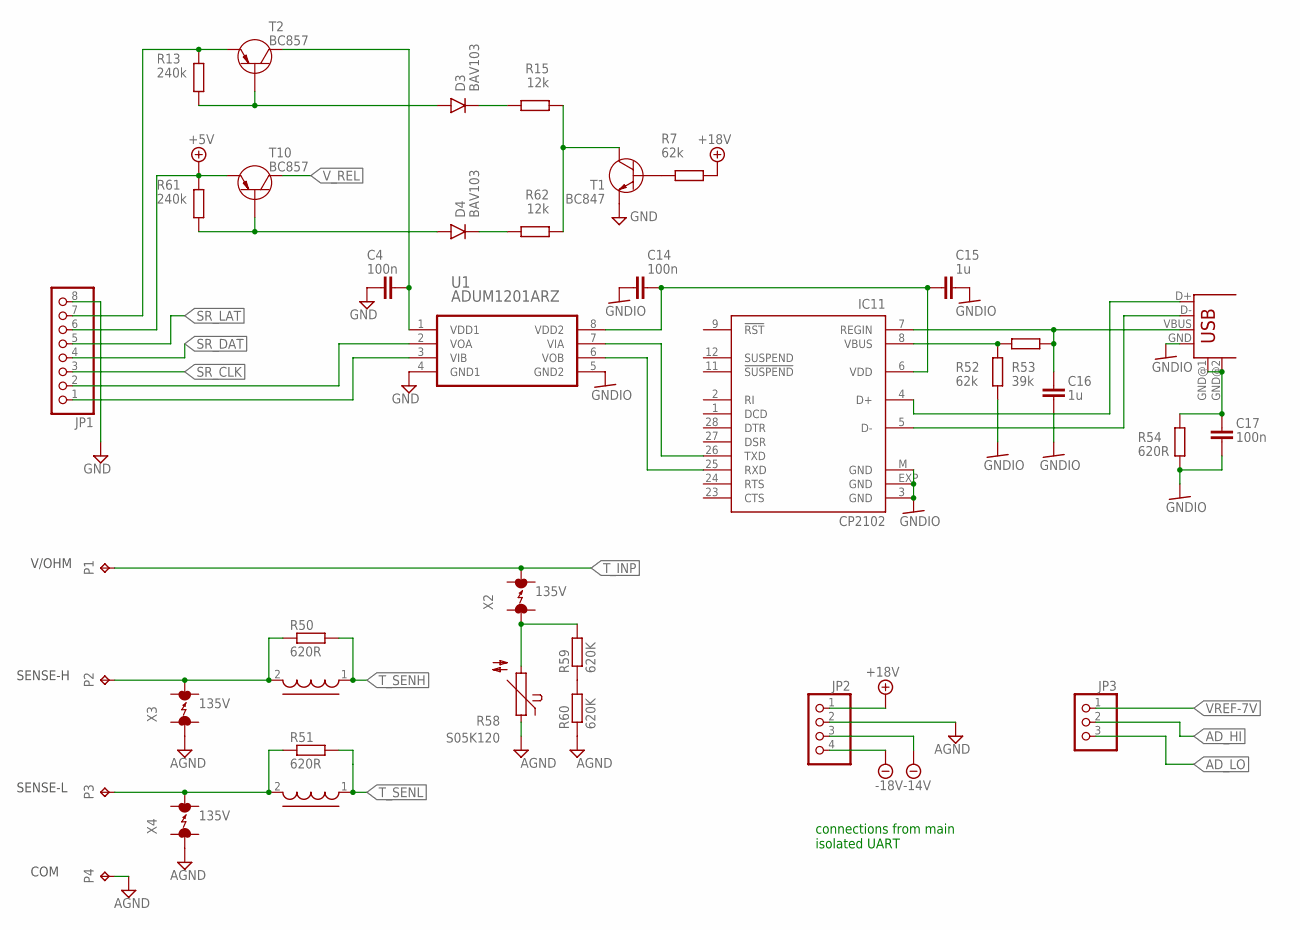
[picture p35: schematic vm_mini_exp5.sch, sheet 1]

Parts:
C4, C14, C17: 100n; R0805
C15, C16: 1u; R0805
D3, D4: BAV103; SOD-80
IC11: CP2102; MLP28
JP1: PINHD-1X08_2.54; 1X08
JP2: PINHD-1X04_2.54; 1X04
JP3: PINHD-1X03_2.54; 1X03
P1, P2, P3, P4: TPPAD1-17; P1-17
R7, R52: 62k; R_MINIMELF
R13, R61: 240k; R_MINIMELF
R15, R62: 12k; R_MINIMELF
R50, R51, R54: 620R; R_MINIMELF
R53: 39k; R_MINIMELF
R58: S05K120; S05K175
R59, R60: 620K; R_MINIMELF
T1: BC847; SOT23
T2, T10: BC857; SOT23
U1: ADUM1201ARZ; SOIC127P600X175-8N
U$7, U$8: INDUCTOR_GEN1210; 1210
USB1: USB-B-H
X2, X3, X4: 135V; EPCOS_N81

Connections:
+5V: JP1.6, R61.P$1 (1), T10.2 (C); also elsewhere on the board
+18V: JP2.1, R7.P$2 (2); also elsewhere on the board
-14V: JP2.3; also elsewhere on the board
-18V: JP2.4; also elsewhere on the board
AD_HI: JP3.2; also elsewhere on the board
AD_LO: JP3.3; also elsewhere on the board
AGND: JP2.2, P4.TP, R58.1, R60.P$1 (1), X3.1, X4.1; also elsewhere on the board
GND: C4.1, JP1.8, T1.2 (E), U1.4 (GND1); also elsewhere on the board
GNDIO: C14.1, C15.2, C16.1, C17.1, IC11.3 (GND), IC11.EXP (GND), IC11.M (GND), R52.P$2 (2), R54.P$2 (2), U1.5 (GND2), USB1.GND
unnamed: JP1.1, U1.3 (VIB)
unnamed: JP1.2, U1.2 (VOA)
unnamed: IC11.4 (D+), USB1.D+
unnamed: IC11.5 (D-), USB1.D-
unnamed: C16.2, IC11.7 (REGIN), R53.P$1 (1), USB1.VBUS
unnamed: R58.2, R59.P$2 (2), X2.1
unnamed: IC11.26 (TXD), U1.7 (VIA)
unnamed: IC11.25 (RXD), U1.6 (VOB)
unnamed: C14.2, C15.1, IC11.6 (VDD), U1.8 (VDD2)
unnamed: IC11.8 (VBUS), R52.P$1 (1), R53.P$2 (2)
unnamed: C17.2, R54.P$1 (1), USB1.GND@1 (GND), USB1.GND@2 (GND)
unnamed: R15.P$1 (1), R62.P$1 (1), T1.3 (C)
unnamed: D3.A, R13.P$2 (2), T2.1 (B)
unnamed: D4.K, R62.P$2 (2)
unnamed: R7.P$1 (1), T1.1 (B)
unnamed: R59.P$1 (1), R60.P$2 (2)
unnamed: P3.TP, R51.P$1 (1), U$8.2, X4.2
unnamed: P2.TP, R50.P$1 (1), U$7.2, X3.2
unnamed: JP1.7, R13.P$1 (1), T2.2 (C)
unnamed: D4.A, R61.P$2 (2), T10.1 (B)
unnamed: C4.2, T2.3 (E), U1.1 (VDD1)
unnamed: D3.K, R15.P$2 (2)
SR_CLK: JP1.3; also elsewhere on the board
SR_DAT: JP1.4; also elsewhere on the board
SR_LAT: JP1.5; also elsewhere on the board
T_INP: P1.TP, X2.2; also elsewhere on the board
T_SENH: R50.P$2 (2), U$7.1; also elsewhere on the board
T_SENL: R51.P$2 (2), U$8.1; also elsewhere on the board
VREF-7V: JP3.1; also elsewhere on the board
V_REL: T10.3 (E); also elsewhere on the board

Notes on the sheet:
V/OHM
SENSE-H
SENSE-L
COM
connections from main isolated UART

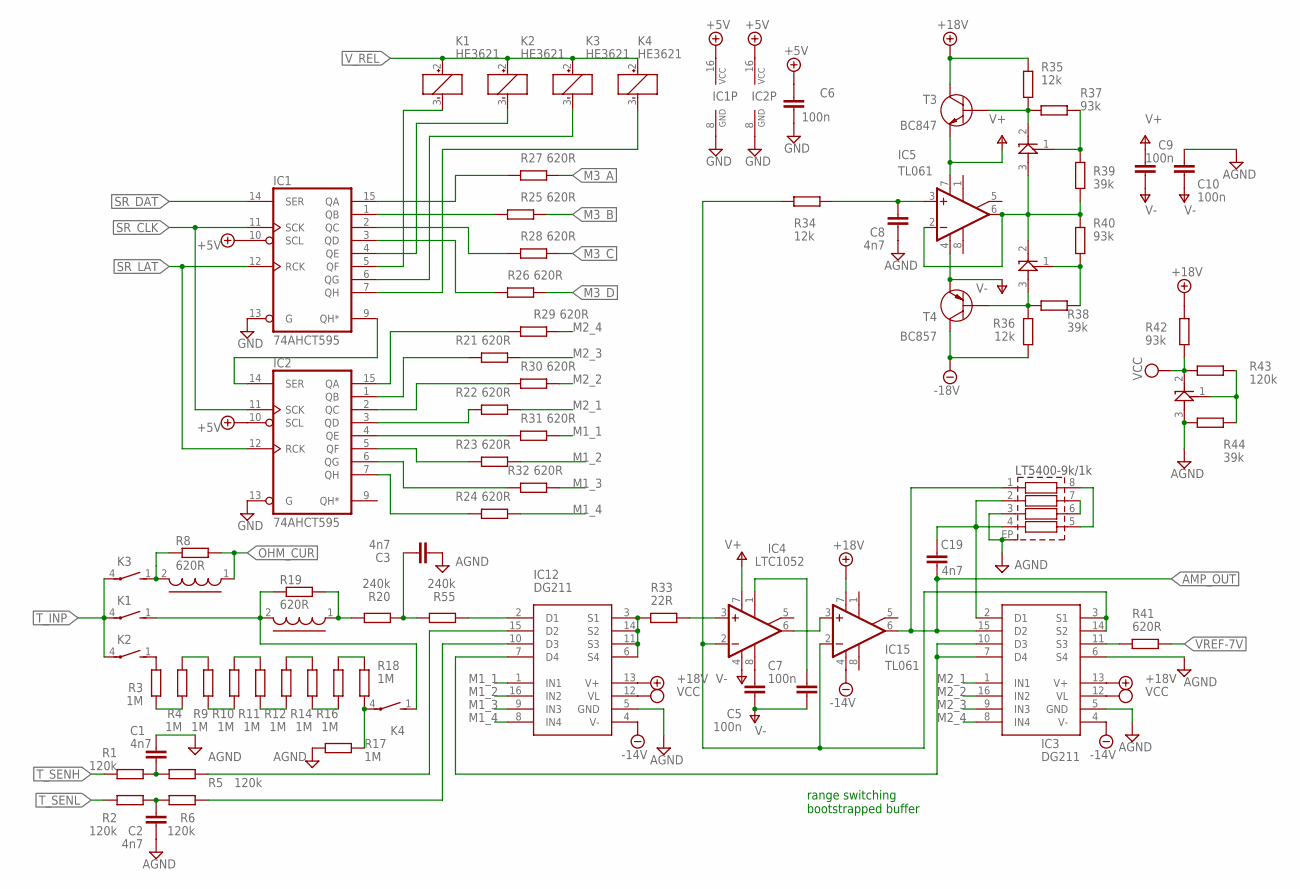
[picture p36: schematic vm_mini_exp5.sch, sheet 2]

Parts:
C1, C2, C3, C8, C19: 4n7; C050-025X075
C5, C7: 100n; C050-045X075
C6, C9, C10: 100n; R0805
IC1, IC2: 74AHCT595; SO16
IC3, IC12: DG211; SO-16
IC4: LTC1052; DIL08
IC5, IC15: TL061; SO08
IC6, IC13, IC14: TL431_SOT23; SOT23
K1, K2, K3, K4: HE3621
R1, R2, R5, R6, R43: 120k; R_MINIMELF
R3, R4, R9, R10, R11, R12, R14, R16, R17, R18: 1M; R_MINIMELF
R8, R19, R21, R22, R23, R24, R25, R26, R27, R28, R29, R30, R31, R32, R41: 620R; R_MINIMELF
R20, R55: 240k; R_MINIMELF
R33: 22R; R_MINIMELF
R34, R35, R36: 12k; R_MINIMELF
R37, R40, R42: 93k; R_MINIMELF
R38, R39, R44: 39k; R_MINIMELF
RN3: LT5400; MSOP8-EP
T3: BC847; SOT23
T4: BC857; SOT23
U$1, U$2: INDUCTOR_GEN1210; 1210

Connections:
+5V: C6.1, IC1.10 (SCL), IC1.16 (VCC), IC2.10 (SCL), IC2.16 (VCC); also elsewhere on the board
+18V: IC3.13 (V+), IC12.13 (V+), IC15.7 (V+), R35.P$2 (2), R42.P$2 (2), T3.3 (C); also elsewhere on the board
-14V: IC3.4 (V-), IC12.4 (V-), IC15.4 (V-); also elsewhere on the board
-18V: R36.P$1 (1), T4.3 (E); also elsewhere on the board
AGND: C1.1, C2.1, C3.1, C8.1, C10.1, IC3.5 (GND), IC3.6 (S4), IC6.3 (A), IC12.5 (GND), R17.P$2 (2), R44.P$1 (1), RN3.3 (R3A), RN3.EP (SH); also elsewhere on the board
AGND1: IC14.3 (A), R36.P$2 (2), R38.P$1 (1), T4.1 (B)
AMP_OUT: C19.1, IC3.15 (D2), IC15.6 (OUT), RN3.1 (R1A); also elsewhere on the board
GND: C6.2, IC1.8 (GND), IC1.13 (G), IC2.8 (GND), IC2.13 (G); also elsewhere on the board
M1_1: IC12.1 (IN1), R31.P$1 (1)
M1_2: IC12.16 (IN2), R23.P$1 (1)
M1_3: IC12.9 (IN3), R32.P$1 (1)
M1_4: IC12.8 (IN4), R24.P$1 (1)
M2_1: IC3.1 (IN1), R22.P$1 (1)
M2_2: IC3.16 (IN2), R30.P$1 (1)
M2_3: IC3.9 (IN3), R21.P$1 (1)
M2_4: IC3.8 (IN4), R29.P$1 (1)
M3_A: R27.P$1 (1); also elsewhere on the board
M3_B: R25.P$1 (1); also elsewhere on the board
M3_C: R28.P$1 (1); also elsewhere on the board
M3_D: R26.P$1 (1); also elsewhere on the board
unnamed: IC3.7 (D4), IC3.10 (D3), IC12.7 (D4)
unnamed: RN3.5 (R4B), RN3.8 (R1B)
unnamed: C19.2, IC3.2 (D1), RN3.2 (R2A), RN3.4 (R4A)
unnamed: RN3.6 (R3B), RN3.7 (R2B)
unnamed: R3.P$1 (1), R4.P$1 (1)
unnamed: IC12.3 (S1), IC12.6 (S4), IC12.11 (S3), IC12.14 (S2), R33.P$1 (1)
unnamed: R4.P$2 (2), R9.P$2 (2)
unnamed: R9.P$1 (1), R10.P$1 (1)
unnamed: R10.P$2 (2), R11.P$2 (2)
unnamed: R11.P$1 (1), R12.P$1 (1)
unnamed: R12.P$2 (2), R14.P$2 (2)
unnamed: R14.P$1 (1), R16.P$1 (1)
unnamed: R16.P$2 (2), R18.P$2 (2)
unnamed: K4.4, R17.P$1 (1), R18.P$1 (1)
unnamed: K2.1 (S), R3.P$2 (2)
unnamed: IC1.5 (QF), K1.3 (-)
unnamed: R19.P$2 (2), R20.P$2 (2), U$2.1
unnamed: IC1.4 (QE), K2.3 (-)
unnamed: IC1.6 (QG), K3.3 (-)
unnamed: C3.2, R20.P$1 (1), R55.P$2 (2)
unnamed: IC4.3 (+IN), R33.P$2 (2)
unnamed: IC1.7 (QH), K4.3 (-)
unnamed: C1.2, R1.P$1 (1), R5.P$2 (2)
unnamed: IC5.2 (-IN), IC5.6 (OUT), IC13.3 (A), IC14.2 (C), R39.P$1 (1), R40.P$1 (1)
unnamed: C5.2, IC4.8 (OPT)
unnamed: C7.2, IC4.1 (ON1)
unnamed: C2.2, R2.P$1 (1), R6.P$2 (2)
unnamed: IC12.15 (D2), R5.P$1 (1)
unnamed: C8.2, IC5.3 (+IN), R34.P$2 (2)
unnamed: IC12.10 (D3), R6.P$1 (1)
unnamed: IC1.9 (QH*), IC2.14 (SER)
unnamed: IC1.15 (QA), R27.P$2 (2)
unnamed: IC1.1 (QB), R25.P$2 (2)
unnamed: IC1.2 (QC), R28.P$2 (2)
unnamed: IC1.3 (QD), R26.P$2 (2)
unnamed: IC2.15 (QA), R29.P$2 (2)
unnamed: IC2.1 (QB), R21.P$2 (2)
unnamed: IC3.3 (S1), IC3.14 (S2), IC4.2 (-IN), IC15.2 (-IN), R34.P$1 (1)
unnamed: IC2.2 (QC), R30.P$2 (2)
unnamed: IC2.3 (QD), R22.P$2 (2)
unnamed: IC2.4 (QE), R31.P$2 (2)
unnamed: IC12.2 (D1), R55.P$1 (1)
unnamed: IC3.11 (S3), R41.P$1 (1)
unnamed: IC2.7 (QH), R24.P$2 (2)
unnamed: IC2.6 (QG), R32.P$2 (2)
unnamed: IC2.5 (QF), R23.P$2 (2)
unnamed: IC13.2 (C), R35.P$1 (1), R37.P$1 (1), T3.1 (B)
unnamed: IC13.1 (R), R37.P$2 (2), R39.P$2 (2)
unnamed: IC6.1 (R), R43.P$2 (2), R44.P$2 (2)
unnamed: IC14.1 (R), R38.P$2 (2), R40.P$2 (2)
unnamed: K1.1 (S), K4.1 (S), R19.P$1 (1), U$2.2
unnamed: K3.1 (S), R8.P$1 (1), U$1.2
unnamed: IC4.6 (OUT), IC15.3 (+IN)
OHM_CUR: R8.P$2 (2), U$1.1; also elsewhere on the board
SR_CLK: IC1.11 (SCK), IC2.11 (SCK); also elsewhere on the board
SR_DAT: IC1.14 (SER); also elsewhere on the board
SR_LAT: IC1.12 (RCK), IC2.12 (RCK); also elsewhere on the board
T_INP: K1.4, K2.4, K3.4; also elsewhere on the board
T_SENH: R1.P$2 (2); also elsewhere on the board
T_SENL: R2.P$2 (2); also elsewhere on the board
V+: C9.1, IC4.7 (V+), IC5.7 (V+), T3.2 (E)
V-: C5.1, C7.1, C9.2, C10.2, IC4.4 (V-), IC5.4 (V-), T4.2 (C)
VCC: IC3.12 (VL), IC6.2 (C), IC12.12 (VL), R42.P$1 (1), R43.P$1 (1); also elsewhere on the board
VREF-7V: R41.P$2 (2); also elsewhere on the board
V_REL: K1.2 (+), K2.2 (+), K3.2 (+), K4.2 (+); also elsewhere on the board

Notes on the sheet:
LT5400-9k/1k
range switching bootstrapped buffer

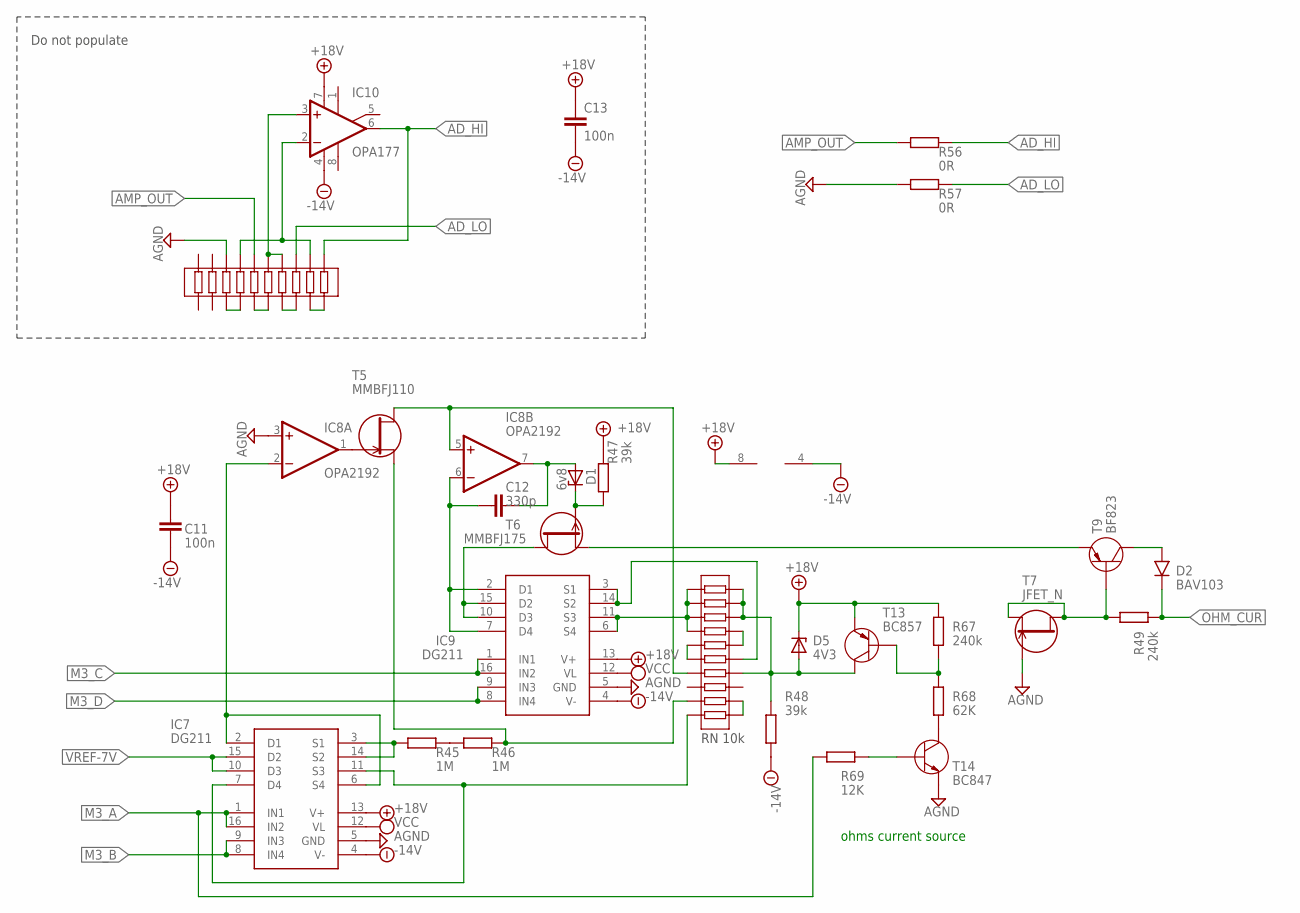
[picture p37: schematic vm_mini_exp5.sch, sheet 3]

Parts:
C11, C13: 100n; R0805
C12: 330p; R_MINIMELF
D1: 6v8; SOD80C
D2: BAV103; SOD-80
D5: 4V3; SOD80C
IC7, IC9: DG211; SO-16
IC8: OPA2192; SO08
IC10: OPA177; SO08
R45, R46: 1M; R_MINIMELF
R47, R48: 39k; R_MINIMELF
R49, R67: 240k; R_MINIMELF
R56, R57: 0R; R_MINIMELF
R68: 62K; R_MINIMELF
R69: 12K; R_MINIMELF
RN1, RN2: OSOP20
T5: MMBFJ110; SOT23
T6: MMBFJ175; SOT23
T7: JFET_N; SOT23
T9: BF823; SOT23
T13: BC857; SOT23
T14: BC847; SOT23

Connections:
+18V: C11.1, C13.1, D5.C, IC7.13 (V+), IC8.8 (V+), IC9.13 (V+), IC10.7 (V+), R47.P$1 (1), R67.P$2 (2), T13.2 (C); also elsewhere on the board
-14V: C11.2, C13.2, IC7.4 (V-), IC8.4 (V-), IC9.4 (V-), IC10.4 (V-), R48.P$1 (1); also elsewhere on the board
AD_HI: IC10.6 (OUT), R56.P$1 (1), RN1.1 (1A); also elsewhere on the board
AD_LO: R57.P$1 (1), RN1.3 (3A); also elsewhere on the board
AGND: IC7.5 (GND), IC8.3 (+IN), IC9.5 (GND), R57.P$2 (2), RN1.8 (8A), T7.3 (G), T14.2 (E); also elsewhere on the board
AMP_OUT: R56.P$2 (2), RN1.6 (6A); also elsewhere on the board
M3_A: IC7.1 (IN1), IC7.16 (IN2), R69.P$1 (1); also elsewhere on the board
M3_B: IC7.8 (IN4), IC7.9 (IN3); also elsewhere on the board
M3_C: IC9.1 (IN1), IC9.16 (IN2); also elsewhere on the board
M3_D: IC9.8 (IN4), IC9.9 (IN3); also elsewhere on the board
unnamed: RN1.19 (2B), RN1.20 (1B)
unnamed: IC8.5 (+IN), RN2.7 (7A), T5.1 (D)
unnamed: RN1.17 (4B), RN1.18 (3B)
unnamed: RN2.5 (5A), RN2.6 (6A)
unnamed: RN2.11 (10B), RN2.12 (9B)
unnamed: IC9.3 (S1), IC9.14 (S2), RN2.15 (6B)
unnamed: C12.P$1 (1), IC8.6 (-IN), IC9.2 (D1), IC9.7 (D4)
unnamed: IC9.6 (S4), IC9.11 (S3), RN2.1 (1A), RN2.2 (2A), RN2.3 (3A), RN2.4 (4A)
unnamed: IC7.3 (S1), IC7.14 (S2), R45.P$1 (1)
unnamed: RN2.16 (5B), RN2.17 (4B)
unnamed: IC8.1 (OUT), T5.3 (G)
unnamed: R46.P$2 (2), RN2.9 (9A), T5.2 (S)
unnamed: IC9.10 (D3), IC9.15 (D2), T6.1 (D)
unnamed: IC7.7 (D4), IC7.11 (S3), RN2.10 (10A)
unnamed: C12.P$2 (2), D1.A, IC8.7 (OUT)
unnamed: R45.P$2 (2), R46.P$1 (1)
unnamed: D1.C, R47.P$2 (2), T6.3 (G)
unnamed: IC7.2 (D1), IC7.6 (S4), IC8.2 (-IN)
unnamed: R49.P$2 (2), T7.1 (D), T7.2 (S), T9.1 (B)
unnamed: RN1.15 (6B), RN1.16 (5B)
unnamed: RN1.13 (8B), RN1.14 (7B)
unnamed: T6.2 (S), T9.2 (C)
unnamed: D2.A, T9.3 (E)
unnamed: IC10.3 (+IN), RN1.4 (4A), RN1.5 (5A)
unnamed: IC10.2 (-IN), RN1.2 (2A), RN1.7 (7A)
unnamed: D5.A, R48.P$2 (2), RN2.14 (7B), RN2.18 (3B), RN2.19 (2B), RN2.20 (1B), T13.3 (E)
unnamed: R67.P$1 (1), R68.P$1 (1), T13.1 (B)
unnamed: R68.P$2 (2), T14.3 (C)
unnamed: R69.P$2 (2), T14.1 (B)
OHM_CUR: D2.K, R49.P$1 (1); also elsewhere on the board
VCC: IC7.12 (VL), IC9.12 (VL); also elsewhere on the board
VREF-7V: IC7.10 (D3), IC7.15 (D2); also elsewhere on the board

Notes on the sheet:
Do not populate
RN 10k
ohms current source

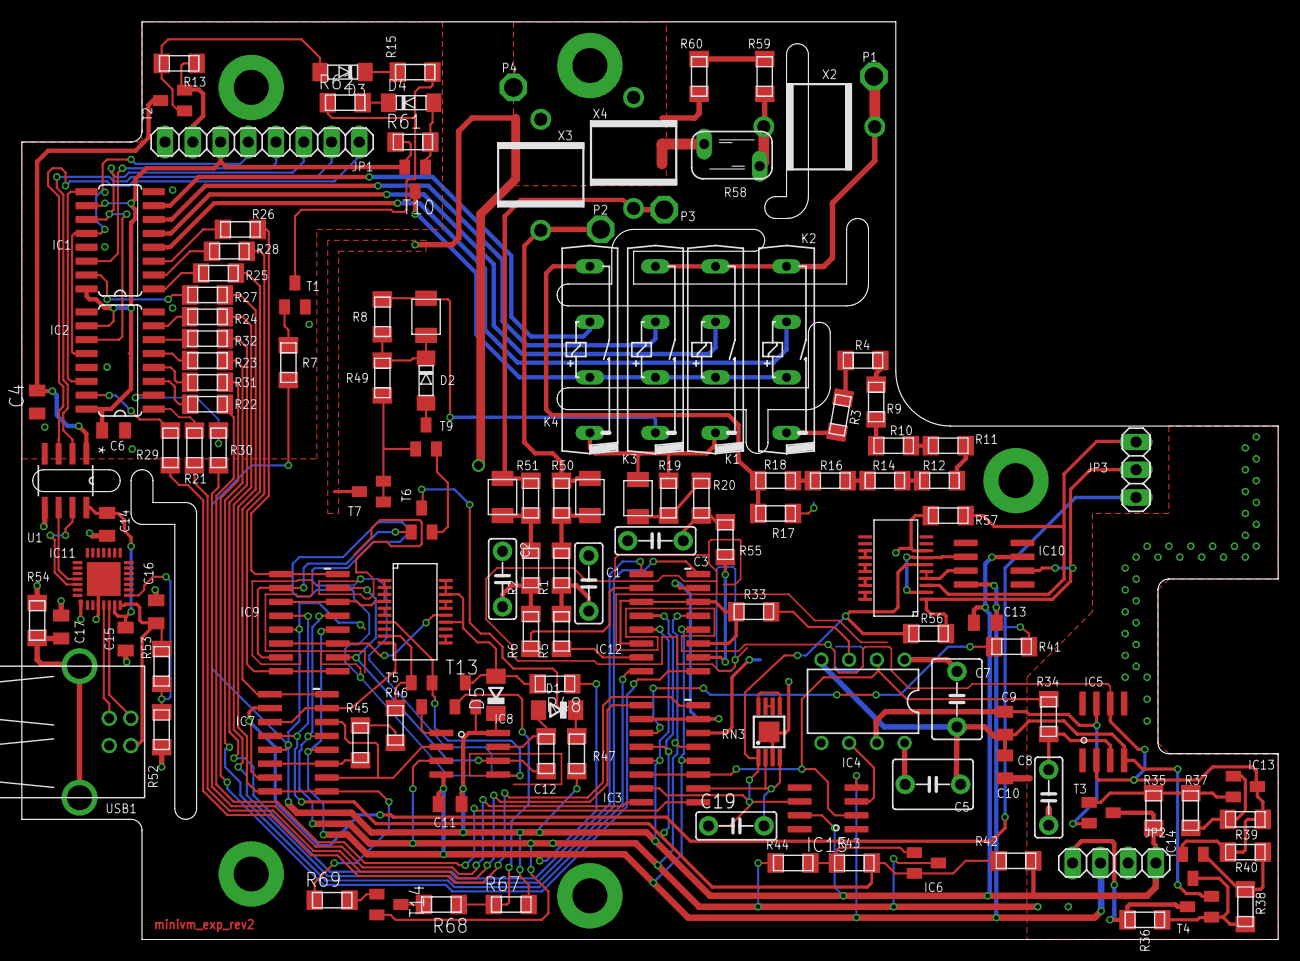
[picture p38: board vm_mini_exp5.brd from above]

Board: 2 copper layers, 115.0 x 84.0 mm, 137 parts (0 on the bottom side), 139 nets.
