mfkiwl/ADC_Test-icd40hx/doc/vm_mini-master/pcb_eagle/vm_mini_main3a.brd

## EAGLE design doc/vm_mini-master/pcb_eagle/vm_mini_main3a.brd (continued)

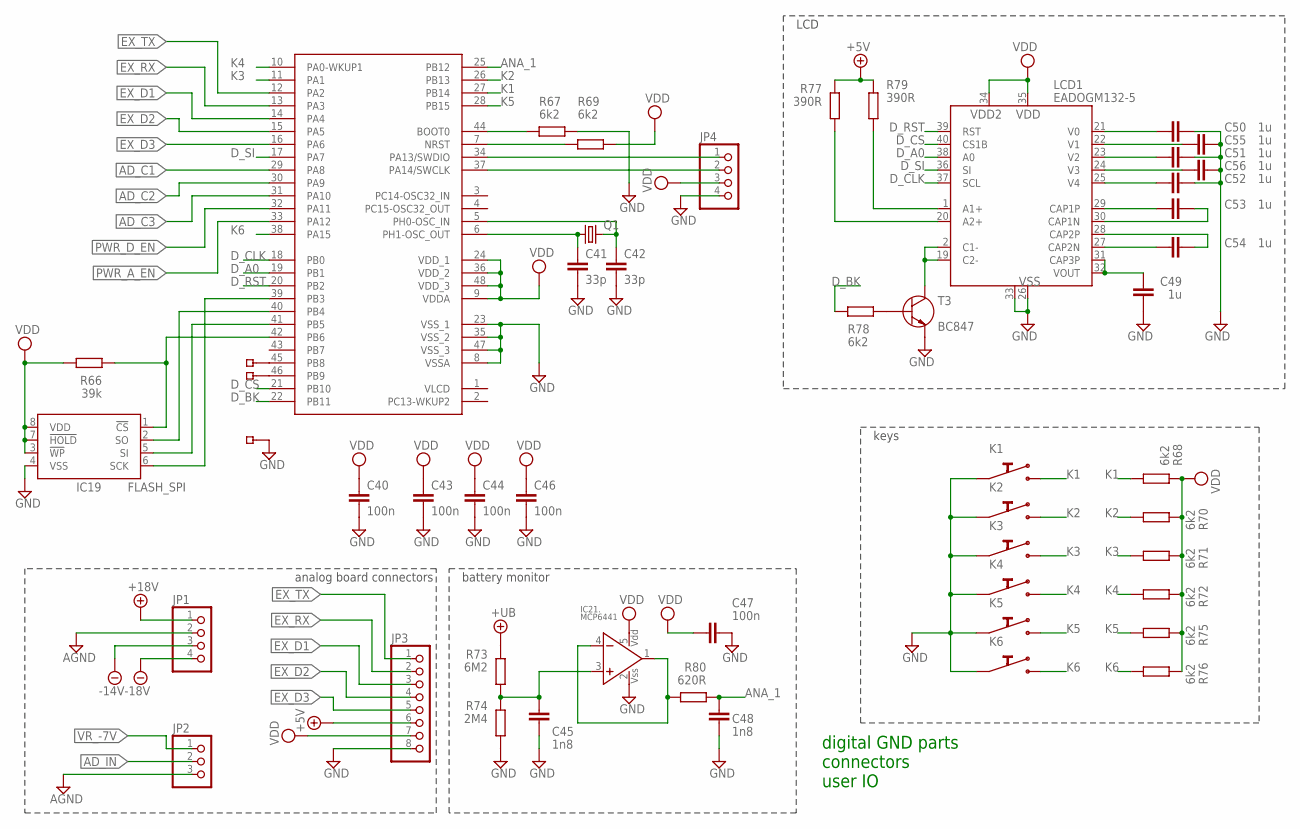
[picture p42: schematic vm_mini_main3a.sch, sheet 4]

Parts:
C40, C43, C44, C46, C47: 100n; R0805
C41, C42: 33p; R0805
C45, C48: 1n8; R_MINIMELF
C49, C50, C51, C52, C53, C54, C55, C56: 1u; R0805
IC19: FLASH_SPI; SO-08
IC20: STM32L152XC_LQFP48; LQFP48
IC21: MCP6441; SOT23-5L
JP1: PINHD-1X04_2.54; 1X04
JP2: PINHD-1X03_2.54; 1X03
JP3: PINHD-1X08_2.54; 1X08
JP4: PINHD-1X04_2.54-90°; 1X04/90
K1, K2, K3, K4, K5, K6: SWITCH_MINI6450; SWITCH_6450
LCD1: EADOGM132-5; EADOGM
Q1: CRYSTALHC49UP; HC49UP
R66: 39k; R_MINIMELF
R67, R68, R69, R70, R71, R72, R75, R76, R78: 6k2; R_MINIMELF
R73: 6M2; R_MINIMELF
R74: 2M4; R_MINIMELF
R77, R79: 390R; R_MINIMELF
R80: 620R; R_MINIMELF
T3: BC847; SOT23
TP18, TP19, TP20: TEST_PADSMD_35X2; TP_SMD_35X2

Connections:
+5V: JP3.6, R77.P$2 (2), R79.P$2 (2); also elsewhere on the board
+18V: JP1.1; also elsewhere on the board
+UB: R73.P$1 (1); also elsewhere on the board
-14V: JP1.3; also elsewhere on the board
-18V: JP1.4; also elsewhere on the board
AD_C1: IC20.29 (PA8); also elsewhere on the board
AD_C2: IC20.30 (PA9); also elsewhere on the board
AD_C3: IC20.31 (PA10); also elsewhere on the board
AD_IN: JP2.2; also elsewhere on the board
AGND: JP1.2, JP2.3; also elsewhere on the board
ANA_1: C48.P$1 (1), IC20.25 (PB12), R80.P$2 (2)
D_A0: IC20.19 (PB1), LCD1.38 (A0)
D_BK: IC20.22 (PB11), R78.P$2 (2)
D_CLK: IC20.18 (PB0), LCD1.37 (SCL)
D_CS: IC20.21 (PB10), LCD1.40 (CS1B)
D_RST: IC20.20 (PB2), LCD1.39 (RST)
D_SI: IC20.17 (PA7), LCD1.36 (SI)
EX_D1: IC20.14 (PA4), JP3.3
EX_D2: IC20.15 (PA5), JP3.4
EX_D3: IC20.16 (PA6), JP3.5
EX_RX: IC20.13 (PA3), JP3.2
EX_TX: IC20.12 (PA2), JP3.1
GND: C40.2, C41.2, C42.2, C43.2, C44.2, C45.P$2 (2), C46.2, C47.2, C48.P$2 (2), C49.2, C50.2, C51.2, C52.2, C55.2, C56.2, IC19.4 (VSS), IC20.8 (VSSA), IC20.23 (VSS_1), IC20.35 (VSS_2), IC20.47 (VSS_3), IC21.2 (VSS), JP3.8, JP4.4, K1.P$1, K2.P$1, K3.P$1, K4.P$1, K5.P$1, K6.P$1, LCD1.26 (VSS), LCD1.33 (VSS1), R67.P$2 (2), R74.P$2 (2), T3.2 (E), TP20.P$1; also elsewhere on the board
K1: IC20.27 (PB14), K1.P$2, R68.P$1 (1)
K2: IC20.26 (PB13), K2.P$2, R70.P$1 (1)
K3: IC20.11 (PA1), K3.P$2, R71.P$1 (1)
K4: IC20.10 (PA0-WKUP1), K4.P$2, R72.P$1 (1)
K5: IC20.28 (PB15), K5.P$2, R75.P$1 (1)
K6: IC20.38 (PA15), K6.P$2, R76.P$1 (1)
unnamed: LCD1.1 (A1+), R79.P$1 (1)
unnamed: LCD1.20 (A2+), R77.P$1 (1)
unnamed: LCD1.2 (C1-), LCD1.19 (C2-), T3.3 (C)
unnamed: R78.P$1 (1), T3.1 (B)
unnamed: C50.1, LCD1.21 (V0)
unnamed: C55.1, LCD1.22 (V1)
unnamed: C51.1, LCD1.23 (V2)
unnamed: C56.1, LCD1.24 (V3)
unnamed: C52.1, LCD1.25 (V4)
unnamed: C53.1, LCD1.29 (CAP1P)
unnamed: C53.2, LCD1.30 (CAP1N)
unnamed: C54.2, LCD1.28 (CAP2P)
unnamed: C54.1, LCD1.27 (CAP2N)
unnamed: C49.1, LCD1.31 (CAP3P), LCD1.32 (VOUT)
unnamed: IC20.34 (PA13/SWDIO), JP4.1
unnamed: IC20.37 (PA14/SWCLK), JP4.2
unnamed: C41.1, IC20.6 (PH1-OSC_OUT), Q1.1
unnamed: C42.1, IC20.5 (PH0-OSC_IN), Q1.2
unnamed: IC20.44 (BOOT0), R67.P$1 (1)
unnamed: IC20.7 (NRST), R69.P$1 (1)
unnamed: C45.P$1 (1), IC21.3 (NEIN+), R73.P$2 (2), R74.P$1 (1)
unnamed: IC19.6 (SCK), IC20.39 (PB3)
unnamed: IC21.1 (VYSTUP), IC21.4 (IN-), R80.P$1 (1)
unnamed: IC19.2 (SO), IC20.40 (PB4)
unnamed: IC19.5 (SI), IC20.41 (PB5)
unnamed: IC19.1 (!CS), IC20.42 (PB6), R66.P$2 (2)
unnamed: IC20.45 (PB8), TP18.P$1
unnamed: IC20.46 (PB9), TP19.P$1
PWR_A_EN: IC20.33 (PA12); also elsewhere on the board
PWR_D_EN: IC20.32 (PA11); also elsewhere on the board
VDD: C40.1, C43.1, C44.1, C46.1, C47.1, IC19.3 (!WP), IC19.7 (!HOLD), IC19.8 (VDD), IC20.9 (VDDA), IC20.24 (VDD_1), IC20.36 (VDD_2), IC20.48 (VDD_3), IC21.5 (VDD), JP3.7, JP4.3, LCD1.34 (VDD2), LCD1.35 (VDD), R66.P$1 (1), R68.P$2 (2), R69.P$2 (2), R70.P$2 (2), R71.P$2 (2), R72.P$2 (2), R75.P$2 (2), R76.P$2 (2); also elsewhere on the board
VR_-7V: JP2.1; also elsewhere on the board

Notes on the sheet:
digital GND parts connectors user IO
battery monitor
analog board connectors
keys
LCD

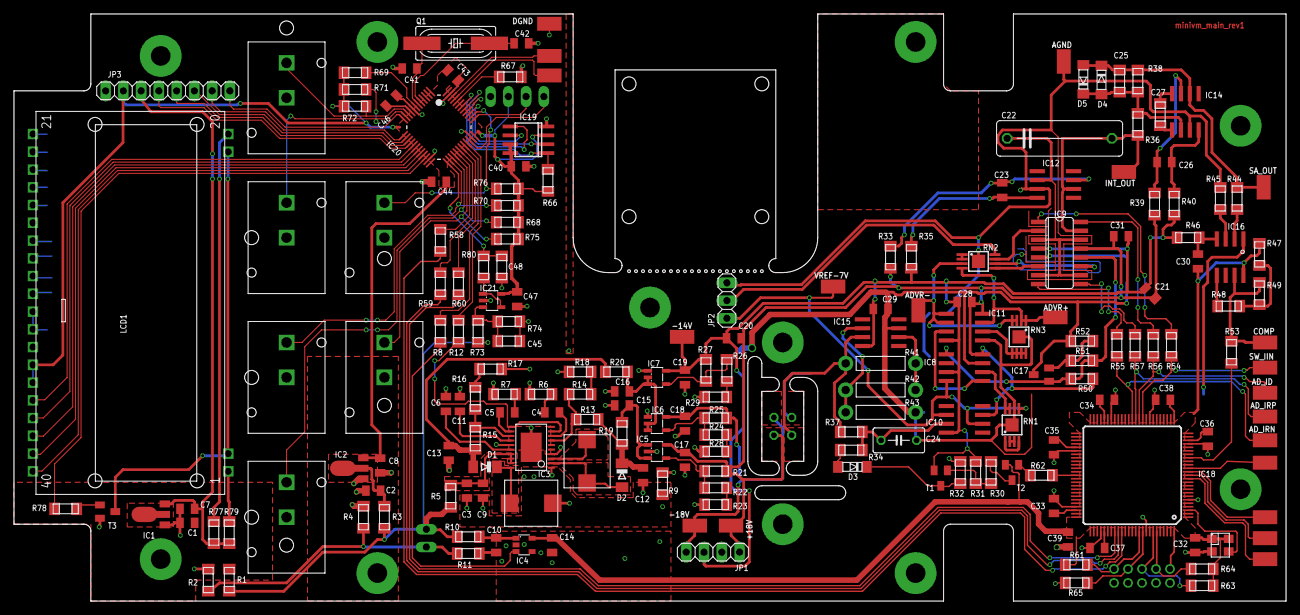
[picture p43: board vm_mini_main3a.brd from above]

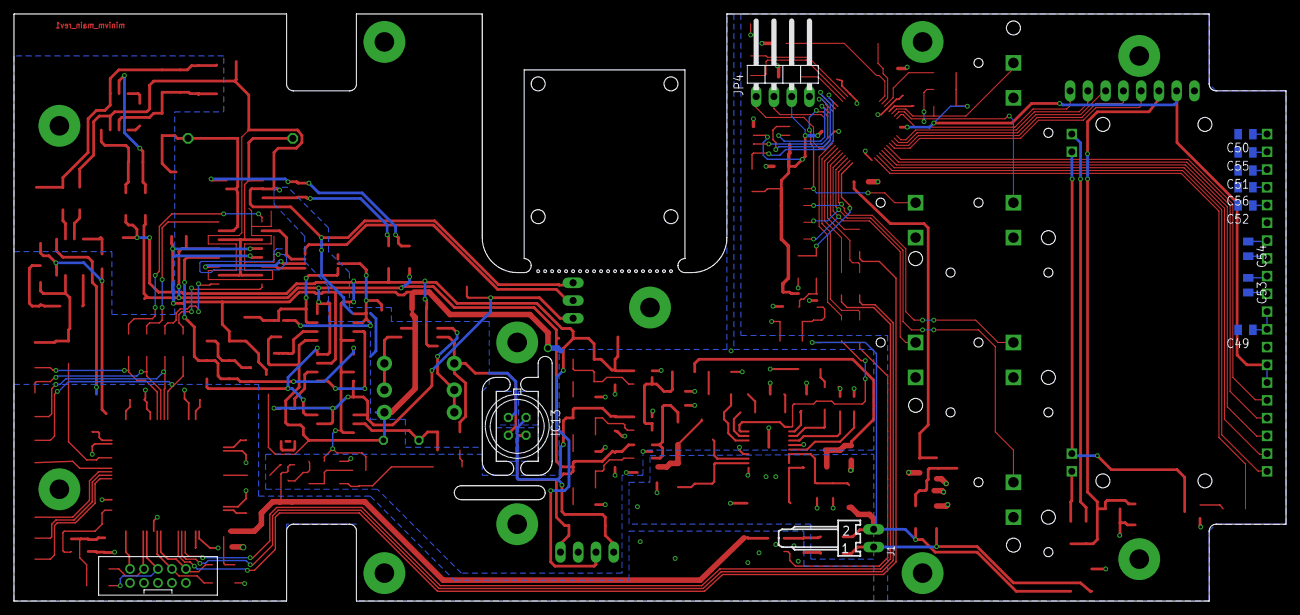
[picture p44: board vm_mini_main3a.brd from below]

Board: 2 copper layers, 182.0 x 84.0 mm, 206 parts (12 on the bottom side), 153 nets.
