mfkiwl/ADC_Test-icd40hx/software/MCU/Core/Src/main.c

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
/* Includes ------------------------------------------------------------------*/
#include "main.h"
#include "cmsis_os.h"
#include "lwip.h"
#include "bsp_ee24.h"


I2C_HandleTypeDef hi2c4;

SPI_HandleTypeDef hspi3;

UART_HandleTypeDef huart2;

/* Definitions for defaultTask */
osThreadId_t defaultTaskHandle;
const osThreadAttr_t defaultTask_attributes = {
  .name = "defaultTask",
  .priority = (osPriority_t) osPriorityNormal,
  .stack_size = 256 * 4
};
/* Definitions for myTaskLED */
osThreadId_t myTaskLEDHandle;
const osThreadAttr_t myTaskLED_attributes = {
  .name = "myTaskLED",
  .priority = (osPriority_t) osPriorityLow,
  .stack_size = 256 * 4
};
/* Definitions for LogData */
osThreadId_t LogDataHandle;
const osThreadAttr_t LogData_attributes = {
  .name = "LogData",
  .priority = (osPriority_t) osPriorityLow,
  .stack_size = 256 * 4
};
/* USER CODE BEGIN PV */

uint8_t rx_data[6] = {0x00};
uint8_t it_array_mul[10]={1, 1, 1, 1, 2, 5, 10, 0};
double it_array_refcor[3]={1, 1.01582, 1};
uint32_t count_fail= 0;
uint8_t new_data = 0;
struct cfg_struct dmm;


/* USER CODE END PV */

void SystemClock_Config(void);
static void MX_GPIO_Init(void);
static void MX_I2C4_Init(void);
static void MX_SPI3_Init(void);
static void MX_USART2_UART_Init(void);
void StartDefaultTask(void *argument);
void StartTaskLED(void *argument);
void StartTaskLogData(void *argument);
void DMM_Init();
/**
  * @brief  The application entry point.
  * @retval int
  */
int main(void)
{
  /* MCU Configuration--------------------------------------------------------*/

  /* Reset of all peripherals, Initializes the Flash interface and the Systick. */
  HAL_Init();

  /* Configure the system clock */
  SystemClock_Config();

  /* Initialize all configured peripherals */
  MX_GPIO_Init();
  MX_I2C4_Init();
  MX_SPI3_Init();
  MX_USART2_UART_Init();
  /* USER CODE BEGIN 2 */

  MX_LWIP_Init();
  DMM_Init();

  /* USER CODE END 2 */

  /* Init scheduler */
  osKernelInitialize();

  /* USER CODE BEGIN RTOS_MUTEX */
  /* add mutexes, ... */
  /* USER CODE END RTOS_MUTEX */

  /* USER CODE BEGIN RTOS_SEMAPHORES */
  /* add semaphores, ... */
  /* USER CODE END RTOS_SEMAPHORES */

  /* USER CODE BEGIN RTOS_TIMERS */
  /* start timers, add new ones, ... */
  /* USER CODE END RTOS_TIMERS */

  /* USER CODE BEGIN RTOS_QUEUES */
  /* add queues, ... */
  /* USER CODE END RTOS_QUEUES */

  /* Create the thread(s) */
  /* creation of defaultTask */
  //defaultTaskHandle = osThreadNew(StartDefaultTask, NULL, &defaultTask_attributes);

  /* creation of myTaskLED */
  myTaskLEDHandle = osThreadNew(StartTaskLED, NULL, &myTaskLED_attributes);

  /* creation of LogData */
 // LogDataHandle = osThreadNew(StartTaskLogData, NULL, &LogData_attributes);

  /* USER CODE BEGIN RTOS_THREADS */

  scpi_server_init();

  /* USER CODE END RTOS_THREADS */

  /* Start scheduler */
  osKernelStart();

  /* We should never get here as control is now taken by the scheduler */
  /* Infinite loop */
  /* USER CODE BEGIN WHILE */
  while (1)
  {
    /* USER CODE END WHILE */

    /* USER CODE BEGIN 3 */

  }
  /* USER CODE END 3 */
}

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
/* USER CODE BEGIN 4 */

BSP_StatusTypeDef eeprom_status()
{
	uint8_t rx_data = 0;

	if(ee24_isConnected())
	{
		if(ee24_read(EEPROM_END, &rx_data, 1, 1000))
		{
			if(EEPROM_WRITE_DONE == rx_data)
			{
				return BSP_OK;
			}
			else
			{
				return BSP_EEPROM_EMPTY;
			}

		}
		else
		{
			return BSP_EEPROM_READ_ERROR;
		}

	}
	else
	{
		return BSP_EEPROM_NO_CONNECTION;
	}
}

BSP_StatusTypeDef eeprom_read(uint8_t* data, size_t size)
{

	if(ee24_isConnected())
	{
		if(ee24_read(0, data, size, 1000))
		{
			return BSP_OK;
		}
		else
		{
			return BSP_EEPROM_READ_ERROR;
		}

	}
	else
	{
		return BSP_EEPROM_NO_CONNECTION;
	}
}

BSP_StatusTypeDef eeprom_write(uint8_t* data, size_t size)
{
	uint8_t tx_data[1] = {EEPROM_WRITE_DONE};

	if(ee24_isConnected())
	{
		if(ee24_write(0, data, size, 1000))
		{
			if(ee24_write(EEPROM_END, &tx_data, 1, 1000))
			{
				return BSP_OK;
			}
			else
			{
				return BSP_EEPROM_WRITE_ERROR;
			}

		}
		else
		{
			return BSP_EEPROM_WRITE_ERROR;
		}

	}
	else
	{
		return BSP_EEPROM_NO_CONNECTION;
	}
}

void DMM_Init()
{
	BSP_StatusTypeDef status;
	status = eeprom_status();

	if(BSP_EEPROM_EMPTY == status)
	{

	 dmm.calibration.structure.adc_step = CAL_PREDEF_STEP;
	 dmm.calibration.structure.adc_z_offset = CAL_PREDEF_NZO;
	 dmm.calibration.structure.v_1V_offset = CAL_PREDEF_1VO;
	 dmm.calibration.structure.v_1V_gain = CAL_PREDEF_1VG;
	 dmm.calibration.structure.v_10V_offset = CAL_PREDEF_10VO;
	 dmm.calibration.structure.v_10V_gain = CAL_PREDEF_10VG;
	 dmm.calibration.structure.v_100V_offset = CAL_PREDEF_100VO;
	 dmm.calibration.structure.v_100V_gain = CAL_PREDEF_100VG;

	 dmm.adc_cf[0] = 1.000145;
	 dmm.adc_cf[1] = 1.000060;
	 dmm.adc_cf[2] = 1.000015;
	 dmm.adc_cf[3] = 1.0;
	 dmm.adc_cf[4] = 1.0;
	 dmm.adc_cf[5] = 1.0;
	 dmm.adc_cf[6] = 1.0;

	 dmm.adc_raw[0] = 1;
	 dmm.adc_raw[1] = 2;
	 dmm.adc_raw[2] = 5;
	 dmm.adc_raw[3] = 10;
	 dmm.adc_raw[4] = 10;
	 dmm.adc_raw[5] = 10;
	 dmm.adc_raw[6] = 10;

	 dmm.adc_nplc[0] = 1;
	 dmm.adc_nplc[1] = 2;
	 dmm.adc_nplc[2] = 5;
	 dmm.adc_nplc[3] = 10;
	 dmm.adc_nplc[4] = 20;
	 dmm.adc_nplc[5] = 50;
	 dmm.adc_nplc[6] = 100;

	 dmm.nplc = 10;
	 dmm.range = 100;
	 dmm.range_index = 2;
	 dmm.nplc_index = 3;
	 dmm.samples = 1;
	 dmm.zero_val = 0;
	 dmm.zero_done = 0;
	 dmm.zero_status = ZERO_ON;

	}
	else if(BSP_OK == status)
	{
		eeprom_read(dmm.calibration.bytes, STRUCT_SIZE);
	}

	meas_path(dmm.range, NORM_MEAS);

	HAL_GPIO_WritePin(FPGA_IO1_GPIO_Port, FPGA_IO1_Pin, 1);

}

/* USER CODE END 4 */

/* USER CODE BEGIN Header_StartDefaultTask */
/**
  * @brief  Function implementing the defaultTask thread.
  * @param  argument: Not used 
  * @retval None
  */
/* USER CODE END Header_StartDefaultTask */
void StartDefaultTask(void *argument)
{
  /* init code for LWIP */
  MX_LWIP_Init();
  /* USER CODE BEGIN 5 */

  /* Infinite loop */
  for(;;)
  {
	   // osThreadTerminate(NULL);
  }
  /* USER CODE END 5 */
}

/* USER CODE BEGIN Header_StartTaskLED */
/**
* @brief Function implementing the myTaskLED thread.
* @param argument: Not used
* @retval None
*/
/* USER CODE END Header_StartTaskLED */
void StartTaskLED(void *argument)
{
  /* USER CODE BEGIN StartTaskLED */
  /* Infinite loop */
  for(;;)
  {
	 HAL_GPIO_TogglePin(LED_BLUE_GPIO_Port, LED_BLUE_Pin);
	 osDelay(pdMS_TO_TICKS(1000));
  }
  /* USER CODE END StartTaskLED */
}

/* USER CODE BEGIN Header_StartTaskLogData */
/**
* @brief Function implementing the LogData thread.
* @param argument: Not used
* @retval None
*/
/* USER CODE END Header_StartTaskLogData */
void StartTaskLogData(void *argument)
{
  /* USER CODE BEGIN StartTaskLogData */
  /* Infinite loop */
  for(;;)
  {
	  HAL_UART_Init(&huart2);
	  if(HAL_OK ==HAL_UART_Receive(&huart2, (uint8_t *)rx_data, 6, 600))
	  {
		  HAL_GPIO_TogglePin(LED_GREEN_GPIO_Port, LED_GREEN_Pin);
		  new_data = 1;
	  }
	  else
	  {
		  HAL_GPIO_TogglePin(LED_RED_GPIO_Port, LED_RED_Pin);
		  count_fail++;
	  }
	  HAL_UART_DeInit(&huart2);
	  osDelay(pdMS_TO_TICKS(5));
  }
  /* USER CODE END StartTaskLogData */
}

/**
  * @brief  Period elapsed callback in non blocking mode
  * @note   This function is called  when TIM1 interrupt took place, inside
  * HAL_TIM_IRQHandler(). It makes a direct call to HAL_IncTick() to increment
  * a global variable "uwTick" used as application time base.
  * @param  htim : TIM handle
  * @retval None
  */
void HAL_TIM_PeriodElapsedCallback(TIM_HandleTypeDef *htim)
{
  if (htim->Instance == TIM1) {
    HAL_IncTick();
  }
}

/**
  * @brief  This function is executed in case of error occurrence.
  * @retval None
  */
void Error_Handler(void)
{
  /* USER CODE BEGIN Error_Handler_Debug */
  /* User can add his own implementation to report the HAL error return state */

  /* USER CODE END Error_Handler_Debug */
}

#ifdef  USE_FULL_ASSERT
/**
  * @brief  Reports the name of the source file and the source line number
  *         where the assert_param error has occurred.
  * @param  file: pointer to the source file name
  * @param  line: assert_param error line source number
  * @retval None
  */
void assert_failed(uint8_t *file, uint32_t line)
{
  /* USER CODE BEGIN 6 */
  /* User can add his own implementation to report the file name and line number,
     tex: printf("Wrong parameters value: file %s on line %d\r\n", file, line) */
  /* USER CODE END 6 */
}
#endif /* USE_FULL_ASSERT */

/************************ (C) COPYRIGHT STMicroelectronics *****END OF FILE****/
