mfkiwl/ADC_Test-icd40hx/software/MCU/Core/Inc/main.h

#define LED_RED_Pin GPIO_PIN_2
#define LED_RED_GPIO_Port GPIOE
#define LED_GREEN_Pin GPIO_PIN_3
#define LED_GREEN_GPIO_Port GPIOE
#define LED_BLUE_Pin GPIO_PIN_4
#define LED_BLUE_GPIO_Port GPIOE
#define SR_LAT_Pin GPIO_PIN_15
#define SR_LAT_GPIO_Port GPIOB
#define EEPROM_WP_Pin GPIO_PIN_11
#define EEPROM_WP_GPIO_Port GPIOD
#define EEPROM_SCL_Pin GPIO_PIN_12
#define EEPROM_SCL_GPIO_Port GPIOD
#define EEPROM_SDA_Pin GPIO_PIN_13
#define EEPROM_SDA_GPIO_Port GPIOD
#define SR_CLK_Pin GPIO_PIN_15
#define SR_CLK_GPIO_Port GPIOD
#define SR_DAT_Pin GPIO_PIN_7
#define SR_DAT_GPIO_Port GPIOG
#define SP3_NSS_Pin GPIO_PIN_15
#define SP3_NSS_GPIO_Port GPIOA
#define FPGA_IO3_Pin GPIO_PIN_1
#define FPGA_IO3_GPIO_Port GPIOD
#define FPGA_IO4_Pin GPIO_PIN_2
#define FPGA_IO4_GPIO_Port GPIOD
#define FPGA_IO1_Pin GPIO_PIN_3
#define FPGA_IO1_GPIO_Port GPIOD
#define FPGA_IO2_Pin GPIO_PIN_4
#define FPGA_IO2_GPIO_Port GPIOD
#define STRUCT_SIZE 72
