mfkiwl/ADC_Test-icd40hx/software/MCU/Core/Src/scpi_def.c

/*-
 * Copyright (c) 2012-2013 Jan Breuer,
 *
 * All Rights Reserved
 *
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
 * THIS SOFTWARE IS PROVIDED BY THE AUTHORS ``AS IS'' AND ANY EXPRESS OR
 * IMPLIED WARRANTIES, INCLUDING, BUT NOT LIMITED TO, THE IMPLIED
 * WARRANTIES OF MERCHANTABILITY AND FITNESS FOR A PARTICULAR PURPOSE ARE
 * DISCLAIMED. IN NO EVENT SHALL THE AUTHORS OR CONTRIBUTORS BE LIABLE
 * FOR ANY DIRECT, INDIRECT, INCIDENTAL, SPECIAL, EXEMPLARY, OR
 * CONSEQUENTIAL DAMAGES (INCLUDING, BUT NOT LIMITED TO, PROCUREMENT OF
 * SUBSTITUTE GOODS OR SERVICES; LOSS OF USE, DATA, OR PROFITS; OR
 * BUSINESS INTERRUPTION) HOWEVER CAUSED AND ON ANY THEORY OF LIABILITY,
 * WHETHER IN CONTRACT, STRICT LIABILITY, OR TORT (INCLUDING NEGLIGENCE
 * OR OTHERWISE) ARISING IN ANY WAY OUT OF THE USE OF THIS SOFTWARE, EVEN
 * IF ADVISED OF THE POSSIBILITY OF SUCH DAMAGE.
 */

/**
 * @file   scpi-def.c
 * @date   Thu Nov 15 10:58:45 UTC 2012
 *
 * @brief  SCPI parser test
 *
 *
 */

#include <stdio.h>
#include <stdlib.h>
#include <string.h>

#include "scpi_def.h"
#include "scpi/scpi.h"
#include "main.h"
#include "cmsis_os.h"
#include "bsp_74hc595.h"
#include "ee24Config.h"

extern uint8_t log_status;
extern uint8_t rx_data[6];
extern unsigned char  shiftRegisters[2];
extern struct cfg_struct dmm;
extern uint8_t new_data;

extern osThreadId_t LogDataHandle;

extern UART_HandleTypeDef huart2;

scpi_choice_def_t boolean_select[] =
{
    {"OFF", 0},
    {"ON", 1},
	{"0", 0},
	{"1", 1},
    SCPI_CHOICE_LIST_END
};

scpi_choice_def_t auto_zero_select[] =
{
    {"OFF", 0},
    {"ON", 1},
	{"ONCE", 2},
	SCPI_CHOICE_LIST_END
};

extern uint8_t valid_data;

double get_voltage(uint8_t* adc_array, uint8_t it_adc, double cf)
{
  int64_t tmp1,tmp2;
  uint16_t adc_up, adc_total, adc_rundown;
  uint8_t adc_x;
  double retval;
  adc_up = (((uint16_t)(adc_array[0]))<<8)+(((uint16_t)(adc_array[1]))<<0);
  adc_total = (((uint16_t)(adc_array[2]&0x0F))<<8)+(((uint16_t)(adc_array[3]))<<0);
  adc_rundown = (((uint16_t)(adc_array[4]))<<8)+(((uint16_t)(adc_array[5]))<<0);
  adc_x = (adc_array[2]&0x80)>>7;

  if (adc_x==1)
  {
	  tmp1 = adc_rundown+(dmm.calibration.structure.adc_z_offset);
  }
  else
  {
	  tmp1 = -adc_rundown;
  }

  tmp2 = (adc_total+1)/2;
  tmp2 = tmp2-adc_up;
  tmp2 = tmp2*dmm.calibration.structure.adc_step;
  tmp2 = tmp2 - tmp1;
  retval = tmp2;							//tmp2 now holds ADC counts
  retval = retval/338.10;					//roughly map ADC counts to voltage
  retval = retval/((double)(it_adc));		//correction to integration time
  retval = retval / cf;
  return retval;
}


void meas_path(uint8_t range, uint8_t mode)
{
	shiftRegisters[0] = 0;
	shiftRegisters[1] = 0;
	ShiftRegister74HC595_update();

	if(AUTO_ZERO == mode)
	{
		switch(range)
		{
			case 1:   shiftRegisters[0] = 0; shiftRegisters[1] = SR_M14 | SR_M24 | SR_M21; break;
			case 10:  shiftRegisters[0] = 0; shiftRegisters[1] = SR_M14 | SR_M24 | SR_M22; break;
			case 100: shiftRegisters[0] = 0; shiftRegisters[1] = SR_M14 | SR_M24 | SR_M22; break;
		}
	}
	else if(NORM_MEAS == mode)
	{
		switch(range)
		{
			case 1:   shiftRegisters[0] = SR_K1; shiftRegisters[1] = SR_M11 | SR_M24 | SR_M21; break;
			case 10:  shiftRegisters[0] = SR_K1; shiftRegisters[1] = SR_M11 | SR_M24 | SR_M22; break;
			case 100: shiftRegisters[0] = SR_K2 | SR_K4; shiftRegisters[1] = SR_M11 | SR_M24 | SR_M22; break;
		}
	}
	else if(ADC_MEAS == mode)
	{
		switch(range)
		{
			case 1:   shiftRegisters[0] = 0; shiftRegisters[1] = SR_M14 | SR_M23 | SR_M21; break;
			case 10:  shiftRegisters[0] = 0; shiftRegisters[1] = SR_M14 | SR_M23 | SR_M22; break;
			case 100: shiftRegisters[0] = 0; shiftRegisters[1] = SR_M14 | SR_M23 | SR_M22; break;
		}
	}

	ShiftRegister74HC595_update();

}


double get_measure(uint8_t adc_it, double adc_cf, uint8_t nplc)
{
	double sum = 0.0;
	double result = 0.0;
	uint8_t loop_max = 10;

	if(nplc > 3)
	{
		for(uint32_t x = 0; x < loop_max; x++)
		{
			HAL_UART_Init(&huart2);
			HAL_UART_Receive(&huart2, (uint8_t *)rx_data, 6, 400);
			HAL_UART_DeInit(&huart2);
			sum+= get_voltage(rx_data, adc_it, adc_cf);

		}

		result = sum/(double)loop_max;
	}
	else
	{
		HAL_UART_Init(&huart2);
		HAL_UART_Receive(&huart2, (uint8_t *)rx_data, 6, 400);
		HAL_UART_DeInit(&huart2);
		result = get_voltage(rx_data, adc_it, adc_cf);

	}

	return result;
}

static scpi_result_t SCPI_ConfigureVoltageDC(scpi_t * context)
{
	scpi_number_t param_range;
	uint8_t valid_ranges[4] = {1, 10, 100};
	uint8_t is_valid = 0;

	if(!SCPI_ParamNumber(context, scpi_special_numbers_def, &param_range, TRUE)){
		return SCPI_RES_ERR;
	}

		if(param_range.special){
			switch(param_range.content.tag)	{
			case SCPI_NUM_MIN: dmm.range = 1; break;
			case SCPI_NUM_MAX: dmm.range = 100; break;
			case SCPI_NUM_DEF: dmm.range = 100; break;
			default: SCPI_ErrorPush(context, SCPI_ERROR_ILLEGAL_PARAMETER_VALUE); return SCPI_RES_ERR;
			}
		}
		else{
			if((SCPI_UNIT_VOLT == param_range.unit) || (SCPI_UNIT_NONE == param_range.unit)){
				for(uint8_t i = 0; i < 3; i++){
					if(valid_ranges[i] == param_range.content.value){
						dmm.range = param_range.content.value;
						is_valid = 1;
						break;
					}
					else{
						is_valid = 0;
					}
				}

				if(is_valid){

				}
				else{
					SCPI_ErrorPush(context, SCPI_ERROR_DATA_OUT_OF_RANGE);
					return SCPI_RES_ERR;
				}
			}
			else{
				SCPI_ErrorPush(context, SCPI_ERROR_INVALID_SUFFIX);
				return SCPI_RES_ERR;
			}
		}

		switch(dmm.range)
		{
		case 1:   dmm.range_index = 0; break;
		case 10:  dmm.range_index = 1; break;
		case 100: dmm.range_index = 2;break;
		}

		meas_path(dmm.range, NORM_MEAS);
		dmm.zero_done = 0;

	return SCPI_RES_OK;
}

static scpi_result_t SCPI_ConfigureVoltageDCQ(scpi_t * context)
{
	SCPI_ResultInt32(context, dmm.range);

}

double auto_zero()
{
	double adc_nz = 0.0;

	meas_path(dmm.range, AUTO_ZERO);
	osDelay(pdMS_TO_TICKS(400));

	adc_nz = get_measure(dmm.range, dmm.adc_cf[dmm.nplc_index], dmm.nplc_index);
/*
	switch (dmm.range)
	{
		case 1:{
			adc_nz = adc_nz/(double)100000;
			adc_nz = adc_nz + dmm.calibration.structure.v_1V_offset;
			adc_nz = adc_nz * dmm.calibration.structure.v_1V_gain;
		}break;
		case 10:{
			adc_nz = adc_nz/(double)1000;
			adc_nz = adc_nz + dmm.calibration.structure.v_10V_offset;
			adc_nz = adc_nz * dmm.calibration.structure.v_10V_gain;

		}break;
		case 100:{
			adc_nz = adc_nz/(double)10;
			adc_nz = adc_nz + dmm.calibration.structure.v_100V_offset;
			adc_nz = adc_nz * dmm.calibration.structure.v_100V_gain;
		}break;
	}
*/
	adc_nz = (-1.0)*adc_nz;
	adc_nz = adc_nz/1000;

	meas_path(dmm.range, NORM_MEAS);
	osDelay(pdMS_TO_TICKS(400));

	return adc_nz;
}

static scpi_result_t SCPI_MeasureVoltageDCQ(scpi_t * context)
{
	double adc_in = 0.0;
	float results[1000] = {0.0};
	uint32_t index = 0;
	uint32_t samples = dmm.samples;



	if((ZERO_ONCE == dmm.zero_status) && (!dmm.zero_done))
	{
		dmm.zero_val = auto_zero();
		dmm.zero_done = 1;
	}

	while(samples--)
	{
		if(ZERO_ON == dmm.zero_status)
		{
			dmm.zero_val = auto_zero();
		}
		else if (ZERO_OFF == dmm.zero_status)
		{
			dmm.zero_val = 0.0;
		}

		adc_in = get_measure(dmm.range, dmm.adc_cf[dmm.nplc_index], dmm.nplc_index);
		adc_in = adc_in/1000;
		adc_in = adc_in + dmm.zero_val;

		switch (dmm.range)
		{
		case 1:{
			adc_in = adc_in/(double)100;
			adc_in = adc_in + dmm.calibration.structure.v_1V_offset;
			adc_in = adc_in * dmm.calibration.structure.v_1V_gain;
			//adc_in = adc_in + dmm.zero_val;

		}break;
		case 10:{
				adc_in = adc_in*(double)1.0;
				adc_in = adc_in + dmm.calibration.structure.v_10V_offset;
				adc_in = adc_in * dmm.calibration.structure.v_10V_gain;
				//adc_in = adc_in + dmm.zero_val;
			}break;
		case 100:{
				adc_in = adc_in*(double)100;
				adc_in = adc_in + dmm.calibration.structure.v_100V_offset;
				adc_in = adc_in * dmm.calibration.structure.v_100V_gain;
				//adc_in = adc_in + dmm.zero_val;

			}break;

		}

		results[index] = adc_in;
		index++;
	}

	SCPI_ResultArrayFloat(context, results, dmm.samples, SCPI_FORMAT_ASCII);


	return SCPI_RES_OK;
}

static scpi_result_t SCPI_SampleCount(scpi_t * context)
{

	int32_t value;
	if(!SCPI_ParamInt32(context, &value, TRUE)){
		return SCPI_RES_ERR;
	}

	dmm.samples = value;

	return SCPI_RES_OK;
}

static scpi_result_t SCPI_SampleCountQ(scpi_t * context)
{
	SCPI_ResultInt32(context, dmm.samples);
	return SCPI_RES_OK;
}


void set_nplc(uint8_t index)
{
	uint8_t tx_data[1] = {0x00};
	tx_data[0] = 0x50 + (dmm.adc_raw[index] - 1);

	osThreadSuspend(LogDataHandle);

	HAL_GPIO_WritePin(FPGA_IO1_GPIO_Port, FPGA_IO1_Pin, 0);

	HAL_UART_Init(&huart2);

	HAL_UART_Transmit(&huart2, tx_data, 1, 300);
	HAL_UART_DeInit(&huart2);

	HAL_GPIO_WritePin(FPGA_IO1_GPIO_Port, FPGA_IO1_Pin, 1);

	osThreadResume(LogDataHandle);
}

static scpi_result_t SCPI_ConfigureVoltageDCNPLC(scpi_t * context)
{
	uint8_t is_valid = 0;
	int32_t nplc = 0;


	if(!SCPI_ParamInt32(context, &nplc, TRUE))
	{
			return SCPI_RES_ERR;
	}

	for(uint8_t x = 0; x < 7; x++)
	{
		if(dmm.adc_nplc[x] == nplc)
		{
			dmm.nplc_index = x;
			dmm.nplc = nplc;
			is_valid = 1;
			break;
		}
		else
		{
			is_valid = 0;
		}
	}

	if(is_valid)
	{
		set_nplc(dmm.nplc_index);
		dmm.zero_done = 0;
		return SCPI_RES_OK;
	}
	else
	{
		SCPI_ErrorPush(context, SCPI_ERROR_DATA_OUT_OF_RANGE);
		return SCPI_RES_ERR;
	}
}


static scpi_result_t SCPI_ConfigureVoltageDCNPLCQ(scpi_t * context)
{
	SCPI_ResultInt32(context, dmm.nplc);
	return SCPI_RES_OK;
}

static scpi_result_t SCPI_ConfigureVoltageDCZeroAuto(scpi_t * context)
{
	int32_t param_zero;

	if(!SCPI_ParamChoice(context, auto_zero_select, &param_zero, TRUE))
	{
		return SCPI_RES_ERR;
	}

	dmm.zero_status  = param_zero;

	return SCPI_RES_OK;
}

static scpi_result_t SCPI_ConfigureVoltageDCZeroAutoQ(scpi_t * context)
{
	SCPI_ResultInt32(context, dmm.zero_status);
	return SCPI_RES_OK;
}

static scpi_result_t SCPI_CalibrationValue(scpi_t * context)
{
	double value = 0.0;
	double measure = 0.0;

	if(!SCPI_ParamDouble(context, &value, TRUE))
	{
		return SCPI_RES_ERR;
	}

	if(0.0 == value)
	{
		set_nplc(dmm.nplc_index);
		measure = get_measure(dmm.adc_raw[dmm.nplc_index], dmm.adc_cf[dmm.nplc_index], 6);
	}



	return SCPI_RES_OK;
}

static scpi_result_t SCPI_CalibrationStore(scpi_t * context)
{
	eeprom_write(dmm.calibration.bytes, STRUCT_SIZE);

	return SCPI_RES_OK;
}

static scpi_result_t TEST_TSQ(scpi_t * context)
{
	meas_path(dmm.range, AUTO_ZERO);
	return SCPI_RES_OK;
}


/**
 * @brief
 * parses lists
 * channel numbers > 0.
 * no checks yet.
 * valid: (@1), (@3!1:1!3), ...
 * (@1!1:3!2) would be 1!1, 1!2, 2!1, 2!2, 3!1, 3!2.
 * (@3!1:1!3) would be 3!1, 3!2, 3!3, 2!1, 2!2, 2!3, ... 1!3.
 *
 * @param channel_list channel list, compare to SCPI99 Vol 1 Ch. 8.3.2
 */

/**
 * Reimplement IEEE488.2 *TST?
 *
 * Result should be 0 if everything is ok
 * Result should be 1 if something goes wrong
 *
 * Return SCPI_RES_OK
 */
static scpi_result_t My_CoreTstQ(scpi_t * context) {

    SCPI_ResultInt32(context, 0);

    return SCPI_RES_OK;
}

const scpi_command_t scpi_commands[] = {
    /* IEEE Mandated Commands (SCPI std V1999.0 4.1.1) */
    { .pattern = "*CLS", .callback = SCPI_CoreCls,},
    { .pattern = "*ESE", .callback = SCPI_CoreEse,},
    { .pattern = "*ESE?", .callback = SCPI_CoreEseQ,},
    { .pattern = "*ESR?", .callback = SCPI_CoreEsrQ,},
    { .pattern = "*IDN?", .callback = SCPI_CoreIdnQ,},
    { .pattern = "*OPC", .callback = SCPI_CoreOpc,},
    { .pattern = "*OPC?", .callback = SCPI_CoreOpcQ,},
    { .pattern = "*RST", .callback = SCPI_CoreRst,},
    { .pattern = "*SRE", .callback = SCPI_CoreSre,},
    { .pattern = "*SRE?", .callback = SCPI_CoreSreQ,},
    { .pattern = "*STB?", .callback = SCPI_CoreStbQ,},
    { .pattern = "*TST?", .callback = My_CoreTstQ,},
    { .pattern = "*WAI", .callback = SCPI_CoreWai,},

    {.pattern = "STATus:QUEStionable[:EVENt]?", .callback = SCPI_StatusQuestionableEventQ,},
    /* {.pattern = "STATus:QUEStionable:CONDition?", .callback = scpi_stub_callback,}, */
    {.pattern = "STATus:QUEStionable:ENABle", .callback = SCPI_StatusQuestionableEnable,},
    {.pattern = "STATus:QUEStionable:ENABle?", .callback = SCPI_StatusQuestionableEnableQ,},

    {.pattern = "STATus:PRESet", .callback = SCPI_StatusPreset,},

    /* Required SCPI commands (SCPI std V1999.0 4.2.1) */
    {.pattern = "SYSTem:ERRor[:NEXT]?", .callback = SCPI_SystemErrorNextQ,},
    {.pattern = "SYSTem:ERRor:COUNt?", .callback = SCPI_SystemErrorCountQ,},
    {.pattern = "SYSTem:VERSion?", .callback = SCPI_SystemVersionQ,},

	{.pattern = "CONFigure:VOLTage:DC", .callback = SCPI_ConfigureVoltageDC,},
	{.pattern = "CONFigure:VOLTage:DC?", .callback = SCPI_ConfigureVoltageDCQ,},

	{.pattern = "CONFigure:VOLTage[:DC]:NPLC", .callback = SCPI_ConfigureVoltageDCNPLC,},
	{.pattern = "CONFigure:VOLTage[:DC]:NPLC?", .callback = SCPI_ConfigureVoltageDCNPLCQ,},
	{.pattern = "CONFigure:VOLTage[:DC]:ZERO:AUTO", .callback = SCPI_ConfigureVoltageDCZeroAuto,},
	{.pattern = "CONFigure:VOLTage[:DC]:ZERO:AUTO?", .callback = SCPI_ConfigureVoltageDCZeroAutoQ,},

//	{.pattern = "[SENSe:]VOLTage[:DC]:ZERO:AUTO", .callback = SCPI_SenseVoltageDCZeroAuto,},
//	{.pattern = "[SENSe:]VOLTage[:DC]:ZERO:AUTO?", .callback = SCPI_SenseVoltageDCZeroAutoQ,},

	{.pattern = "SAMPle:COUNt", .callback = SCPI_SampleCount,},
	{.pattern = "SAMPle:COUNt?", .callback = SCPI_SampleCountQ,},

//	{.pattern = "CALibration:ADC?", .callback = SCPI_CalibrationADCQ,},
	{.pattern = "CALibration:VALue", .callback = SCPI_CalibrationValue,},
//	{.pattern = "CALibration:VALue?", .callback = SCPI_CalibrationValueQ,},
//	{.pattern = "CALibration[:ALL]?", .callback = SCPI_CalibrationAllQ,},
	{.pattern = "CALibration:STORe", .callback = SCPI_CalibrationStore,},

	{.pattern = "MEASure[:VOLTage]:DC?", .callback = SCPI_MeasureVoltageDCQ,},

	{.pattern = "TS?", .callback = TEST_TSQ,},

		SCPI_CMD_LIST_END
};

scpi_interface_t scpi_interface = {
    .error = SCPI_Error,
    .write = SCPI_Write,
    .control = SCPI_Control,
    .flush = SCPI_Flush,
    .reset = SCPI_Reset,
};

char scpi_input_buffer[SCPI_INPUT_BUFFER_LENGTH];
scpi_error_t scpi_error_queue_data[SCPI_ERROR_QUEUE_SIZE];

scpi_t scpi_context;
