mfkiwl/ADC_Test-icd40hx/software/FPGA/pll.v

/**
 * PLL configuration
 *
 * This Verilog module was generated automatically
 * using the icepll tool from the IceStorm project.
 * Use at your own risk.
 *
 * Given input frequency:       100.000 MHz
 * Requested output frequency:   40.000 MHz
 * Achieved output frequency:    40.000 MHz
 */

module pll(
	input  clock_in,
	output clock_out,
	output locked
	);

SB_PLL40_CORE #(
		.FEEDBACK_PATH("SIMPLE"),
		.DIVR(4'b0100),		// DIVR =  4
		.DIVF(7'b0011111),	// DIVF = 31
		.DIVQ(3'b100),		// DIVQ =  4
		.FILTER_RANGE(3'b010)	// FILTER_RANGE = 2
	) uut (
		.LOCK(locked),
		.RESETB(1'b1),
		.BYPASS(1'b0),
		.REFERENCECLK(clock_in),
		.PLLOUTCORE(clock_out)
		);

endmodule
