mfkiwl/ADC_Test-icd40hx/(commit log)

2020-10-08 Schematic design.
    [ADC.sch, ADC_Test.sch, Connector.sch, Ethernet.sch, FPGA.sch, Input.sch, MCU.sch, Power.sch]
2020-10-08 Calculated voltages for the voltage sources.
    [Power.sch]
2020-10-08 Replaced TL061 with AD711.
    [Input.sch]
2020-10-08 Schematic, PCB and BOM.
    [ADC.sch, ADC_Test.csv, ADC_Test.ods, ADC_Test.sch, Connector.sch, Ethernet.sch, FPGA.sch, Input.sch]
2020-10-09 Changes in documentation, schematics and PCB.
    [ADC.sch, ADC_Test.kicad_pcb, ADC_Test.sch, Connector.sch, Ethernet.sch, FPGA.sch, Input.sch, MCU.sch]
2020-10-11 PCB design
    [ADC.sch, ADC_Test.kicad_pcb, ADC_Test.sch, Connector.sch, Ethernet.sch, FPGA.sch, Input.sch, MCU.sch]
2020-10-11 PCB design.
    [ADC.sch, ADC_Test.kicad_pcb, ADC_Test.sch, FPGA.sch, Input.sch, MCU.sch, Power.sch]
2020-10-12 PCB layout almost done.
    [ADC_Test.kicad_pcb]
2020-10-12 PCB design done.
    [ADC.sch, ADC_Test.kicad_pcb, ADC_Test.sch, ADC_Test_Add.ods, MCU.sch]
2020-10-13 Added STM32 project.
    [ADC_Test_Add.ods]
2020-11-03 MCU readout from FPGA works.
    [ADC_Test.kicad_pcb, Input.sch]
2020-11-06 Problems with data from FPGA.
    [ADC_TEST_MCU.ioc, bsp_74hc595.c, bsp_74hc595.h, main.c, main.h, pll.v, scpi_def.c, vm_mini_t.v]
2020-11-07 ADC works.
2020-11-08 MCU sofware development.
    [ADC_Test.kicad_pcb]
2020-11-09 Modified the measurement functions. PCB ready for calibration.
2020-11-10 Calibrated ADC with a Inmel 7000 calibrator. Gain and offset values are in main.h.
